0-0REL/Dron/README.md

# Dron CIC
[Ver](./doc/main.pdf) para detalles
