0-0REL/Dron/doc/main.tex

\documentclass[10pt]{article}  

%%%%%%%% PREÁMBULO %%%%%%%%%%%%
\title{Plantilla para Reportes Servicio Social y Practicas Profesionales}
\usepackage[spanish]{babel} %Indica que escribiremos en español
\usepackage[utf8]{inputenc} %Indica qué codificación se está usando ISO-8859-1(latin1)  o utf8
\usepackage{csquotes} % Requerido por biblatex con babel
\usepackage[style=ieee]{biblatex} % Sistema moderno de bibliografía
\addbibresource{Dron.bib} % Archivo de referencias
\usepackage{arydshln}
\usepackage{dirtree}

\usepackage{amsmath} % Comandos extras para matemáticas (cajas para ecuaciones,
% etc)
\usepackage{amssymb} % Símbolos matemáticos (por lo tanto)
\usepackage{graphicx} % Incluir imágenes en LaTeX
\usepackage{color} % Para colorear texto
\usepackage{subfigure} % sub figuras
\usepackage{float} %Podemos usar el especificador [H] en las figuras para que se
% queden donde queramos
\usepackage{capt-of} % Permite usar etiquetas fuera de elementos flotantes
% (etiquetas de figuras)
\usepackage{sidecap} % Para poner el texto de las imágenes al lado
	\sidecaptionvpos{figure}{c} % Para que el texto se alinie al centro vertical
\usepackage{caption} % Para poder quitar numeracion de figuras
\usepackage{commath} % funcionalidades extras para diferenciales, integrales,
% etc (\od, \dif, etc)
\usepackage{cancel} % para cancelar expresiones (\cancelto{0}{x})
 
\usepackage{anysize} 					% Para personalizar el ancho de  los márgenes
\marginsize{2cm}{2cm}{2cm}{2cm} % Izquierda, derecha, arriba, abajo

\usepackage{appendix}
\renewcommand{\appendixname}{Apéndices}
\renewcommand{\appendixtocname}{Apéndices}
\renewcommand{\appendixpagename}{Apéndices} 

% Para que las referencias sean hipervínculos a las figuras o ecuaciones y
% aparezcan en color
\usepackage[colorlinks=true,plainpages=false,citecolor=blue,linkcolor=blue]{hyperref}
%\usepackage{hyperref} 
% Para agregar encabezado y pie de página
\usepackage{fancyhdr} 
\pagestyle{fancy}
\fancyhf{}
\fancyhead[L]{\footnotesize Instituto Politécnico Nacional - Centro de Investigación en Computación} %encabezado izquierda
\fancyhead[R]{\footnotesize ESIME}   % dereecha
\fancyfoot[R]{\footnotesize Reporte}  % Pie derecha
\fancyfoot[C]{\thepage}  % centro
\fancyfoot[L]{\footnotesize Lab. Robótica y Mecatrónica}  %izquierda
\renewcommand{\footrulewidth}{0.4pt}

\usepackage{listings} % Para usar código fuente
\definecolor{dkgreen}{rgb}{0,0.6,0} % Definimos colores para usar en el código
\definecolor{gray}{rgb}{0.5,0.5,0.5} 
% configuración para el lenguaje que queramos utilizar
\lstset{language=Matlab,
   keywords={break,case,catch,continue,else,elseif,end,for,function,
      global,if,otherwise,persistent,return,switch,try,while},
   basicstyle=\ttfamily,
   keywordstyle=\color{blue},
   commentstyle=\color{red},
   stringstyle=\color{dkgreen},
   numbers=left,
   numberstyle=\tiny\color{gray},
   stepnumber=1,
   numbersep=10pt,
   backgroundcolor=\color{white},
   tabsize=4,
   showspaces=false,
   showstringspaces=false}

% C (configuración nueva)
\lstdefinestyle{c}{
    language=C,
    keywords={break,case,char,const,continue,default,do,double,else,
              enum,extern,float,for,goto,if,int,long,register,return,
              short,signed,sizeof,static,struct,switch,typedef,union,
              unsigned,void,volatile,while},
    basicstyle=\ttfamily\footnotesize,
    keywordstyle=\color{blue},
    commentstyle=\color{red!60!black},
    stringstyle=\color{green!50!black},
    numbers=left,
    numberstyle=\tiny\color{gray},
    stepnumber=1,
    numbersep=8pt,
    backgroundcolor=\color{white},
    tabsize=4,
    showspaces=false,
    showstringspaces=false,
    frame=tb,  % Marco solo arriba y abajo
    rulesepcolor=\color{lightgray}
}

\newcommand{\sen}{\operatorname{\sen}}	% Definimos el comando \sen para el seno
%en español

\title{Plantilla para Reportes Servicio Social y Practicas Profesionales}

%%%%%%%% TERMINA PREÁMBULO %%%%%%%%%%%%

\begin{document}

%%%%%%%%%%%%%%%%%%%%%%%%%%%%%%%%%% PORTADA %%%%%%%%%%%%%%%%%%%%%%%%%%%%%%%%%%%%%%%%%%%%
																					%%%
\begin{center}																		%%%
\newcommand{\HRule}{\rule{\linewidth}{0.5mm}}									%%%\left
 																					%%%
\begin{minipage}{0.48\textwidth} \begin{flushleft}
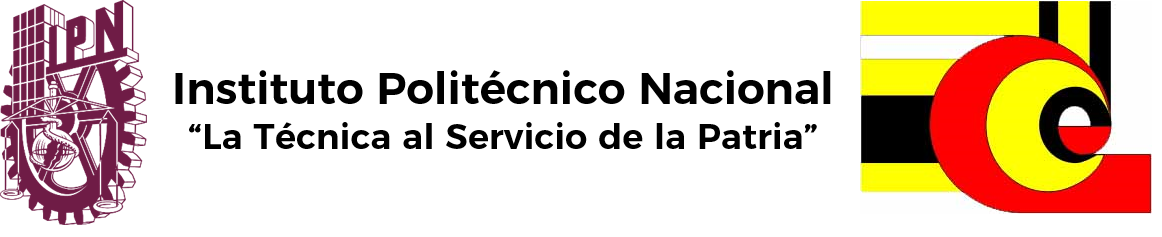
[picture p1: doc/Imagenes/nuist.png]

\end{flushleft}\end{minipage}
\begin{minipage}{0.48\textwidth} \begin{flushright}
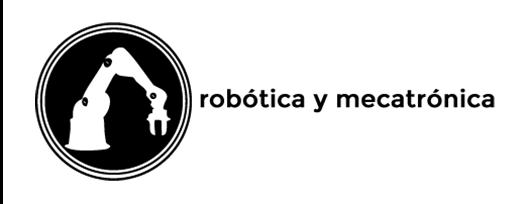
[picture p2: doc/Imagenes/rym2.png]

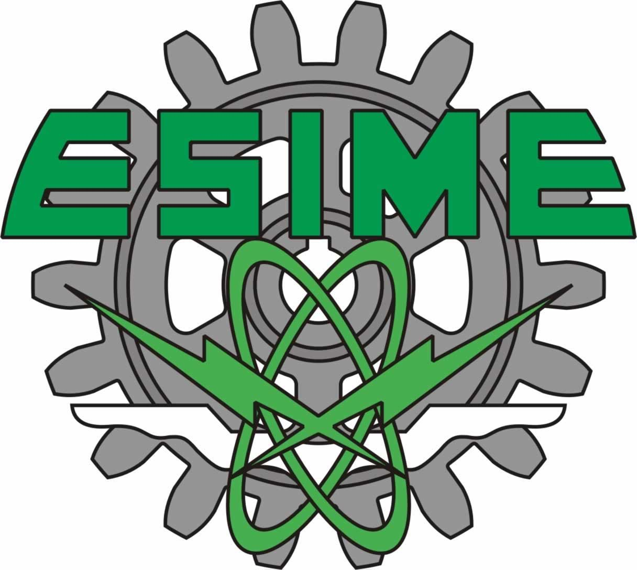
[picture p3: doc/Imagenes/esime.jpg]

\end{flushright}\end{minipage}

													 								%%%
\vspace*{1.0cm}								%%%
																					%%%	
\textsc{\huge Instituto Politécnico Nacional \\ \vspace{5px} Centro de Investigación en Computación \\	
\vspace{5px} Lab. Robótica y Mecatrónica}\\[0.25cm]	

\textsc{\LARGE \\ \vspace{5px} Practicas }\\[1.5cm]													%%%

\begin{minipage}{0.9\textwidth} 
\begin{center}																					%%%
\textsc{\LARGE Dron }
\end{center}
\end{minipage}\\[0.5cm]
%%%
    																				%%%
 			\vspace*{1cm}																		%%%
																					%%%
\HRule \\[0.4cm]																	%%%
{ \huge \bfseries Control de vuelo y detección y seguimiento de rostros}\\[0.4cm]	%%%
 																					%%%
\HRule \\[1.5cm]																	%%%
 																				%%%
																					%%%
\begin{minipage}{0.46\textwidth}													%%%
\begin{flushleft} \large															%%%

% Aqui a continuación pongan los nombres de los integrantes
\emph{Autores:}\\	
Rodrigo Emmanuel Arellano Flores
%%%
			%\vspace*{2cm}	
            													%%%
										 						%%%
\end{flushleft}																		%%%
\end{minipage}		
																%%%
\begin{minipage}{0.52\textwidth}		
\vspace{-0.6cm}											%%%
\begin{flushright} \large															%%%
\emph{Profesores:} \\	
Dr. Jesús Yaljá Montiel Pérez\\																%%%
Prof. Dr. Juan Humberto Sossa Azuela\\
												%%%
\end{flushright}																	%%%
\end{minipage}	
\vspace*{1cm}
%\begin{flushleft}
 	
%\end{flushleft}
%%%
% 		\flushleft{\textbf{\Large Nombre del curso (IMEC XXZZ)}	}\\																		%%%
\vspace{2cm} 																				
\begin{center}	
CDMX. \\
%{\large \today}																	%%%
 			\end{center}												  						
\end{center}							 											
																					
\newpage																		
%%%%%%%%%%%%%%%%%%%% TERMINA PORTADA %%%%%%%%%%%%%%%%%%%%%%%%%%%%%%%%

\tableofcontents 

\newpage

\section{Resumen.}
%Lo que se hizo, para qué sirve, cómo se hizo , qué resultados se obtuvieron, y porqué es importante haber logrado esto.  (de 120 palabras máximo).
%Ejemplo de cómo dar una cita bibliográfica
\section{Introducción.} 
%Lo que Ud. escriba aquí debe responder a las preguntas hechas por cualquier lector en el mundo: 
% ¿De qué se trata este trabajo?
% ¿Por qué estas personas hicieron este trabajo?
% ¿Por qué vale la pena leerlo, y a quienes le puede interesar leerlo?
% ¿Qué tiene de original o importante lo hecho aquí?
% ¿Qué tan difícil fue lograr los resultados que se muestran aquí?
% Puede incluir dibujos si los necesita para explicar y/o fotografías
\section{Información preliminar.}
% ¿ Qué otros trabajos o desarrollos similares se han hecho?
% ¿Cuál es la diferencia de este respecto a aquellos?
% ¿Qué modelos, teorías o cuerpos de conocimiento hay que tener presentes para leer el resto del trabajo presentado.
% NO REPITA lo que otros ya escribieron y presentaron en documentos digitales (web/o textos). 
% Describa lo que se necesita para entender SU trabajo en sus PROPIAS palabras.
% Necesariamente debe nombrar los documentos o autores a los que hace referencia (citelos) y sobretodo genere sus propios análisis al respecto.
% Solo haga mención explícita de lo que Ud. VA A usar en su trabajo. 
% Temas relacionados pero QUE NO se van a usar pueden mencionarse como citas.
\input{preliminar}
\section{Metodologías.}
% Diga cómo se hizo lo que ud. (o uds) hicieron.
% Sea claro y preciso.
% Si alguien quiere repetir su trabajo, debe poder usar esto como guía.
% Registre cada una de las iteraciones seguidas por sus procesos de diseño.
% Si hubo trabajo en equipo, aquí debe quedar especificada la participación de cada uno.
% Aquí deben estar registradas (como mínimo) los siguientes :
%  Diagramas de cuerpo libre,
%  diagramas de cortante y momentos,
%  diagramas de torsión,
%  cálculos de velocidades,
%  análisis de aceleraciones y
%  análisis de fuerzas,
%  análisis de fatiga si es el caso,
%  calculo de los factores de Marin y
%  uso de variables estocásticas,
% análisis de pandeo,
%  diseño de ejes,
%  diseño de sujetadores y uniones si los hay, etc
\input{metodologias}
\section{Conclusiones.}
%Explique por qué su diseño sirve (o nó) y qué hace falta por hacer.
%Responda las expectativas generadas en la Introducción.
%Analice sus resultados críticamente y diga si son creíbles y responda
%qué tan seguras son sus propuestas
\begin{figure}[H]
	\centering
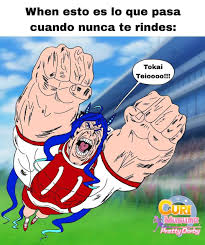
[picture p4: doc/Imagenes/turbo.jpeg]
	
	\caption{Esto es lo que pasa cuando nunca te rindes}
\end{figure}

%%%%%%% Bibliografía %%%%%%%%
\printbibliography[title={Referencias}]
%%%%%%% Bibliografía %%%%%%%%    

\appendix  
\clearpage % o \cleardoublepage
\addappheadtotoc 
\appendixpage 

\section{Memoria de cálculos.}
%Digitalice sus manuscritos y los procedimientos de cálculo utilizados. Deben ser legibles y claros.
%< Documentos escaneados> con algunas explicaciones.
%Si prefiere escribir todos sus cálculos usando fórmulas de LATEX hágalo a través de la metodología.
\section{Algoritmos.}
\lstinputlisting[language=C, breaklines=true, caption={AHRS Madwgick.h}]{../../rama-dron/navio2/include/AHRS/MadgwickAHRS.h}
\lstinputlisting[language=C, breaklines=true, caption={AHRS Madwgick.c}]{../../rama-dron/navio2/src/lib/AHRS/MadgwickAHRS.c}
 \section{Planos}
%Los planos del diseño presentado deben estar aquí. Generados por NX/Solid-edge.
\begin{center}
   
   
\end{center}
\end{document}
