0-0REL/Dron/doc/main.pdf

Instituto Politécnico Nacional - Centro de Investigación en Computación | ESIME

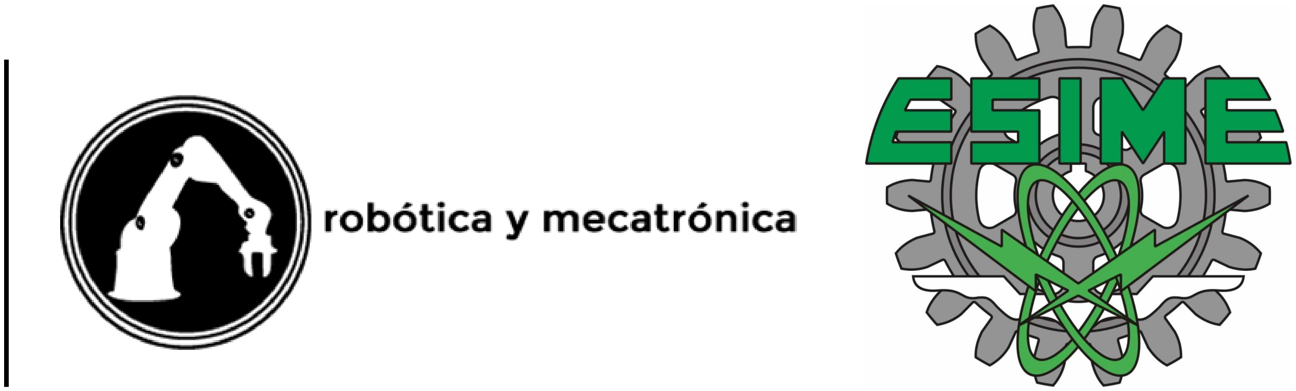
[picture p6: figure]
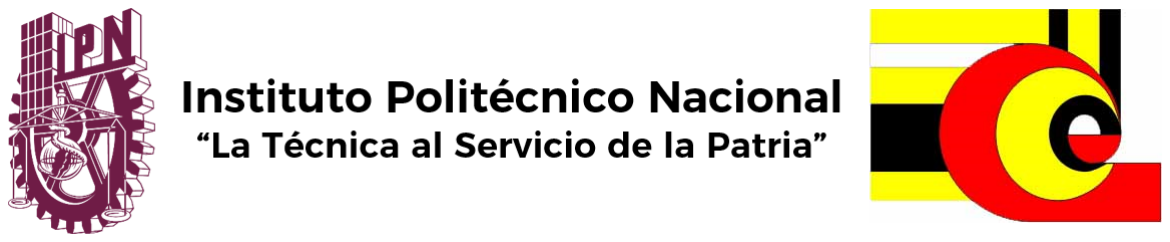
[picture p7: figure]

### Instituto Politecnico Nacional ´

Centro de Investigacion en Computaci ´ | on´
Lab. Robotica y Mecatr ´ | onica ´

Practicas

Dron

# Control de vuelo y detección y seguimiento de rostros

### Autores: Rodrigo Emmanuel Arellano Flores

### Profesores: Dr. Jesús Yaljá Montiel Pérez Prof. Dr. Juan Humberto Sossa Azuela

CDMX.

Lab. Robótica y Mecatrónica | 1 | Reporte

## Índice

1. Resumen. | 3
2. Introducción. | 3
3. Información preliminar. | 3
4. Metodologías. | 6
5. Conclusiones. | 17
Apéndices | 18
A. Memoria de cálculos. | 18
B. Algoritmos. | 18
C. Planos | 25
Lab. Robótica y Mecatrónica | 2 | Reporte

1. Resumen.
2. Introducción.
3. Información preliminar.

### 3.1. Orden del repositorio

El repositorio se encuentra en GitHub (https://github.com/0-0REL/Dron) y se divide en tres ramas
Dron
main | #Rama principal
ArduPilot/ | Desarrollo con el AMP2.6
bash scripts/ | Scripts para iniciar GCS o simulación
Dron/ | Logs de pruebas de vuelo
MAVLink/ | Pruebas con MAVLink
MP Python scripts/ | Pruebas con scripts de Mission Planner
sik-radio-config/ | Reconfiguración de radios
simulaciones/ | Resultados de simulaciones del articulo
Complementos/ | Software auxiliar
CAD | Modelos 3D en Inventor
Modelos/ | Modelos para Detección
doc/ | Este archivo
MATLAB/ | Simulacion en simulink y desarrollo de controladores
control pid/
simmat/
simulink/
Navio2/ | Logs de dron con Navio2
magnetometro/ | Calibración de magnetómetro
ROS/
visualizacion/ | Visualizar orientación
OpenCV/
prototipo/ | Versión funcional
pruebas/
TensorFlow/ | Entrenamiento de modelo de reconocimiento
dataset/
apm-ros-jazzy | #Rama con paquetes ROS-Jazzy para simulación
mav ctrl/
vision/
ros-pkg-navio | #Rama con paquetes ROS-Noetic para navio2
navio2/ | Procesamiento de sensores
sys ctrl/ | Controlador de vuelo
vision/ | Detección de rostros
El HAT Navio2 es compatible con las Raspberry Pi 2, 3 y 4. La imagen del sistema necesaria se encuentra aquí. (https://docs.emlid.com/navio2/configuring-raspberry-pi/) El sistema no tiene interfaz gráfica y funciona en arquitectura armv7l.
Para poder establecer un acceso remoto al Raspberry del dron incluso fuera de red local, se puede usar el servicio VPN de Tailscale. (https://tailscale.com/kb/1017/install)

### 3.2. Componentes del cuadricóptero

El dron cuenta con los siguientes componentes:

4 Motores sin escobillas (BLDC)

4 Control de velocidad electrónico (ESC)

1 Batería LiPo 11.1 V

Lab. Robótica y Mecatrónica | 3 | Reporte

1 Computadora de vuelo, cuenta con:

- IMU (acelerómetro, giroscopio y magnetómetro)
- Barómetro

1 Chasis

2 Helices CW

2 Helices CCW

### 3.3. Control del cuadricóptero

El dron utiliza un marco X y el orden de los motores asi como su dirección de giro se puede ver en la figura 1.

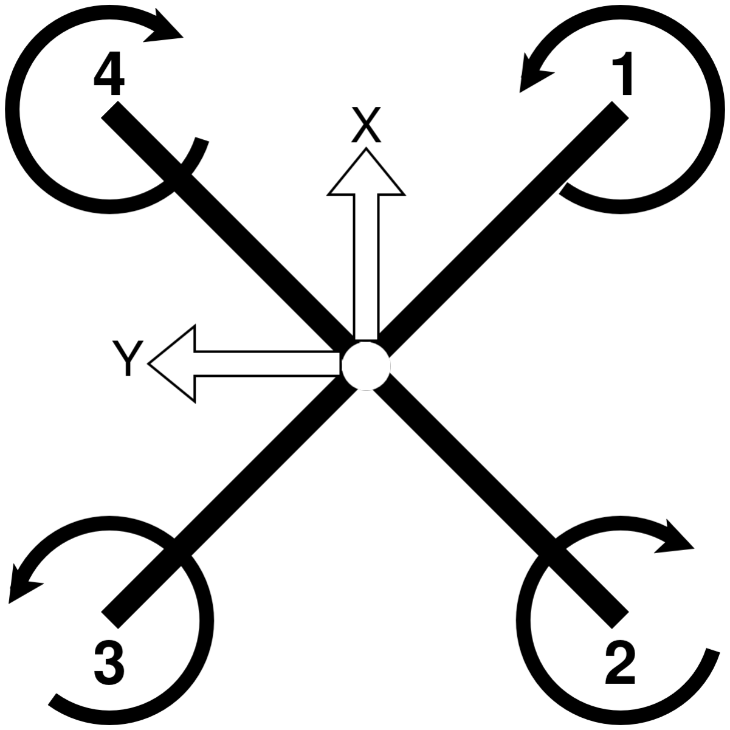
[picture p8: figure]

Figura 1: Marco

El par y empuje generados por cada motor están dados por:

Fi = KF ω

2
i

(1)

τi = KMω

2
i

(2)

De modo que la relación entre la acción de cada motor y las entradas de control se relacionan de la siguiente forma

F
τx
τy
τz

=

KF | KF | KF | KF
−KF L −KF L | KF L | KF L
−KF L | KF L | KF L | −KF L
−KM | KM | −KM | KM

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
El modelo dinámico del dron se puede linealizar el modelo del dron mediante la serie de Taylor [1]

x˙ = f(x, u)x0,u0 +

∂
∂x

f(x, u)

(x0,u0)

(x − x0) + ∂
∂u

f(x, u)

(x0,u0)
(u − u0) = Ax + Bu | (4)

x0 = 012×1

u0 =

mg 0 0 0T

El modelo en espacio de estados se puede convertir a funciones de trasferencia mediante

G(s) = C [sI − A]

−1 B + D | (5)

El controlador PD tiene la siguiente estructura

P D(s) = KP + KDs = KD(s + a) | (6)

KP = aKD

Lab. Robótica y Mecatrónica | 4 | Reporte

El controlador PID tine la siguiente estructura

P ID(s) = KP +

KI
s

+ KDs = KD

(s + a)(s + b)
s

(7)

KI = abKD

KP = (a + b)KD

Seguimiento de referencia en control en espacio de estados Precompensador discreto [2]
u(k) = −Kx(k) + Nr(k) | (8)

N = [Cd[I − Ad + BdK]

−1Bd]

−1
(9)

Modelo Interno para entrada escalón [2]
x(k + 1)

e(k + 1)
=
A 0

−C I x(k)
e(k)
+
B
0
u(k) | (10)

u(t) = −Kx(k) − Kee(k)

### 3.4. Procesamiento de sensores

### 3.4.1. IMU

Se pueden estimar los ángulos de orientación roll (ϕ) y pitch (θ) mediante un filtro complementario (11) que es una forma simple de fusionar la información del giroscopio y acelerómetro. Sin embargo, al ser una técnica simple esta limitado a movimientos suaves aun asi puede ser utilizado para lograr estabilización del dron.

θ = α(θ(k − 1) + ωgyroT) + (1 − α)θacc(k) | (11)

ϕacc = p

accy
acc²

x + acc²
z

(12)

θacc = −q

accx

acc²

y + acc²
z

(13)

El rumbo (yaw → ψ) se puede obtener mediante

ψ = atan2(magy, magx) − δ | (14)

La declinación magnética (δ) se puede obtener de [3]. Una mejor forma de obtener la orientación espacial del dron es mediante un algoritmo AHRS (Attitude and Heading Reference System), el filtro Mahony y Madgwick son dos excelentes opciones por su baso costo computacional, se selecciona el filtro Madgwick ya que es más preciso que el Mahony y Kalman [4], aunque no mejor que el Kalman extendido [5]. El algoritmo proporciona la orientación en cuaterniones, los cuales pueden ser convertidos a ángulos de Euler mediante.

ϕ = atan2(2(q0q1 + q2q3), 1 − 2(q1q1 + q2q2)) | (15)
θ = asin(2(q0q2 − q3q1)) | (16)
ψ = atan2(2(q0q3 + q1q2), 1 − 2(q2q2 + q3q3)) | (17)

### 3.4.2. Barómetro

La altura ortométrica [6] se calcula con la información del barómetro mediante la siguiente ecuación

Hb =

Ts
kT

pb
ps

RkT
g0 − 1

!
(18)

Donde:

Lab. Robótica y Mecatrónica | 5 | Reporte

R 287.1 J/kgK

kT 6.5×10⁻³ K/m

g0 9.80665 m/s²

ps 101.325 kPa

Ts 288.15 K

4. Metodologías.

### 4.1. Medición de empuje

Para estimar KF de (1) se mide el empuje generado cada 10 % de cambio en la velocidad del motor. Las siguientes medidas fueron realizadas a 11.2 V, el motor y hélice tienen una masa de 120 g.

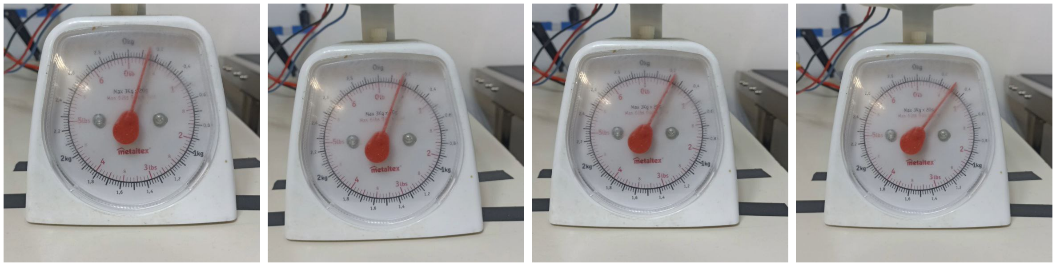
[picture p9: figure]

(a) 1100 ms → 140 g | (b) 1200 ms → 170 g | (c) 1300 ms → 220 g | (d) 1400 ms → 300 g

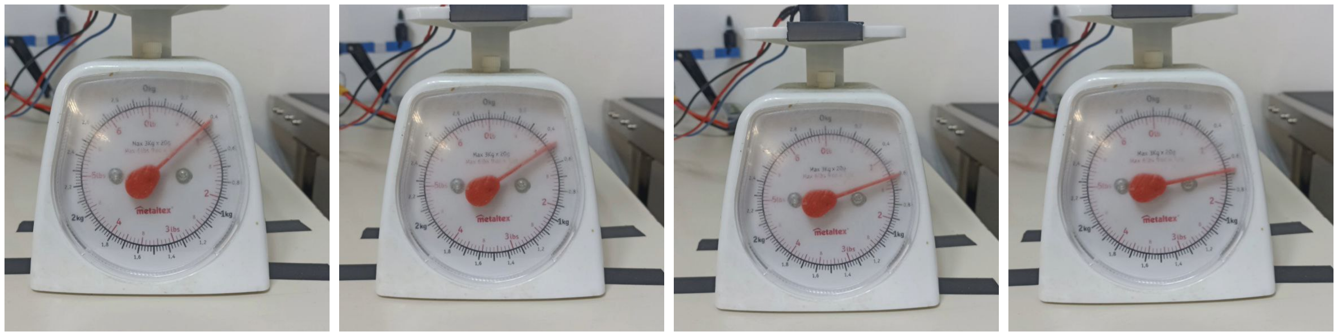
[picture p10: figure]

(e) 1500 ms → 400 g | (f) 1600 ms → 490 g | (g) 1700 ms → 600 g | (h) 1800 ms → 670 g

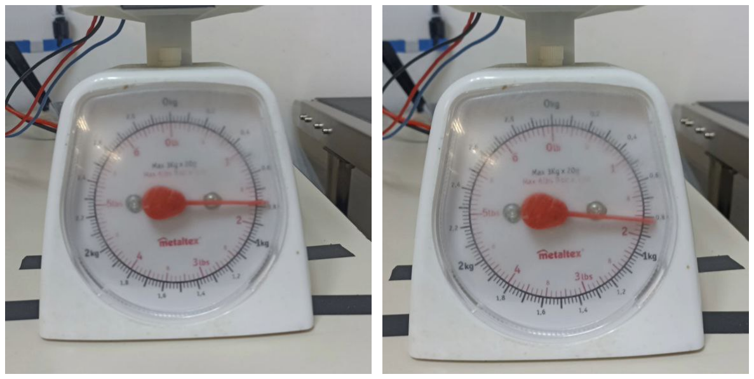
[picture p11: figure]

(i) 1900 ms → 770 g | (j) 2000 ms → 820 g

Figura 2: Medición de empuje

Lab. Robótica y Mecatrónica | 6 | Reporte

Cuadro 1: Medición prueba de empuje

Señal ( %) | Medido (g) | Empuje (g)
0 | 120 | 0
10 | 140 | 20
20 | 170 | 50
30 | 220 | 100
40 | 300 | 180
50 | 400 | 280
60 | 490 | 370
70 | 600 | 480
80 | 670 | 550
90 | 770 | 650
100 | 820 | 700

Con estos datos se puede ajustar la curva para obtener KF = 7,965 N/ %²

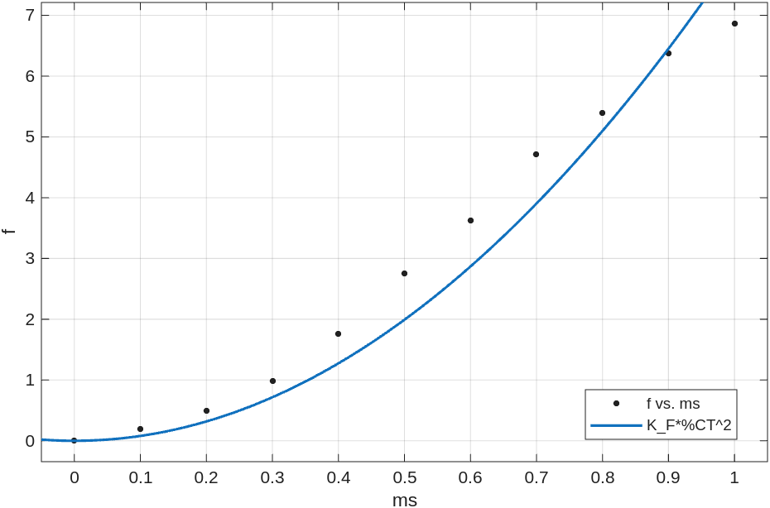
[picture p12: figure]

Figura 3: Ajuste de curva

Lab. Robótica y Mecatrónica | 7 | Reporte

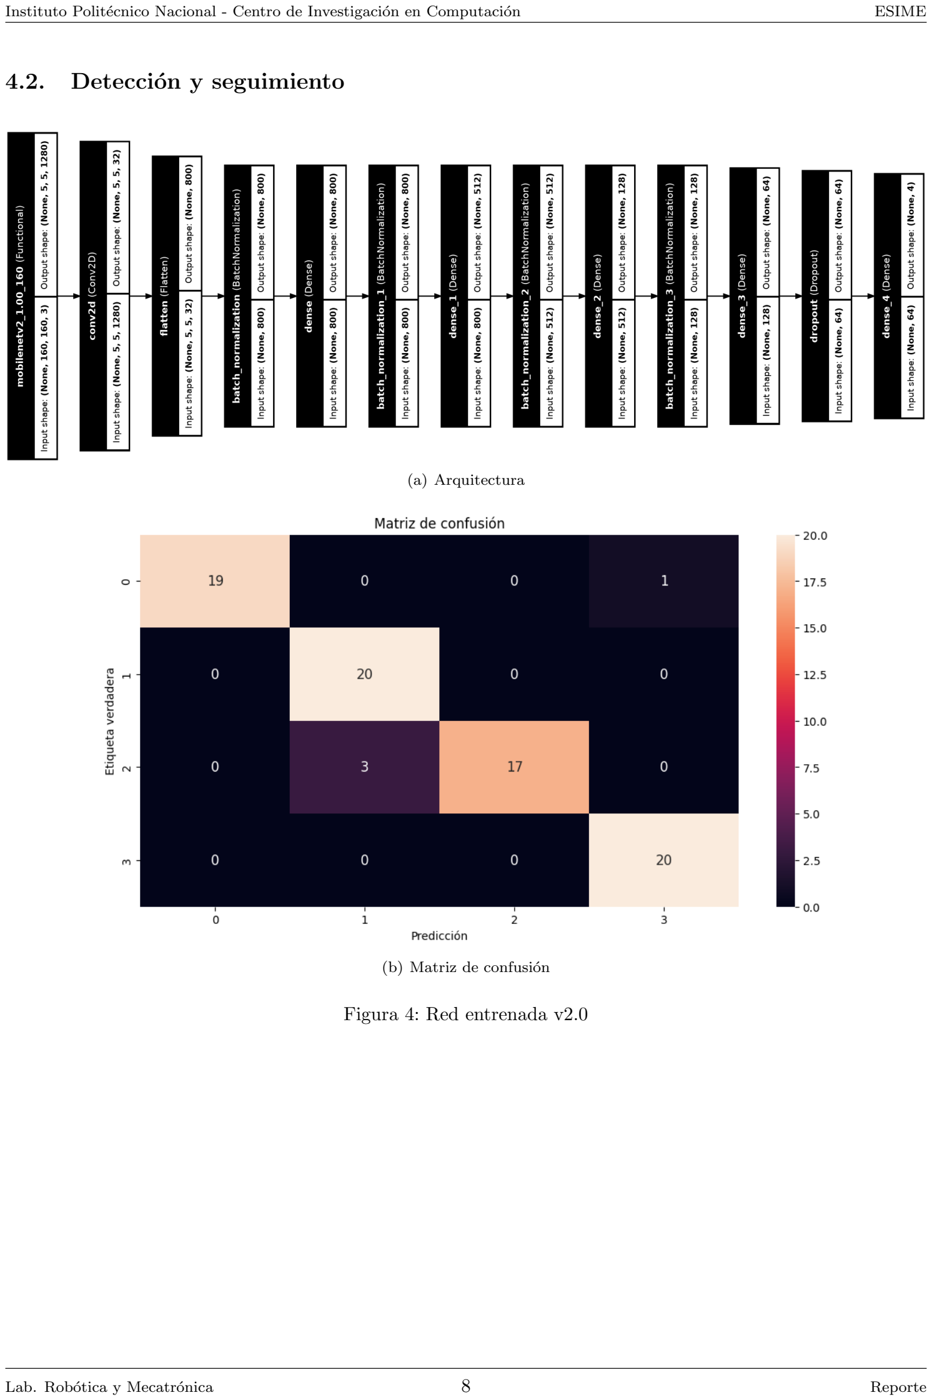
[picture p13: page 8]

### 4.2. Detección y seguimiento

(a) Arquitectura
(b) Matriz de confusión

Figura 4: Red entrenada v2.0

Lab. Robótica y Mecatrónica | 8 | Reporte

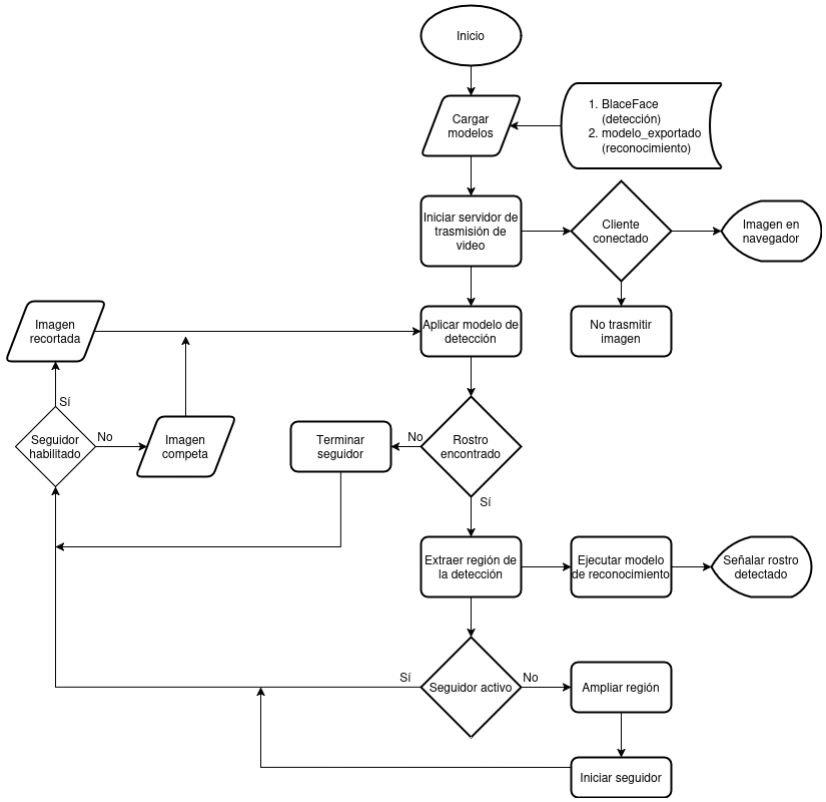
[picture p14: figure]

Figura 5: aBlaze.py

### 4.3. Dinámica

El modelo dinámico del cuadricóptero es

m¨r = Rϕ,θ,ψ

0
0
F
- −

0
0
mg
- − Ff | (19)
M(η)η¨ = τ − C(η, η˙)η˙ − τ f | (20)

De (3) se obtiene la relación entre entradas de control y actuadores

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
4 KF

−

1
4 KF L −

1
4 KF L −

1
4 KM 1

4 KF

−

1
4 KF L

1
4 KF L

1
4 KM 1

4 KF

1
4 KF L

1
4 KF L −

1
4 KM 1

4 KF

1
4 KF L −

1
4 KF L

1
4 KM

F
τx
τy
τz

(21)

Lab. Robótica y Mecatrónica | 9 | Reporte

Cuadro 2: Parámetros del dron

m | 1.6 | kg
Ixx | 0.021915027 | kgm²
Iyy | 0.022124548 | kgm²
Izz | 0.042349865 | kgm²
L | 0.23 | m
KF | 7.965 | N/ %²
KM | 0.5 | Nm/ %²
Km | 50.0565 | s⁻¹

### 4.3.1. Linealización

Mediante la serie de Taylor (4) el modelo del cuadricóptero se puede expresar de forma lineal de la siguiente forma

r˙
¨r
η˙
η¨

=

03×3 | I3×3 | 03×3 | 03×3
03×3 | 03×3 | G(ψd) 03×3
03×3 | 03×3 | 03×3 | I3×3
03×3 | 03×3 | 03×3 | 03×3

r
r˙
η
η˙

+

05×1 | 05×3
m⁻¹ | 01×3
03×1 | 03×3
03×1 | Id

F
τ
(22)

donde:

r =

x
y
z
- , η =

ϕ
θ
ψ
- , τ =

τx
τy
τz

G(ψd) =

0 g 0
−g 0 0
0 0 0
- , Id = diag
I

−1

xx , I⁻¹

yy , I⁻¹

zz

### 4.4. Algoritmos de control

### 4.4.1. PD

El controlador se ajusta usando funciones de trasferencia, que se obtienen mediante (5), con

C =

I3×3 | 03×3 | 03×3 | 03×3
03×3 | 03×3 | I3×3 | 03×3

D = 06×4

Gx(s) = g Iyys

4

(23)

Gy(s) = − | g Ixxs

4

(24)

Gz(s) = 1
| ms²

(25)

Gϕ(s) = 1 Ixxs

2

(26)

Gθ(s) = 1 Iyys

2

(27)

Gψ(s) = 1 Izzs

2

(28)

Dado que no se puede medir los desplazamientos en x y y, solo se realizan 4 de los 6 controladores (control de orientación y altura). El cambio de velocidad en los motores no es instantáneo, por lo que las ecuaciones (25)-(28) se multiplican por (29), que es la función de trasferencia de los motores, para incluir el retraso.

ω˙(t) = Km(ωd(t) − ω(t)) → | ω(s) ωd(s)
=

Km
s + Km

(29)

Lab. Robótica y Mecatrónica | 10 | Reporte

Para ajustar los controladores se utiliza el método de colocación de las raíces, de modo que (25) a (28) se convierten en

KDz

(s + az)

Km
m
s

2(s + Km)

(30)

KDϕ

(s + aϕ)

Km
Ixx
s

2(s + Km)

(31)

KDθ

(s + aθ)

Km
Iyy
s

2(s + Km)

(32)

KDψ

(s + aψ)

Km
Izz
s

2(s + Km)

(33)

Con la ayuda MATLAB se ajustan los ceros y ganancias hasta obtener los siguiente resultados.

Cuadro 3: Ganancias PD

| KP | KD
Altura | 32.9186 | 20.994
Roll | 1.498320 | 0.352480
Pitch | 1.512645 | 0.355850
Yaw | 2.895440 | 0.681153

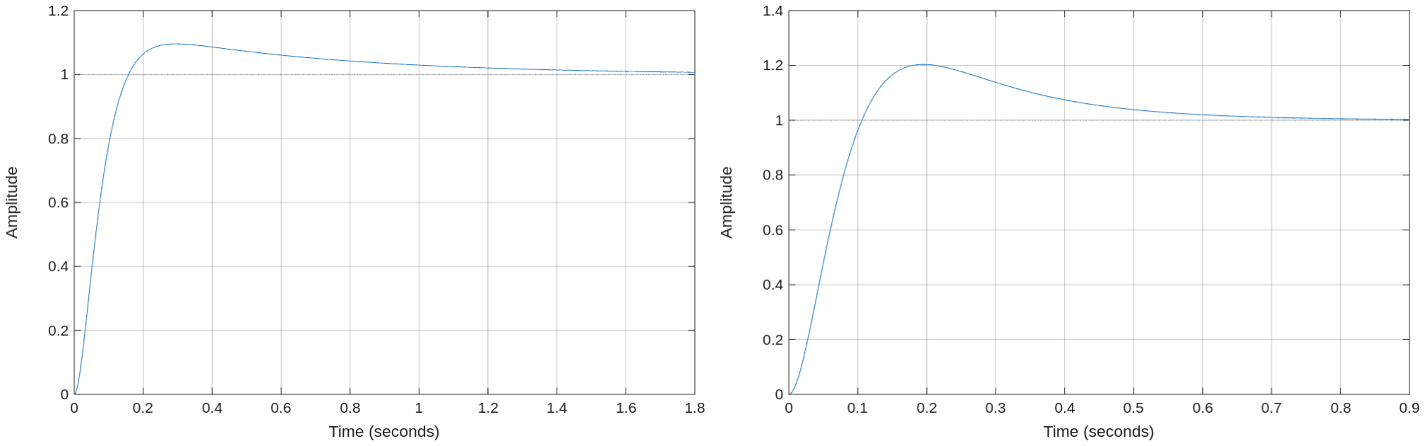
[picture p15: figure]

(a) Altura | (b) Roll

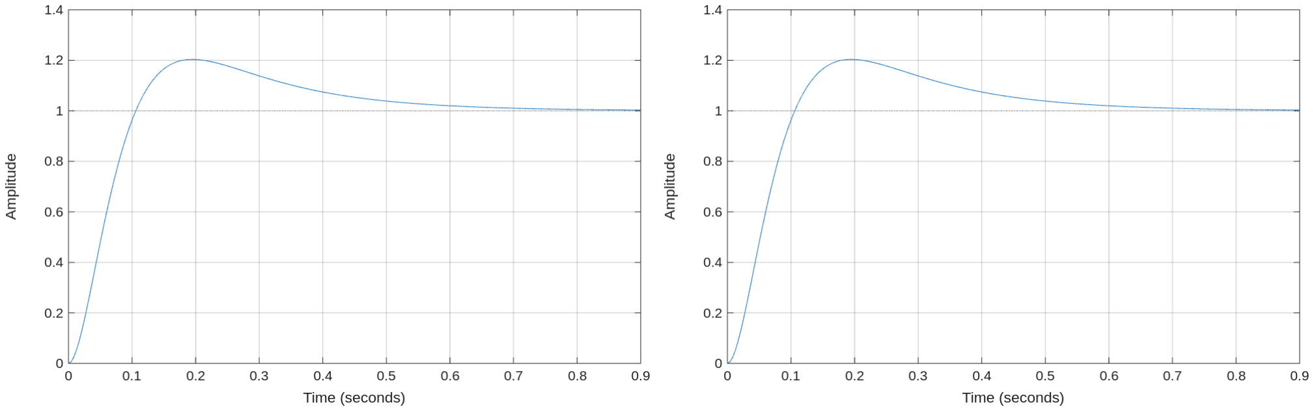
[picture p16: figure]

(c) Pitch | (d) yaw

Figura 6: Respuesta escalón PD

Lab. Robótica y Mecatrónica | 11 | Reporte

### 4.4.2. PID

De forma similar se ajustan las ganancias del controlador, para este caso se usan

KDz

(s + az)(s + bz)

Km
m
s

2(s + Km)

(34)

KDϕ

(s + aϕ)(s + bϕ)

Km
Ixx
s

2(s + Km)

(35)

KDθ

(s + aθ)(s + bθ)

Km
Iyy
s

2(s + Km)

(36)

KDψ

(s + aψ)(s + bψ)

Km
Izz
s

2(s + Km)

(37)

Cuadro 4: Ganancias PID

| KP | KI | KD
Altura | 29.28 | 0.8 | 38.21
Roll | 1.016 | 0.08 | 0.2
Pitch | 2.873 | 1.173 | 0.6391
Yaw | 3.329 | 1.211 | 2.288

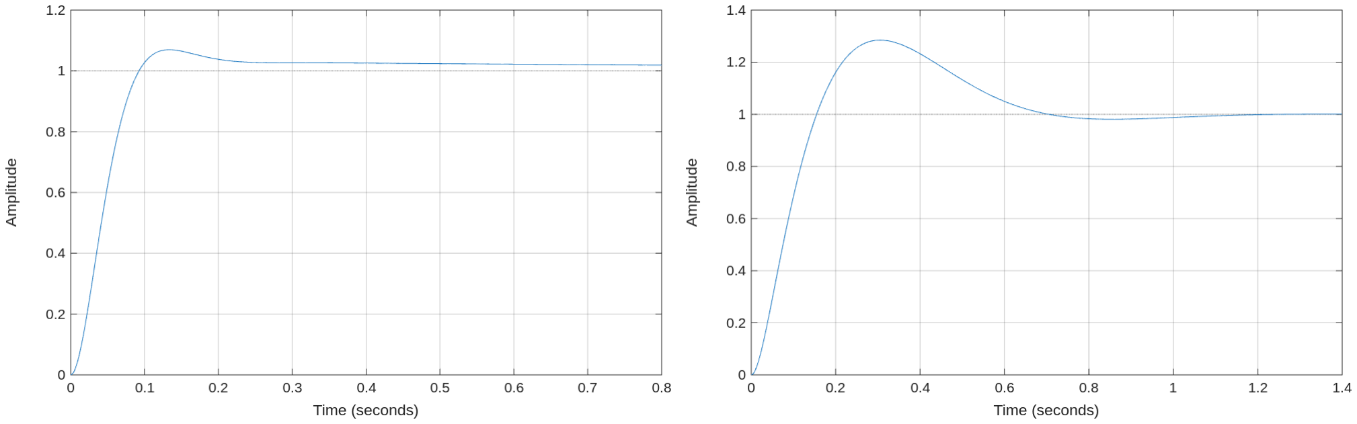
[picture p17: figure]

(a) Altura | (b) Roll

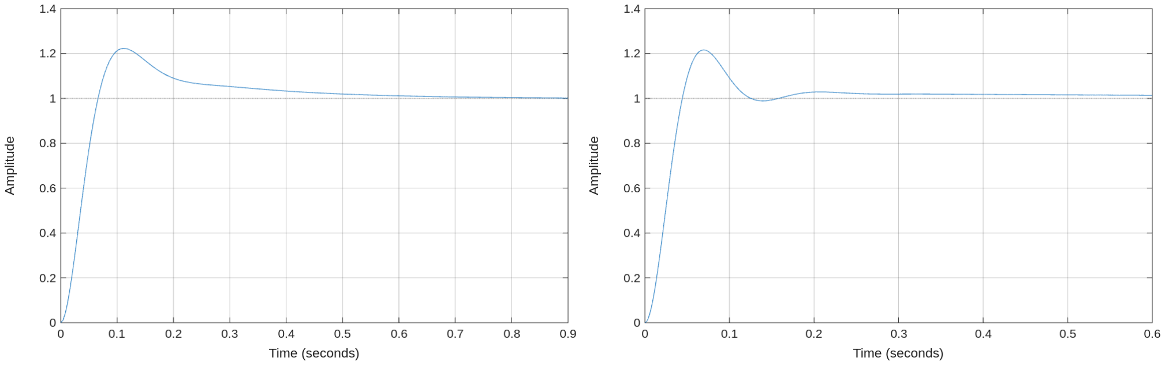
[picture p18: figure]

(c) Pitch | (d) Yaw

Figura 7: Respuesta escalón PID

### 4.4.3. LQI

El modelo en espacio de estados se discretiza a una frecuencia de muestreo de 510 Hz, se aumenta el modelo de forma como en (10), las ganancias se obtienen como LQR con

R = diag(-R Re

)

R =

10⁻² 0,1

−2 0,4363⁻² 0,4363⁻² 0,4363⁻² 0,0017⁻² 0,0017⁻² 0,0017⁻²
Lab. Robótica y Mecatrónica | 12 | Reporte

Re =

10⁻² 0,2618⁻² 0,2618⁻² 0,2618⁻²

Q = diag(-

1 0,0625 0,0625 0,0625
)

Las ganancias del controlador son:

K =

38,8651 14,9073 | 0 | 0 | 0 | 0 | 0 | 0
0 | 0 | 29,1816 | 0 | 0 | 11,2049 | 0 | 0
0 | 0 | 0 | 29,4606 | 0 | 0 | 11,3121 | 0
0 | 0 | 0 | 0 | 56,3886 | 0 | 0 | 21,6517

Ke =

−0,0991 | 0 | 0 | 0
0 | −0,0743 | 0 | 0
0 | 0 | −0,0750 | 0
0 | 0 | 0 | −0,1436

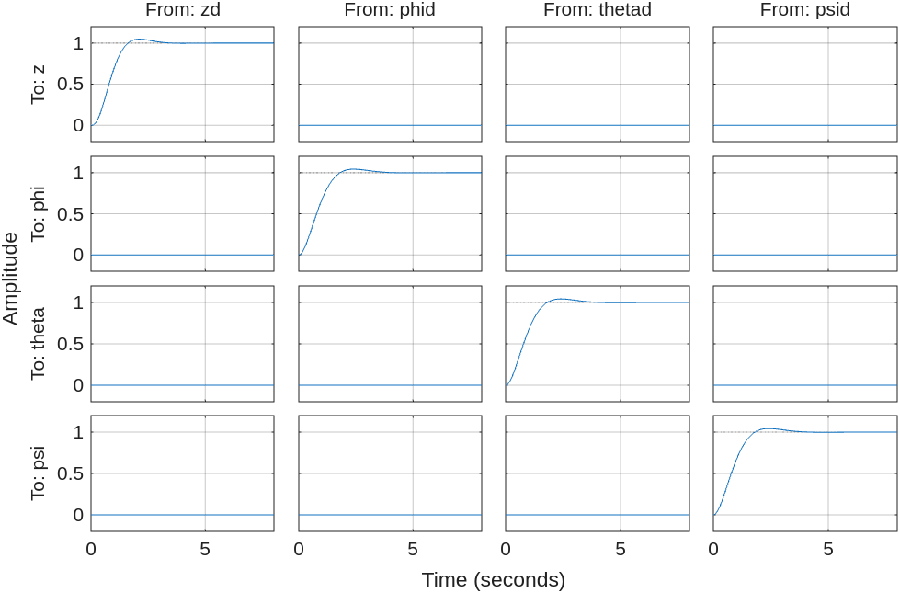
[picture p19: figure]

Figura 8: Respuesta escalón LQI

4.5. Resultados.

Controlador PD:

uz(k) = KP ze(k) + KDz

e(k) − e(k − 1)
T
+ mg | (38)

uη(k) = KP ηe(k) + KDη

e(k) − e(k − 1)
T

(39)

Lab. Robótica y Mecatrónica | 13 | Reporte

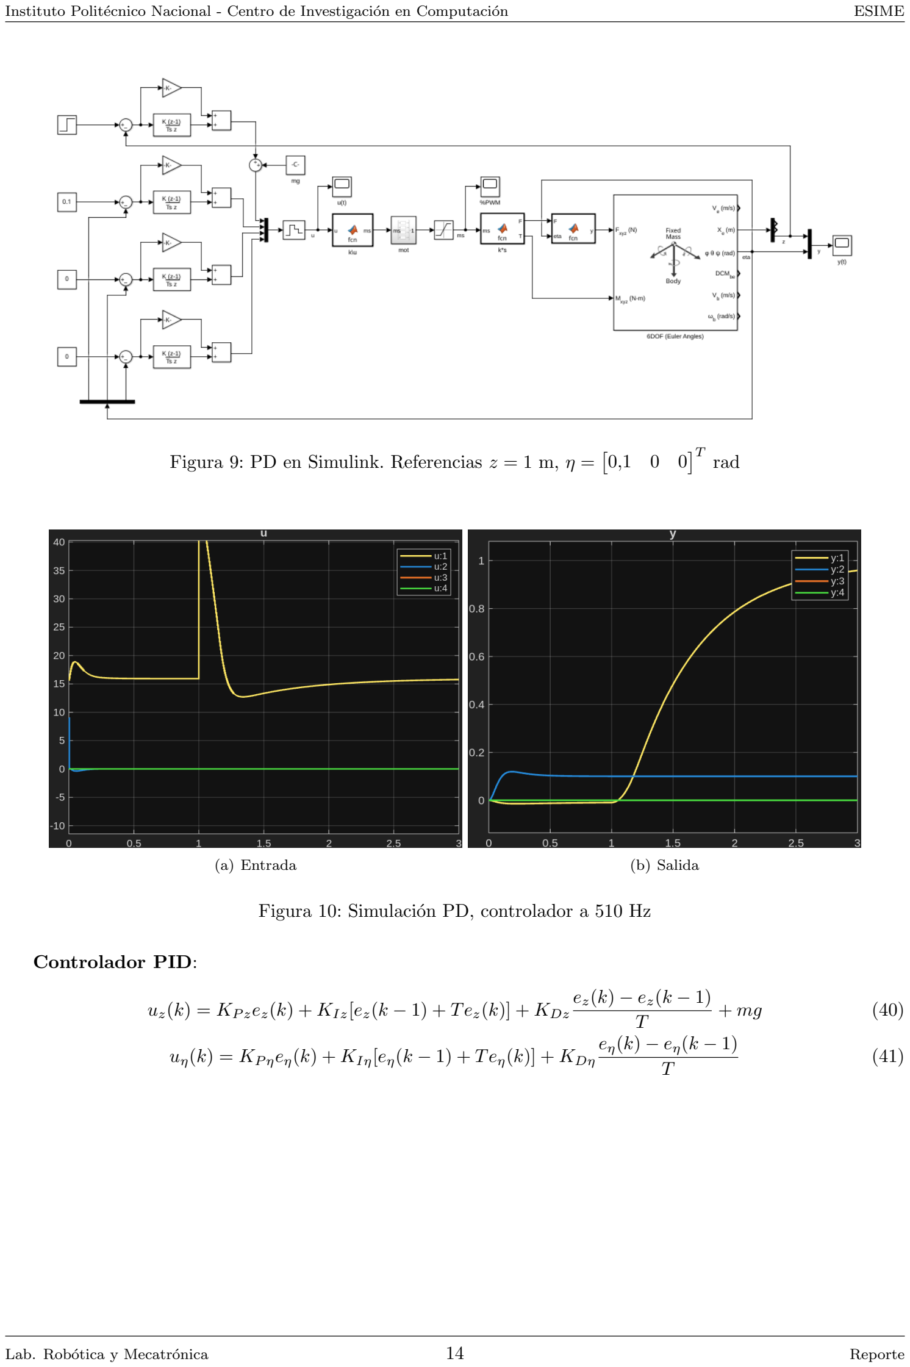
[picture p20: page 14]

Figura 9: PD en Simulink. Referencias z = 1 m, η =

0,1 0 0T
rad
(a) Entrada | (b) Salida

Figura 10: Simulación PD, controlador a 510 Hz

Controlador PID:

uz(k) = KP zez(k) + KIz[ez(k − 1) + T ez(k)] + KDz

ez(k) − ez(k − 1)
T
+ mg | (40)

uη(k) = KP ηeη(k) + KIη[eη(k − 1) + T eη(k)] + KDη

eη(k) − eη(k − 1)
T

(41)

Lab. Robótica y Mecatrónica | 14 | Reporte

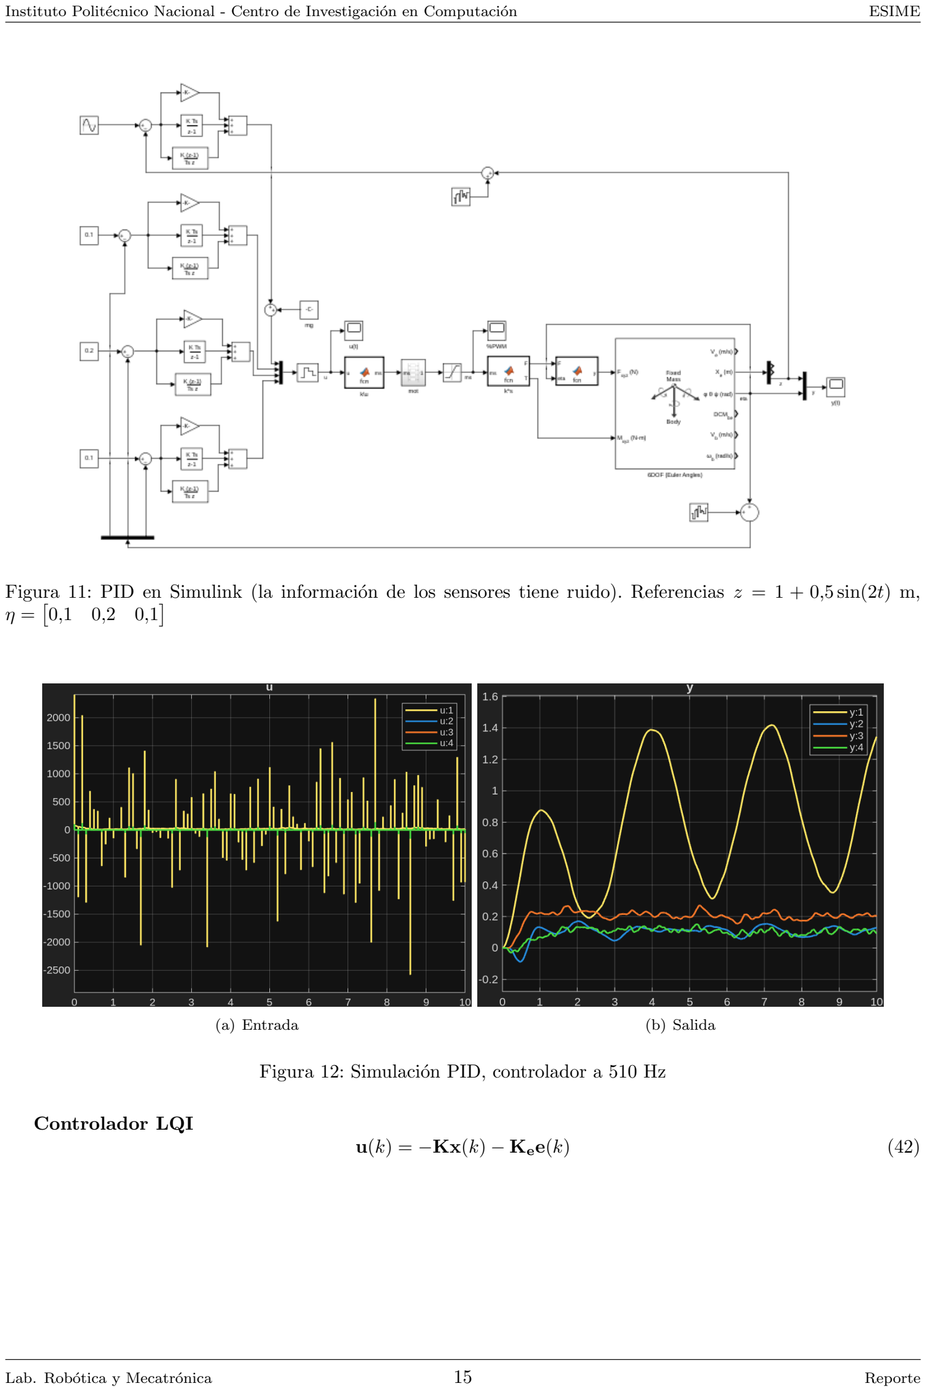
[picture p21: page 15]

Figura 11: PID en Simulink (la información de los sensores tiene ruido). Referencias z = 1 + 0,5 sin(2t) m, η =

0,1 0,2 0,1

(a) Entrada | (b) Salida

Figura 12: Simulación PID, controlador a 510 Hz

Controlador LQI
u(k) = −Kx(k) − Kee(k) | (42)
Lab. Robótica y Mecatrónica | 15 | Reporte

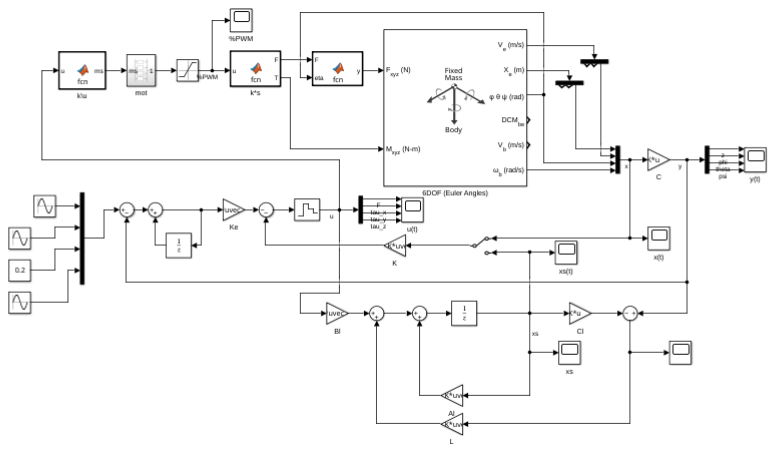
[picture p22: figure]

Figura 13: LQI en Simulink. Referencias z = 1 + sin(2t) m, η =

0,3 sin(0,3t) 0,2 sin(t)

T
rad

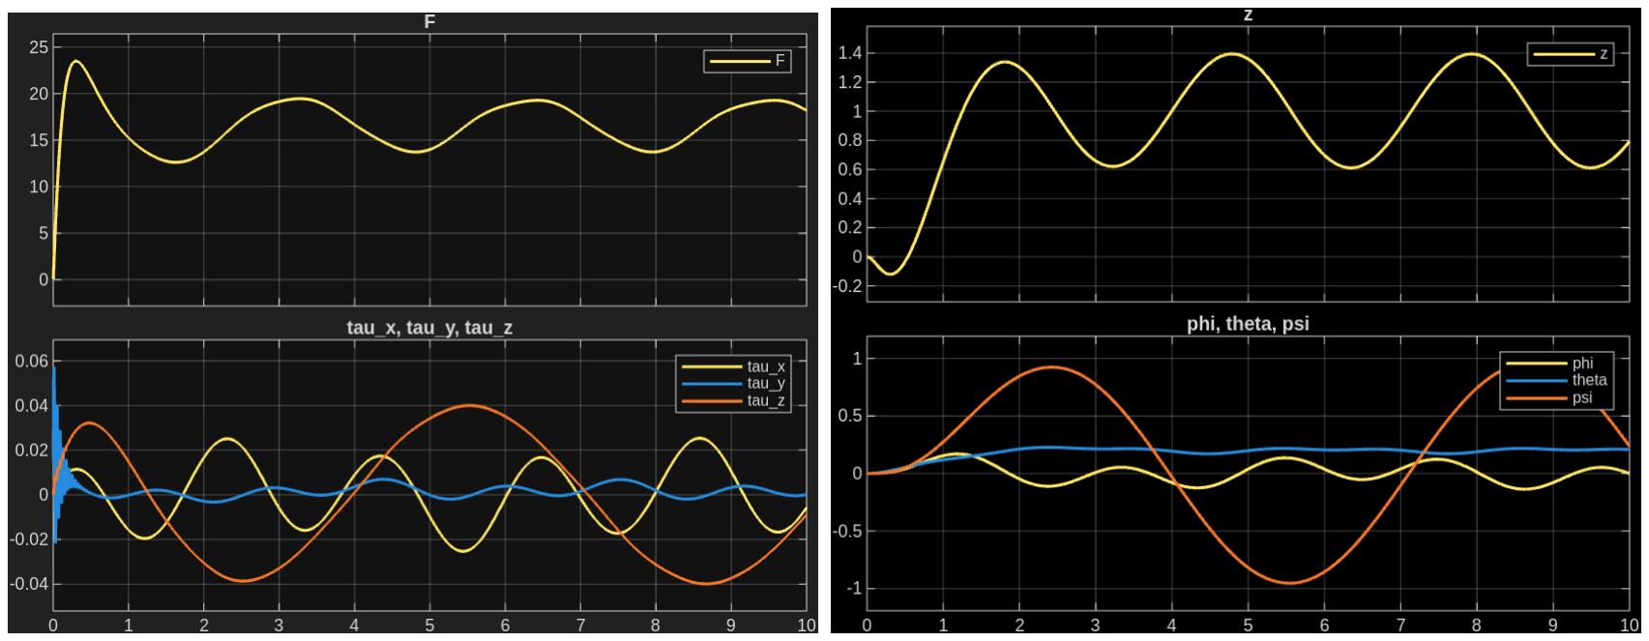
[picture p23: figure]

(a) Entrada | (b) Salida

Figura 14: Simulación LQI, controlador a 510 Hz

Lab. Robótica y Mecatrónica | 16 | Reporte

5. Conclusiones.

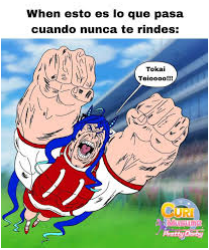
[picture p24: figure]

Figura 15: Esto es lo que pasa cuando nunca te rindes

## Referencias

[1] C. Powers, D. Mellinger y V. Kumar, ✭✭Quadrotor Kinematics and Dynamics,✮✮ en Handbook of Unmanned Aerial Vehicles, Springer, Dordrecht, 2015, págs. 307-328, isbn: 978-90-481-9707-1. doi: 10.1007/978-90-481-9707-1_71. (https://doi.org/10.1007/978-90-481-9707-1_71) visitado 7 de dic. de 2025. dirección: https://link.springer.com/rwe/10.1007/978-90-481-9707-1_71. (https://link.springer.com/rwe/10.1007/978-90-481-9707-1_71)
[2] M. S. Fadali y A. Visioli, ✭✭Servo problem,✮✮ en Digital control engineering Analysis and design, 2.a ed., Elsevier, 2013, págs. 367-371, isbn: 978-0-12-394391-0.
[3] N. G. D. Center. ✭✭NCEI Geomagnetic Calculators,✮✮ visitado 17 de dic. de 2025. dirección: https://www.ngdc.noaa.gov/geomag/calculators/magcalc.shtml#declination.
[4] S. O. H. Madgwick, A. J. L. Harrison y R. Vaidyanathan, ✭✭Estimation of IMU and MARG Orientation Using a Gradient Descent Algorithm,✮✮ en 2011 IEEE International Conference on Rehabilitation Robotics, jun. de 2011, págs. 1-7. doi: 10.1109/ICORR.2011.5975346. (https://doi.org/10.1109/ICORR.2011.5975346) visitado 7 de dic. de 2025. dirección: https: //ieeexplore.ieee.org/document/5975346.
[5] A. Cavallo et al., ✭✭Experimental Comparison of Sensor Fusion Algorithms for Attitude Estimation,✮✮ IFAC Proceedings Volumes, 19th IFAC World Congress, vol. 47, n.o 3, págs. 7585-7591, 1 de ene. de 2014, issn: 1474-6670. doi: 10.3182/20140824- 6- ZA- 1003.01173. (https://doi.org/10.3182/20140824-6-ZA-1003.01173) visitado 8 de dic. de 2025. dirección: https: //www.sciencedirect.com/science/article/pii/S1474667016428089.
[6] P. D. Groves, ✭✭Barometric Altimeter,✮✮ en Principles of GNSS, inertial, and multisensor integrated systems, 2.a ed., Artech House, 2013, págs. 230-231, isbn: 978-1-60807-005-3.
Lab. Robótica y Mecatrónica | 17 | Reporte

# Apéndices

A. Memoria de cálculos.
B. Algoritmos.

Listing 1: AHRS Madwgick.h 1 //
=====================================================================================================
2 | // MadgwickAHRS .h
3 | //
=====================================================================================================
4 | //
5 | // Implementation of Madgwick ’s IMU and AHRS algorithms .
6 | // See : http :// www .x-io.co.uk/ node /8# open_source_ahrs_and_imu_algorithms
7 | //
8 | // Date | Author | Notes
9 | // 29/09/2011 | SOH Madgwick | Initial release
10 | // 02/10/2011 | SOH Madgwick | Optimised for reduced CPU load
11 | //
12 | //
=====================================================================================================
13 | # ifndef MadgwickAHRS_h
14 | # define MadgwickAHRS_h

15

16 //

17 // Variable declaration

18
19 | extern volatile float beta ; | // algorithm gain
20 | extern volatile float q0 , q1 , q2 , q3 ; | // quaternion of sensor frame
relative to auxiliary frame

21

22 //

23 // Function declarations

24
25 void MadgwickAHRSupdate ( float gx , float gy , float gz , float ax , float ay , float az , float mx , float my , float mz ) ;
26 | void MadgwickAHRSupdateIMU ( float gx , float gy , float gz , float ax , float ay ,
| float az ) ;

27
28 | # endif
29 | //
=====================================================================================================
30 | // End of file
31 | //
Lab. Robótica y Mecatrónica | 18 | Reporte

=====================================================================================================

Listing 2: AHRS Madwgick.c 1 //
=====================================================================================================
2 | // MadgwickAHRS .c
3 | //
=====================================================================================================
4 | //
5 | // Implementation of Madgwick ’s IMU and AHRS algorithms .
6 | // See : http :// www .x-io.co.uk/ node /8# open_source_ahrs_and_imu_algorithms
7 | //
8 | // Date | Author | Notes
9 | // 29/09/2011 | SOH Madgwick | Initial release
10 | // 02/10/2011 | SOH Madgwick | Optimised for reduced CPU load
11 | // 19/02/2012 | SOH Madgwick | Magnetometer measurement is normalised
12 | //
13 | //
=====================================================================================================

14

15 //

16 // Header files

17
18 | # include " AHRS / MadgwickAHRS .h"
19 | # include < math .h >

20

21 //

22 // Definitions

23
24 | # define sampleFreq | 512.0 f | // sample frequency in Hz
25 | # define betaDef | 0.1 f | // 2 * proportional gain

26

27 //

28 // Variable definitions

29
30 | volatile float beta = betaDef ; | // 2 *
proportional gain (Kp)
31 | volatile float q0 = 1.0 f , q1 = 0.0 f , q2 = 0.0 f , q3 = 0.0 f ; | // quaternion of
sensor frame relative to auxiliary frame

32

33 //

34 // Function declarations

35

Lab. Robótica y Mecatrónica | 19 | Reporte

36 float invSqrt ( float x ) ;

37

38 | //
| ====================================================================================================
39 | // Functions

40

41 | //
42 | // AHRS algorithm update

43
44 | void MadgwickAHRSupdate ( float gx , float gy , float gz , float ax , float ay ,
| float az , float mx , float my , float mz ) {
45 | float recipNorm ;
46 | float s0 , s1 , s2 , s3 ;
47 | float qDot1 , qDot2 , qDot3 , qDot4 ;
48 | float hx , hy ;
49 | float _2q0mx , _2q0my , _2q0mz , _2q1mx , _2bx , _2bz , _4bx , _4bz , _2q0 , _2q1
| , _2q2 , _2q3 , _2q0q2 , _2q2q3 , q0q0 , q0q1 , q0q2 , q0q3 , q1q1 , q1q2 ,
| q1q3 , q2q2 , q2q3 , q3q3 ;

50
51 | // Use IMU algorithm if magnetometer measurement invalid ( avoids NaN in
| magnetometer normalisation )
52 | if (( mx == 0.0 f ) && ( my == 0.0 f ) && ( mz == 0.0 f ) ) {
53 | MadgwickAHRSupdateIMU ( gx , gy , gz , ax , ay , az ) ;
54 | return ;
55 | }

56
57 | // Rate of change of quaternion from gyroscope
58 | qDot1 = 0.5 f * ( - q1 * gx - q2 * gy - q3 * gz ) ;
59 | qDot2 = 0.5 f * ( q0 * gx + q2 * gz - q3 * gy ) ;
60 | qDot3 = 0.5 f * ( q0 * gy - q1 * gz + q3 * gx ) ;
61 | qDot4 = 0.5 f * ( q0 * gz + q1 * gy - q2 * gx ) ;

62
63 | // Compute feedback only if accelerometer measurement valid ( avoids NaN
| in accelerometer normalisation )
64 | if (!(( ax == 0.0 f ) && ( ay == 0.0 f ) && ( az == 0.0 f ) ) ) {

65
66 | // Normalise accelerometer measurement
67 | recipNorm = invSqrt ( ax * ax + ay * ay + az * az ) ;
68 | ax *= recipNorm ;
69 | ay *= recipNorm ;
70 | az *= recipNorm ;

71
72 | // Normalise magnetometer measurement
73 | recipNorm = invSqrt ( mx * mx + my * my + mz * mz ) ;
74 | mx *= recipNorm ;
75 | my *= recipNorm ;
76 | mz *= recipNorm ;

77
78 | // Auxiliary variables to avoid repeated arithmetic
79 | _2q0mx = 2.0 f * q0 * mx ;
80 | _2q0my = 2.0 f * q0 * my ;
81 | _2q0mz = 2.0 f * q0 * mz ;
Lab. Robótica y Mecatrónica | 20 | Reporte

82 | _2q1mx = 2.0 f * q1 * mx ;
83 | _2q0 = 2.0 f * q0 ;
84 | _2q1 = 2.0 f * q1 ;
85 | _2q2 = 2.0 f * q2 ;
86 | _2q3 = 2.0 f * q3 ;
87 | _2q0q2 = 2.0 f * q0 * q2 ;
88 | _2q2q3 = 2.0 f * q2 * q3 ;
89 | q0q0 = q0 * q0 ;
90 | q0q1 = q0 * q1 ;
91 | q0q2 = q0 * q2 ;
92 | q0q3 = q0 * q3 ;
93 | q1q1 = q1 * q1 ;
94 | q1q2 = q1 * q2 ;
95 | q1q3 = q1 * q3 ;
96 | q2q2 = q2 * q2 ;
97 | q2q3 = q2 * q3 ;
98 | q3q3 = q3 * q3 ;

99
100 | // Reference direction of Earth ’s magnetic field
101 | hx = mx * q0q0 - _2q0my * q3 + _2q0mz * q2 + mx * q1q1 + _2q1 * my *
| q2 + _2q1 * mz * q3 - mx * q2q2 - mx * q3q3 ;
102 | hy = _2q0mx * q3 + my * q0q0 - _2q0mz * q1 + _2q1mx * q2 - my * q1q1
| + my * q2q2 + _2q2 * mz * q3 - my * q3q3 ;
103 | _2bx = sqrt ( hx * hx + hy * hy ) ;
104 | _2bz = - _2q0mx * q2 + _2q0my * q1 + mz * q0q0 + _2q1mx * q3 - mz *
| q1q1 + _2q2 * my * q3 - mz * q2q2 + mz * q3q3 ;
105 | _4bx = 2.0 f * _2bx ;
106 | _4bz = 2.0 f * _2bz ;

107
108 | // Gradient decent algorithm corrective step
109 | s0 = - _2q2 * (2.0 f * q1q3 - _2q0q2 - ax ) + _2q1 * (2.0 f * q0q1 +
| _2q2q3 - ay ) - _2bz * q2 * ( _2bx * (0.5 f - q2q2 - q3q3 ) + _2bz *
| ( q1q3 - q0q2 ) - mx ) + ( - _2bx * q3 + _2bz * q1 ) * ( _2bx * ( q1q2 -
| q0q3 ) + _2bz * ( q0q1 + q2q3 ) - my ) + _2bx * q2 * ( _2bx * ( q0q2 +
| q1q3 ) + _2bz * (0.5 f - q1q1 - q2q2 ) - mz ) ;
110 | s1 = _2q3 * (2.0 f * q1q3 - _2q0q2 - ax ) + _2q0 * (2.0 f * q0q1 +
| _2q2q3 - ay ) - 4.0 f * q1 * (1 - 2.0 f * q1q1 - 2.0 f * q2q2 - az ) +
| _2bz * q3 * ( _2bx * (0.5 f - q2q2 - q3q3 ) + _2bz * ( q1q3 - q0q2 )
- mx ) + ( _2bx * q2 + _2bz * q0 ) * ( _2bx * ( q1q2 - q0q3 ) + _2bz *
| ( q0q1 + q2q3 ) - my ) + ( _2bx * q3 - _4bz * q1 ) * ( _2bx * ( q0q2 +
| q1q3 ) + _2bz * (0.5 f - q1q1 - q2q2 ) - mz ) ;
111 | s2 = - _2q0 * (2.0 f * q1q3 - _2q0q2 - ax ) + _2q3 * (2.0 f * q0q1 +
| _2q2q3 - ay ) - 4.0 f * q2 * (1 - 2.0 f * q1q1 - 2.0 f * q2q2 - az ) +
| ( - _4bx * q2 - _2bz * q0 ) * ( _2bx * (0.5 f - q2q2 - q3q3 ) + _2bz *
| ( q1q3 - q0q2 ) - mx ) + ( _2bx * q1 + _2bz * q3 ) * ( _2bx * ( q1q2 -
| q0q3 ) + _2bz * ( q0q1 + q2q3 ) - my ) + ( _2bx * q0 - _4bz * q2 ) * (
| _2bx * ( q0q2 + q1q3 ) + _2bz * (0.5 f - q1q1 - q2q2 ) - mz ) ;
112 | s3 = _2q1 * (2.0 f * q1q3 - _2q0q2 - ax ) + _2q2 * (2.0 f * q0q1 +
| _2q2q3 - ay ) + ( - _4bx * q3 + _2bz * q1 ) * ( _2bx * (0.5 f - q2q2 -
| q3q3 ) + _2bz * ( q1q3 - q0q2 ) - mx ) + ( - _2bx * q0 + _2bz * q2 ) * (
| _2bx * ( q1q2 - q0q3 ) + _2bz * ( q0q1 + q2q3 ) - my ) + _2bx * q1 * (
| _2bx * ( q0q2 + q1q3 ) + _2bz * (0.5 f - q1q1 - q2q2 ) - mz ) ;
113 | recipNorm = invSqrt ( s0 * s0 + s1 * s1 + s2 * s2 + s3 * s3 ) ; //
| normalise step magnitude
114 | s0 *= recipNorm ;
Lab. Robótica y Mecatrónica | 21 | Reporte

115 | s1 *= recipNorm ;
116 | s2 *= recipNorm ;
117 | s3 *= recipNorm ;

118
119 | // Apply feedback step
120 | qDot1 -= beta * s0 ;
121 | qDot2 -= beta * s1 ;
122 | qDot3 -= beta * s2 ;
123 | qDot4 -= beta * s3 ;
124 | }

125
126 | // Integrate rate of change of quaternion to yield quaternion
127 | q0 += qDot1 * (1.0 f / sampleFreq ) ;
128 | q1 += qDot2 * (1.0 f / sampleFreq ) ;
129 | q2 += qDot3 * (1.0 f / sampleFreq ) ;
130 | q3 += qDot4 * (1.0 f / sampleFreq ) ;

131
132 | // Normalise quaternion
133 | recipNorm = invSqrt ( q0 * q0 + q1 * q1 + q2 * q2 + q3 * q3 ) ;
134 | q0 *= recipNorm ;
135 | q1 *= recipNorm ;
136 | q2 *= recipNorm ;
137 | q3 *= recipNorm ;
138 | }

139

140 | //
141 | // IMU algorithm update

142
143 | void MadgwickAHRSupdateIMU ( float gx , float gy , float gz , float ax , float ay ,
| float az ) {
144 | float recipNorm ;
145 | float s0 , s1 , s2 , s3 ;
146 | float qDot1 , qDot2 , qDot3 , qDot4 ;
147 | float _2q0 , _2q1 , _2q2 , _2q3 , _4q0 , _4q1 , _4q2 , _8q1 , _8q2 , q0q0 , q1q1 ,
| q2q2 , q3q3 ;

148
149 | // Rate of change of quaternion from gyroscope
150 | qDot1 = 0.5 f * ( - q1 * gx - q2 * gy - q3 * gz ) ;
151 | qDot2 = 0.5 f * ( q0 * gx + q2 * gz - q3 * gy ) ;
152 | qDot3 = 0.5 f * ( q0 * gy - q1 * gz + q3 * gx ) ;
153 | qDot4 = 0.5 f * ( q0 * gz + q1 * gy - q2 * gx ) ;

154
155 | // Compute feedback only if accelerometer measurement valid ( avoids NaN
| in accelerometer normalisation )
156 | if (!(( ax == 0.0 f ) && ( ay == 0.0 f ) && ( az == 0.0 f ) ) ) {

157
158 | // Normalise accelerometer measurement
159 | recipNorm = invSqrt ( ax * ax + ay * ay + az * az ) ;
160 | ax *= recipNorm ;
161 | ay *= recipNorm ;
162 | az *= recipNorm ;

163
164 | // Auxiliary variables to avoid repeated arithmetic
Lab. Robótica y Mecatrónica | 22 | Reporte

165 | _2q0 = 2.0 f * q0 ;
166 | _2q1 = 2.0 f * q1 ;
167 | _2q2 = 2.0 f * q2 ;
168 | _2q3 = 2.0 f * q3 ;
169 | _4q0 = 4.0 f * q0 ;
170 | _4q1 = 4.0 f * q1 ;
171 | _4q2 = 4.0 f * q2 ;
172 | _8q1 = 8.0 f * q1 ;
173 | _8q2 = 8.0 f * q2 ;
174 | q0q0 = q0 * q0 ;
175 | q1q1 = q1 * q1 ;
176 | q2q2 = q2 * q2 ;
177 | q3q3 = q3 * q3 ;

178
179 | // Gradient decent algorithm corrective step
180 | s0 = _4q0 * q2q2 + _2q2 * ax + _4q0 * q1q1 - _2q1 * ay ;
181 | s1 = _4q1 * q3q3 - _2q3 * ax + 4.0 f * q0q0 * q1 - _2q0 * ay - _4q1 +
| _8q1 * q1q1 + _8q1 * q2q2 + _4q1 * az ;
182 | s2 = 4.0 f * q0q0 * q2 + _2q0 * ax + _4q2 * q3q3 - _2q3 * ay - _4q2 +
| _8q2 * q1q1 + _8q2 * q2q2 + _4q2 * az ;
183 | s3 = 4.0 f * q1q1 * q3 - _2q1 * ax + 4.0 f * q2q2 * q3 - _2q2 * ay ;
184 | recipNorm = invSqrt ( s0 * s0 + s1 * s1 + s2 * s2 + s3 * s3 ) ; //
| normalise step magnitude
185 | s0 *= recipNorm ;
186 | s1 *= recipNorm ;
187 | s2 *= recipNorm ;
188 | s3 *= recipNorm ;

189
190 | // Apply feedback step
191 | qDot1 -= beta * s0 ;
192 | qDot2 -= beta * s1 ;
193 | qDot3 -= beta * s2 ;
194 | qDot4 -= beta * s3 ;
195 | }

196
197 | // Integrate rate of change of quaternion to yield quaternion
198 | q0 += qDot1 * (1.0 f / sampleFreq ) ;
199 | q1 += qDot2 * (1.0 f / sampleFreq ) ;
200 | q2 += qDot3 * (1.0 f / sampleFreq ) ;
201 | q3 += qDot4 * (1.0 f / sampleFreq ) ;

202
203 | // Normalise quaternion
204 | recipNorm = invSqrt ( q0 * q0 + q1 * q1 + q2 * q2 + q3 * q3 ) ;
205 | q0 *= recipNorm ;
206 | q1 *= recipNorm ;
207 | q2 *= recipNorm ;
208 | q3 *= recipNorm ;
209 | }

210

211 | //
212 | // Fast inverse square - root
213 | // See : http :// en. wikipedia .org / wiki / Fast_inverse_square_root

214

Lab. Robótica y Mecatrónica | 23 | Reporte

215 | float invSqrt ( float x ) {
216 | float halfx = 0.5 f * x ;
217 | float y = x ;
218 | long i = *( long *) & y ;
219 | i = 0 x5f3759df - (i > >1) ;
220 | y = *( float *) & i ;
221 | y = y * (1.5 f - ( halfx * y * y ) ) ;
222 | return y ;
223 | }

224

225 | //
| ====================================================================================================
226 | // END OF CODE
227 | //
| ====================================================================================================
Lab. Robótica y Mecatrónica | 24 | Reporte

## C. Planos

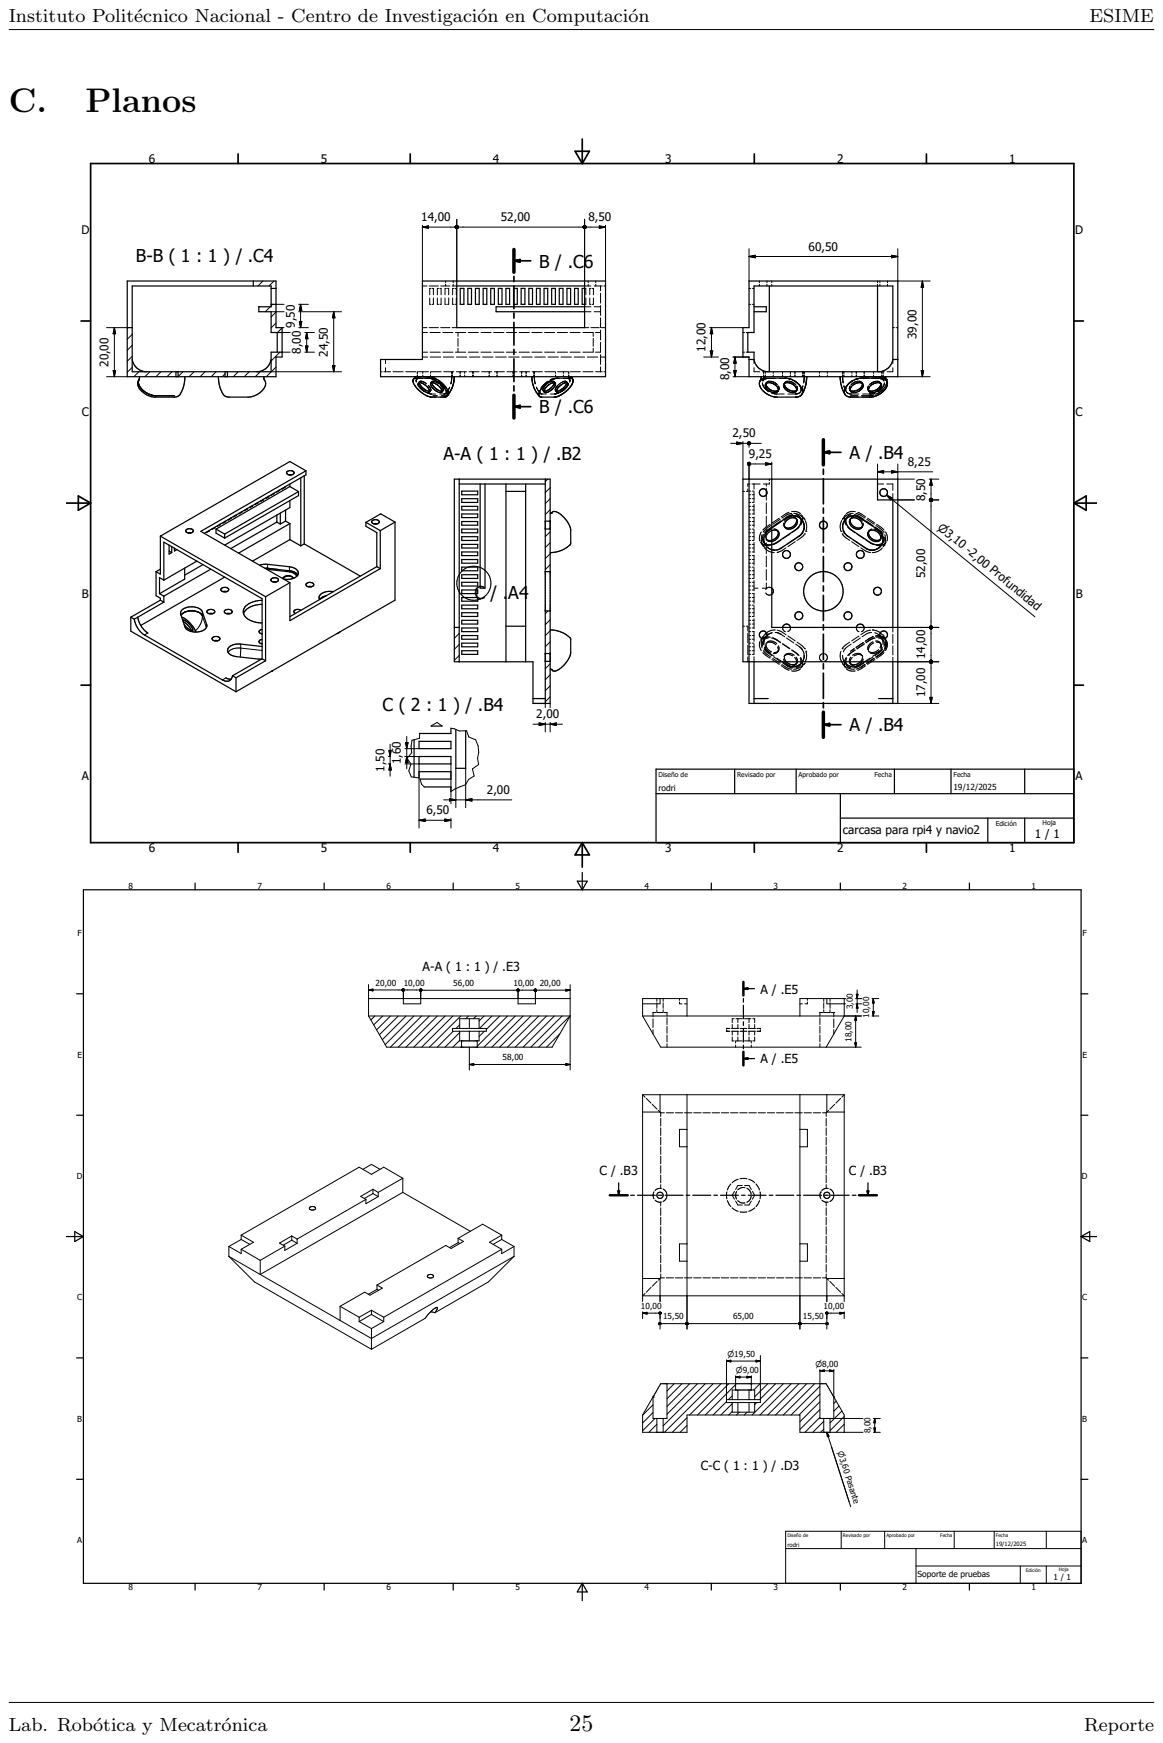
[picture p25: page 25]
carcasa para rpi4 y navio2; rodri; 19/12/2025 Diseño de; Revisado por; Aprobado por; Fecha; 1 / 1 Edición; Hoja; n3,10 -2,00 Profundidad 8,00 8,00 12,00 24,50; n3,60 Pasante n8,00 8,00; Lab. Robótica y Mecatrónica; Reporte

Soporte de pruebas
