0-0REL/Dron/Complementos/modelos/README.md

Modelos de caffe con el opencv

[deploy](/complementos/modelos/deploy.prototxt) es el prototxt
[res](/complementos/modelos/res10_300x300_ssd_iter_140000_fp16.caffemodel) es el caffemodel

Del mediapipe
[blaze face](/complementos/modelos/blaze_face_short_range.tflite) es del mediapipe
