0-0REL/Dron/ArduPilot/MP Python Scripts/README.md

# Scripts de con mission planer

Todo bien
