0-0REL/Dron/doc/metodologias.tex

\subsection{Medición de empuje}
Para estimar $K_F$ de \eqref{eq:kfomega} se mide el empuje generado cada 10\% de cambio en la velocidad del motor. Las siguientes medidas fueron realizadas
a 11.2 V, el motor y hélice tienen una masa de 120 g.
\begin{figure}[H]
	\centering
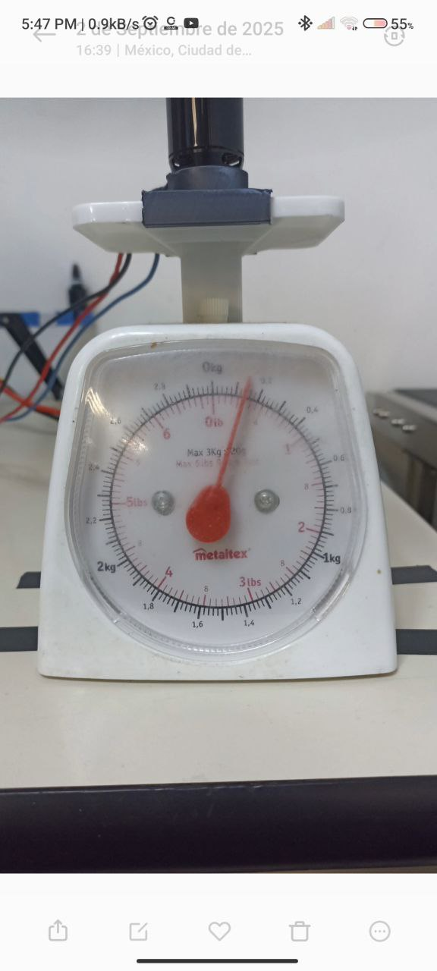
[picture p26: doc/Imagenes/photo_5057970710495562561_y.jpg]
	\subfigure[1100 ms $\rightarrow$ 140 g]{}
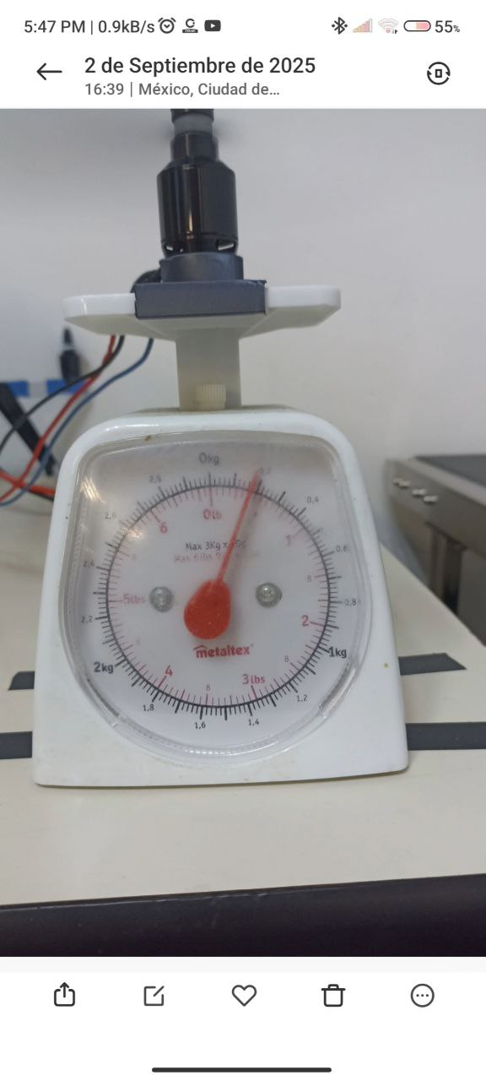
[picture p27: doc/Imagenes/photo_5057970710495562560_y.jpg]
	\subfigure[1200 ms $\rightarrow$ 170 g]{}
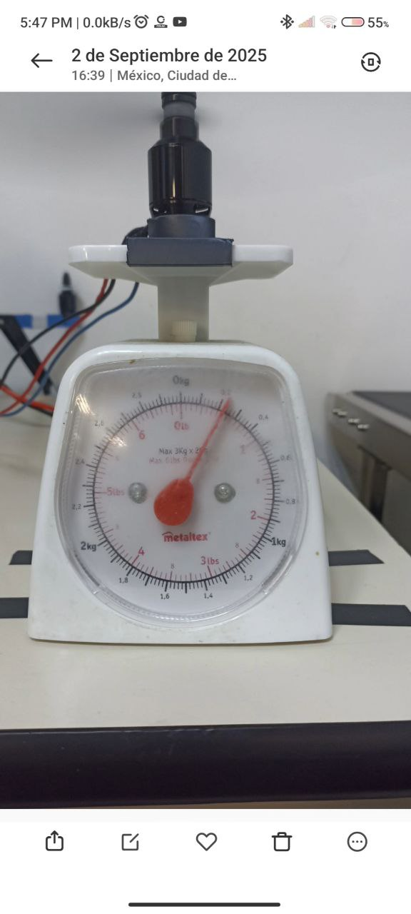
[picture p28: doc/Imagenes/photo_5057970710495562559_y.jpg]
	\subfigure[1300 ms $\rightarrow$ 220 g]{}
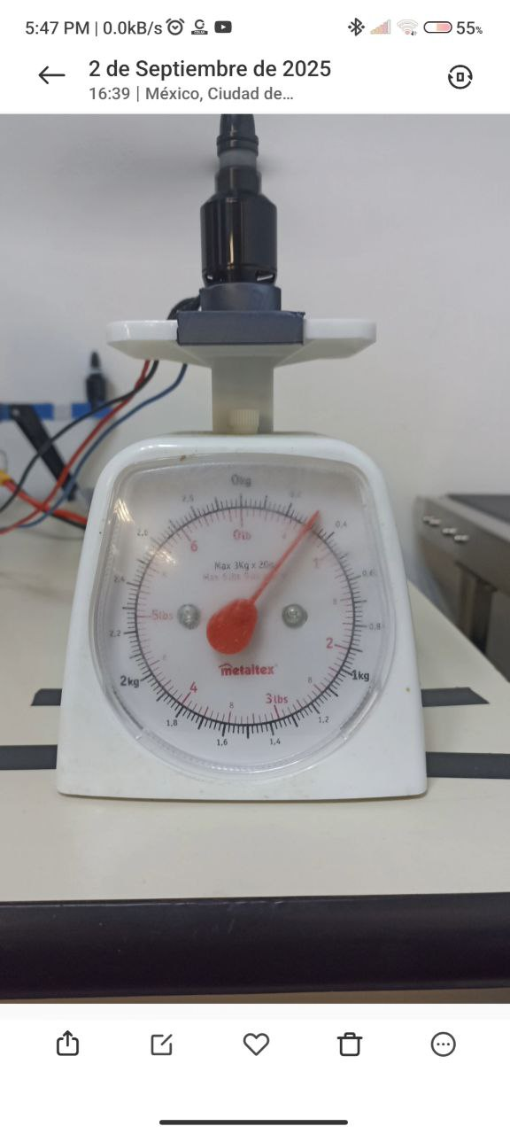
[picture p29: doc/Imagenes/photo_5057970710495562558_y.jpg]
	\subfigure[1400 ms $\rightarrow$ 300 g]{}
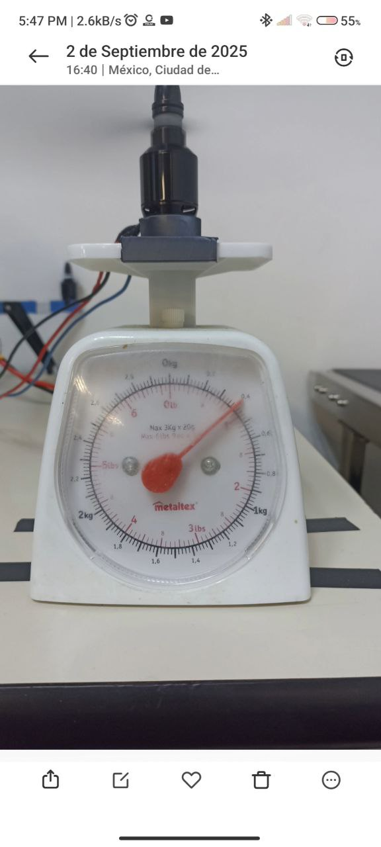
[picture p30: doc/Imagenes/photo_5057970710495562557_y.jpg]
	\subfigure[1500 ms $\rightarrow$ 400 g]{}
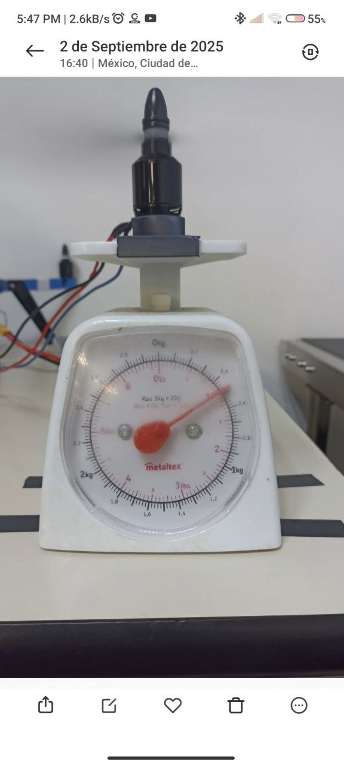
[picture p31: doc/Imagenes/photo_5057970710495562556_y.jpg]
	\subfigure[1600 ms $\rightarrow$ 490 g]{}
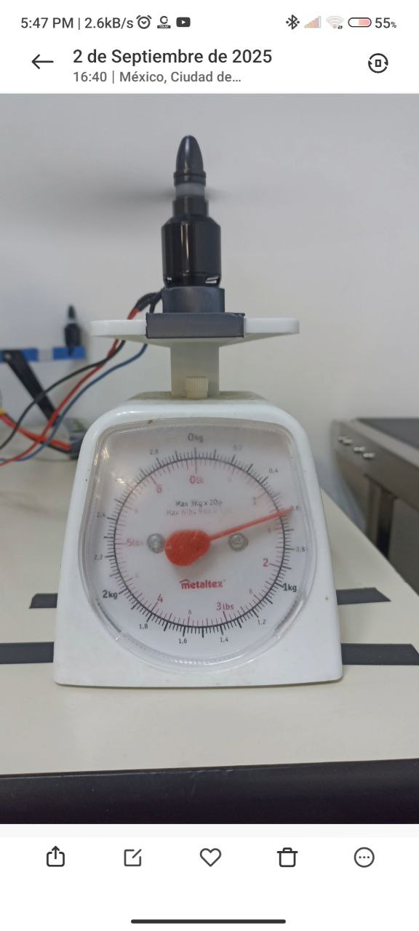
[picture p32: doc/Imagenes/photo_5057970710495562555_y.jpg]
	\subfigure[1700 ms $\rightarrow$ 600 g]{}
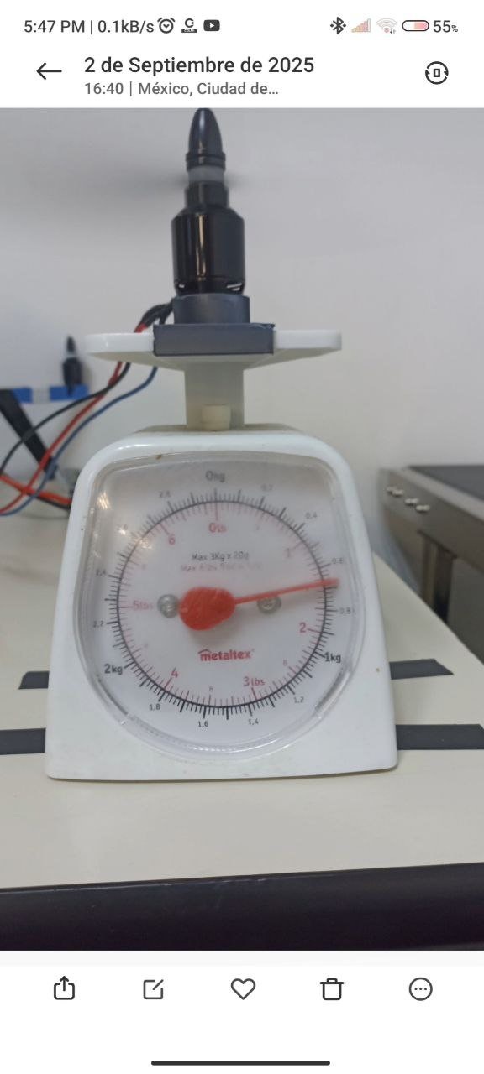
[picture p33: doc/Imagenes/photo_5057970710495562554_y.jpg]
	\subfigure[1800 ms $\rightarrow$ 670 g]{}
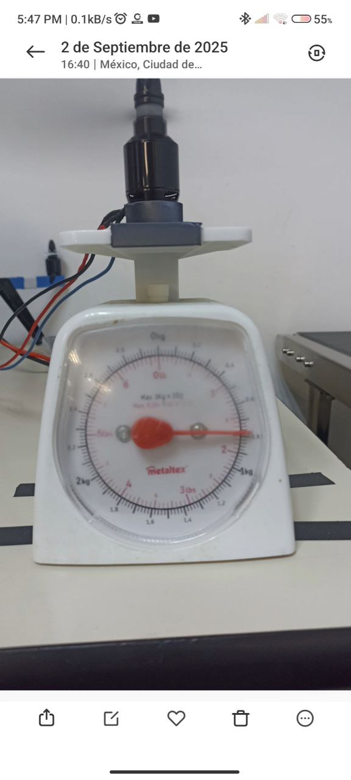
[picture p34: doc/Imagenes/photo_5057970710495562553_y.jpg]
	\subfigure[1900 ms $\rightarrow$ 770 g]{}
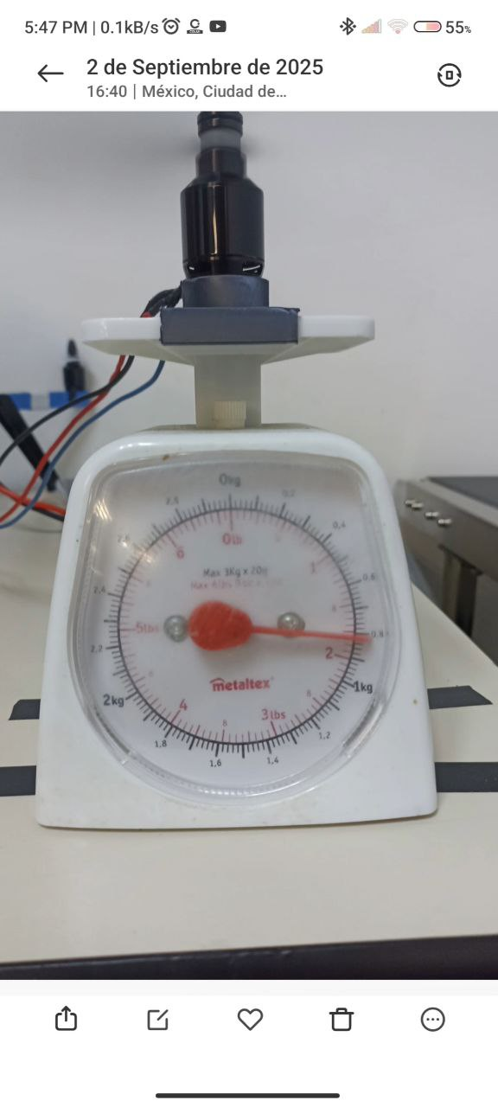
[picture p35: doc/Imagenes/photo_5057970710495562552_y.jpg]
	\subfigure[2000 ms $\rightarrow$ 820 g]{}
	\caption{Medición de empuje}
\end{figure}
\begin{table}[H]
	\centering
	\caption{Medición prueba de empuje}
	\begin{tabular}{l l l}
		\textbf{Señal (\%)}&\textbf{Medido (g)}&\textbf{Empuje (g)}\\
		\hline
		0&120&0\\
		10&140&20\\
		20&170&50\\
		30&220&100\\
		40&300&180\\
		50&400&280\\
		60&490&370\\
		70&600&480\\
		80&670&550\\
		90&770&650\\
		100&820&700
	\end{tabular}
\end{table}

Con estos datos se puede ajustar la curva para obtener $K_F=7.965$ N/\%²
\begin{figure}[H]
	\centering
	
	\caption{Ajuste de curva}
\end{figure}
\subsection{Detección y seguimiento}
\begin{figure}[H]
	\centering
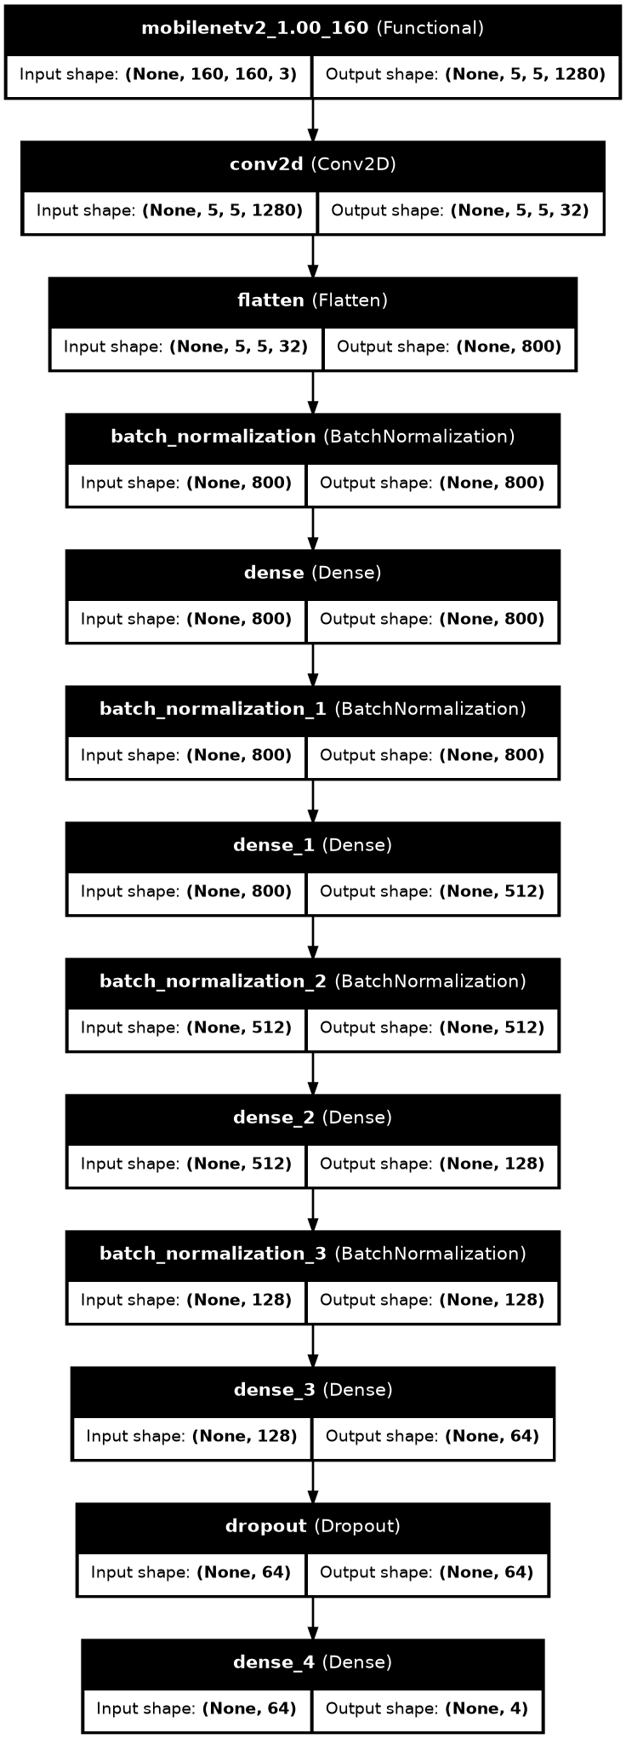
[picture p36: TensorFlow/model_architecture.png]
	\subfigure[Arquitectura]{}
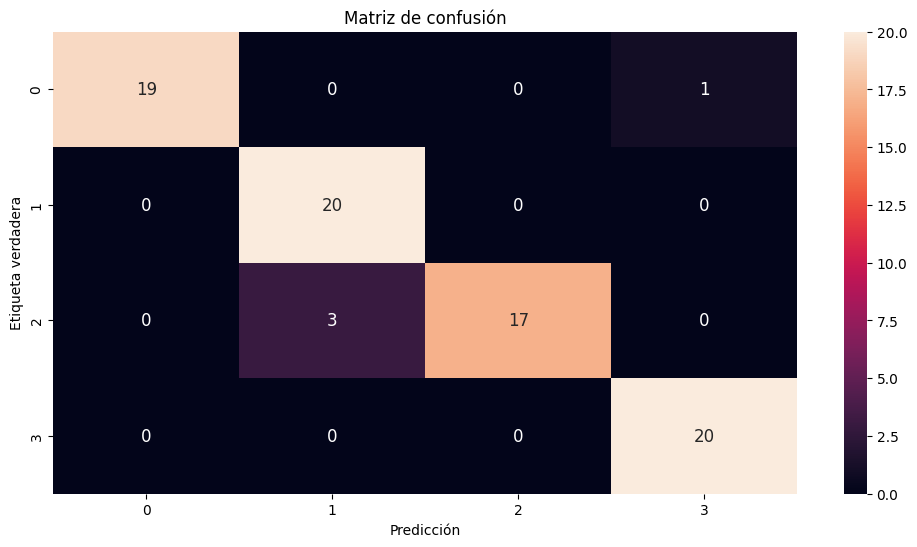
[picture p37: doc/Imagenes/matriz_de_confusion.png]
	\subfigure[Matriz de confusión]{}
	\caption{Red entrenada v2.0}
\end{figure}
\begin{figure}[H]
	\centering
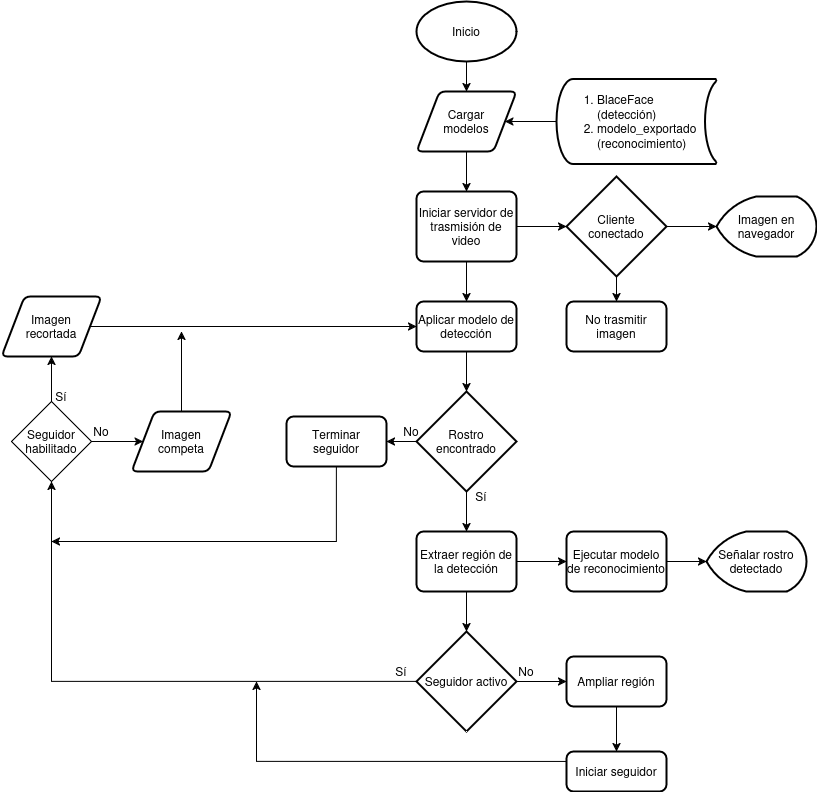
[picture p38: doc/Imagenes/Diagramas-Página-7.drawio.png]
	
	\caption{aBlaze.py}
\end{figure}
\subsection{Dinámica}
El modelo dinámico del cuadricóptero es
\begin{gather}
	m\ddot{\mathbf{r}} = \mathbf{R}_{\phi,\theta,\psi}\begin{bmatrix}
	0\\0\\F\end{bmatrix} - \begin{bmatrix}0\\0\\mg\end{bmatrix} - \mathbf{F}_f\\
	M(\boldsymbol{\eta})\ddot{\boldsymbol{\eta}} = \boldsymbol{\tau} - C(\boldsymbol{\eta},\dot{\boldsymbol{\eta}})\dot{\boldsymbol{\eta}} - \boldsymbol{\tau}_f
\end{gather}
\begin{table}
	\centering
	\caption{Parámetros del dron}
	\label{tab:param_dron}
	\begin{tabular}{l l l}
		$m$ & 1.6 & kg \\
		$I_{xx}$ & 0.021915027 & kgm$^2$ \\
		$I_{yy} $ & 0.022124548 & kgm$^2$ \\
		$I_{zz}$ & 0.042349865 & kgm$^2$ \\
		$L$ & 0.23 & m \\
		$K_F$ & 7.965 & N/\%²\\
		$K_M$ & 0.5 & Nm/\%²\\
		$K_m$ & 50.0565 & s$^{-1}$
	\end{tabular}
\end{table}
De \eqref{eq:mot2u} se obtiene la relación entre entradas de control y actuadores
\begin{equation}
	\label{eq:u2mot}
	\begin{bmatrix}
		\omega_1^2\\
		\omega_2^2\\
		\omega_3^3\\
		\omega_4^2
	\end{bmatrix}
	=
	\left[\begin{array}{cccc}
		\frac{1}{4\,K_F } & -\frac{1}{4\,K_F \,L}  & -\frac{1}{4\,K_F \,L}  & -\frac{1}{4\,K_M }\\
		\frac{1}{4\,K_F } & -\frac{1}{4\,K_F \,L}  & \frac{1}{4\,K_F \,L}  & \frac{1}{4\,K_M }\\
		\frac{1}{4\,K_F } & \frac{1}{4\,K_F \,L}  & \frac{1}{4\,K_F \,L}  & -\frac{1}{4\,K_M }\\
		\frac{1}{4\,K_F } & \frac{1}{4\,K_F \,L}  & -\frac{1}{4\,K_F \,L} & \frac{1}{4\,K_M }
	\end{array}\right]
	\begin{bmatrix}
		F\\
		\tau_x\\
		\tau_y\\
		\tau_z
	\end{bmatrix}
\end{equation}

\subsubsection{Linealización}
Mediante la serie de Taylor \eqref{eq:taylor} el modelo del cuadricóptero se puede expresar de forma lineal de la siguiente forma
\begin{equation}
	\label{eq:modelo_lineal}
\begin{bmatrix}
\dot{\mathbf{r}} \\ \ddot{\mathbf{r}} \\ \dot{\boldsymbol{\eta}} \\ \ddot{\boldsymbol{\eta}}
\end{bmatrix}
=
\begin{bmatrix}
\mathit{0}_{3\times3} & I_{3\times3} & \mathit{0}_{3\times3} & \mathit{0}_{3\times3} \\
\mathit{0}_{3\times3} & \mathit{0}_{3\times3} & G(\psi_d) & \mathit{0}_{3\times3} \\
\mathit{0}_{3\times3} & \mathit{0}_{3\times3} & \mathit{0}_{3\times3} & I_{3\times3} \\
\mathit{0}_{3\times3} & \mathit{0}_{3\times3} & \mathit{0}_{3\times3} & \mathit{0}_{3\times3}
\end{bmatrix}
\begin{bmatrix}
\mathbf{r} \\ \dot{\mathbf{r}} \\ \boldsymbol{\eta} \\ \dot{\boldsymbol{\eta}}
\end{bmatrix}
+
\begin{bmatrix}
\mathit{0}_{5\times1} & \mathit{0}_{5\times3} \\
m^{-1} & \mathit{0}_{1\times3}\\
\mathit{0}_{3\times1} & \mathit{0}_{3\times3} \\
\mathit{0}_{3\times1} & I_d
\end{bmatrix}
\begin{bmatrix}
F \\ \boldsymbol{\tau}
\end{bmatrix}
\end{equation}

donde:
\[
\mathbf{r} = \begin{bmatrix}x \\ y \\ z\end{bmatrix}, \quad
\boldsymbol{\eta } = \begin{bmatrix}\phi \\ \theta \\ \psi\end{bmatrix}, \quad
\boldsymbol{\tau} = \begin{bmatrix}\tau_x \\ \tau_y \\ \tau_z\end{bmatrix}
\]
\[
\mathit{G}(\psi_d) = \begin{bmatrix}
0 & g & 0\\
-g & 0 & 0\\
0 & 0 & 0
\end{bmatrix}, \quad
I_d = \operatorname{diag}\left(I_{xx}^{-1}, I_{yy}^{-1}, I_{zz}^{-1}\right)
\]
\subsection{Algoritmos de control}
\subsubsection{PD}
El controlador se ajusta usando funciones de trasferencia, que se obtienen mediante \eqref{eq:ss2tf}, con
\[
\mathbf{C} = \begin{bmatrix}
	I_{3\times3} & \mathit{0}_{3\times3} & \mathit{0}_{3\times3} & \mathit{0}_{3\times3} \\
    \mathit{0}_{3\times3} & \mathit{0}_{3\times3} & I_{3\times3} & \mathit{0}_{3\times3}
\end{bmatrix}
\]
\[
\mathbf{D} = \mathit{0}_{6\times4}
\]
\begin{gather}
	G_x(s) = \frac{g}{I_{yy} s^4} \\
    G_y(s) = -\frac{g}{I_{xx} s^4} \\
    G_z(s) = \frac{1}{m s^2} \label{eq:tf_crtb_i} \\
    G_{\phi}(s) = \frac{1}{I_{xx} s^2} \\
    G_{\theta}(s) = \frac{1}{I_{yy} s^2} \\
    G_{\psi}(s) = \frac{1}{I_{zz} s^2} \label{eq:tf_crtb_f}
\end{gather}

Dado que no se puede medir los desplazamientos en $x$ y $y$, solo se realizan 4 de los 6 controladores (control de orientación y altura).
El cambio de velocidad en los motores no es instantáneo, por lo que las ecuaciones \eqref{eq:tf_crtb_i}-\eqref{eq:tf_crtb_f} se multiplican por \eqref{eq:tf_mot}, que es la
función de trasferencia de los motores, para incluir el retraso.
\begin{eqnarray}
	\label{eq:tf_mot}
	\dot{\omega}(t)=K_m(\omega_d(t)-\omega(t))\rightarrow \frac{\omega(s)}{\omega_d(s)} = \frac{K_m}{s+K_m}
\end{eqnarray}

Para ajustar los controladores se utiliza el método de colocación de las raíces, de modo que \eqref{eq:tf_crtb_i} a \eqref{eq:tf_crtb_f} se convierten en
\begin{gather}
	K_{Dz}\frac{(s+a_z)\frac{K_m}{m}}{s^2 (s+K_m)}\\
	K_{D\phi}\frac{(s+a_\phi)\frac{K_m}{I_{xx}}}{s^2 (s+K_m)}\\
	K_{D\theta}\frac{(s+a_\theta)\frac{K_m}{I_{yy}}}{s^2 (s+K_m)}\\
	K_{D\psi}\frac{(s+a_\psi)\frac{K_m}{I_{zz}}}{s^2 (s+K_m)}
\end{gather}
Con la ayuda MATLAB se ajustan los ceros y ganancias hasta obtener los siguiente resultados.
\begin{table}[H]
	\centering
	\caption{Ganancias PD}
	\begin{tabular}{r l l}
		& $K_P$ & $K_D$ \\
		Altura & 32.9186 & 20.994 \\
		Roll & 1.498320 & 0.352480 \\
		Pitch & 1.512645 & 0.355850 \\
		Yaw & 2.895440 & 0.681153
	\end{tabular}
\end{table}
\begin{figure}[H]
	\centering
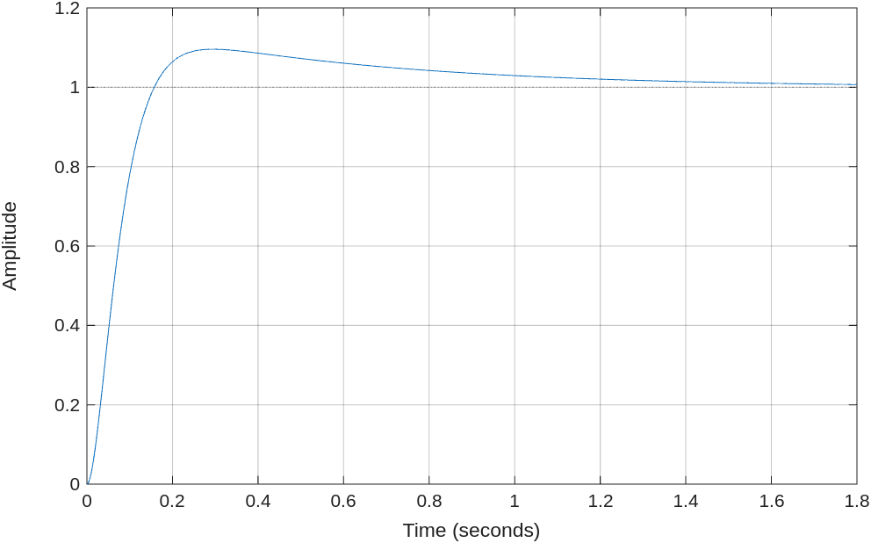
[picture p39: doc/Imagenes/step_pd_alt.png]
	\subfigure[Altura]{}
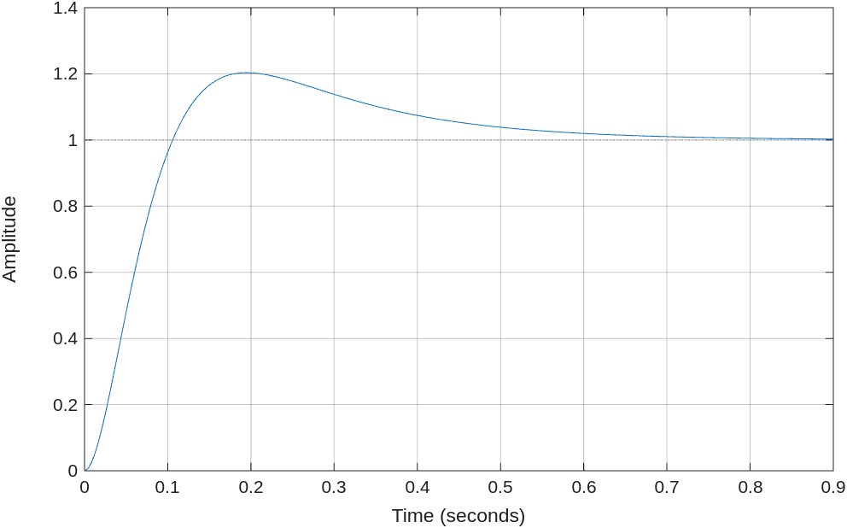
[picture p40: doc/Imagenes/step_pd_roll.png]
	\subfigure[Roll]{}
	\subfigure[Pitch]{}
	\subfigure[yaw]{}
	\caption{Respuesta escalón PD}
	\label{fig:step_pd}
\end{figure}
\subsubsection{PID}
De forma similar se ajustan las ganancias del controlador, para este caso se usan
\begin{gather}
	K_{Dz}\frac{(s+a_z)(s+b_z)\frac{K_m}{m}}{s^2 (s+K_m)}\\
	K_{D\phi}\frac{(s+a_\phi)(s+b_\phi)\frac{K_m}{I_{xx}}}{s^2 (s+K_m)}\\
	K_{D\theta}\frac{(s+a_\theta)(s+b_\theta)\frac{K_m}{I_{yy}}}{s^2 (s+K_m)}\\
	K_{D\psi}\frac{(s+a_\psi)(s+b_\psi)\frac{K_m}{I_{zz}}}{s^2 (s+K_m)}
\end{gather}
\begin{table}[H]
	\centering
	\caption{Ganancias PID}
	\begin{tabular}{r l l l}
		& $K_P$ & $K_I$ & $K_D$ \\
		Altura & 29.28 & 0.8 & 38.21 \\
		Roll & 1.016 & 0.08 & 0.2 \\
		Pitch & 2.873 & 1.173 & 0.6391 \\
		Yaw & 3.329 & 1.211 & 2.288
	\end{tabular}
\end{table}
\begin{figure}[H]
	\centering
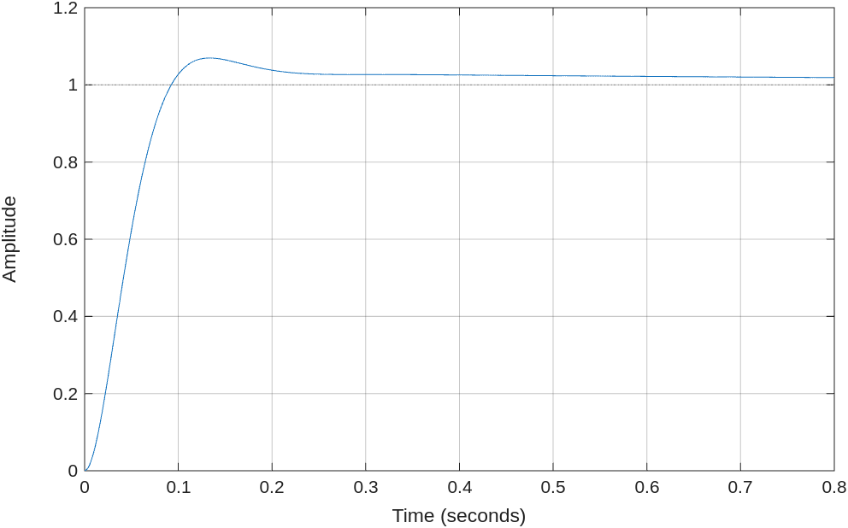
[picture p41: doc/Imagenes/step_pid_alt.png]
	\subfigure[Altura]{}
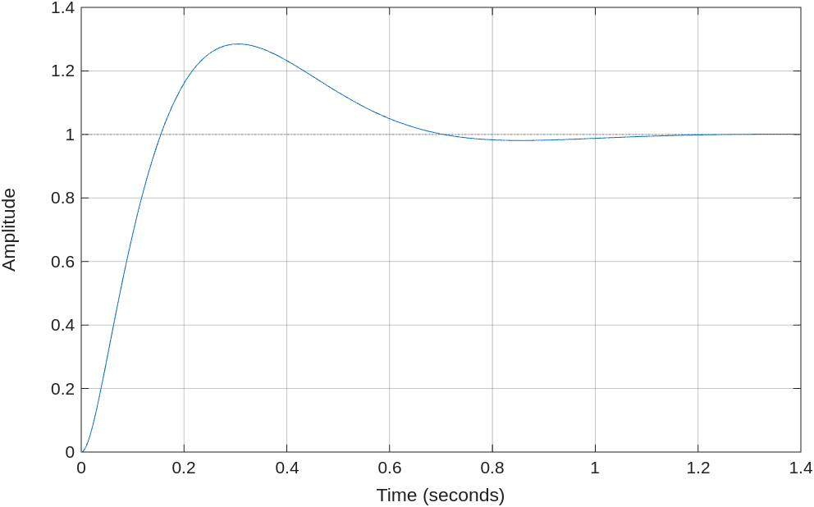
[picture p42: doc/Imagenes/step_pid_roll.png]
	\subfigure[Roll]{}
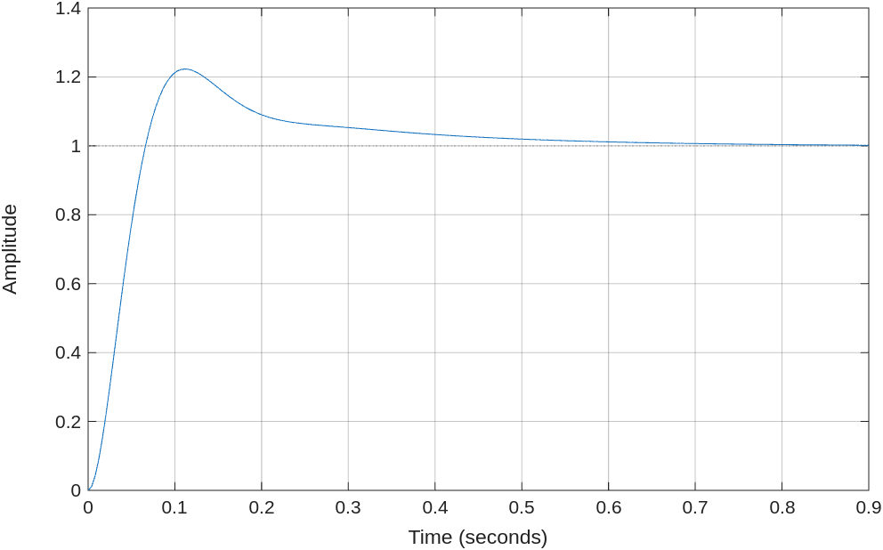
[picture p43: doc/Imagenes/step_pid_pitch.png]
	\subfigure[Pitch]{}
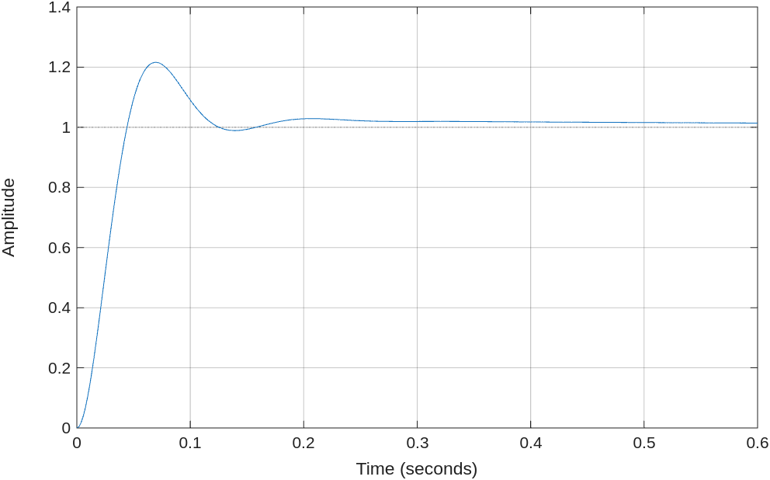
[picture p44: doc/Imagenes/step_pid_yaw.png]
	\subfigure[Yaw]{}
	\caption{Respuesta escalón PID}
\end{figure}
\subsubsection{LQI}
El modelo en espacio de estados se discretiza a una frecuencia de muestreo de 510 Hz, se aumenta el modelo de forma como en \eqref{eq:c_mi}, las
ganancias se obtienen como LQR con
\[\mathbf{R}=\operatorname{diag}(\begin{bmatrix}\mathbf{R} & \mathbf{R_e}\end{bmatrix})\]
\[\mathbf{R}=\begin{bmatrix}
	10^{-2} & 0.1^{-2} & 0.4363^{-2} & 0.4363^{-2} & 0.4363^{-2} & 0.0017^{-2} & 0.0017^{-2} & 0.0017^{-2}
\end{bmatrix}\]
\[\mathbf{R_e}=\begin{bmatrix}
	10^{-2} & 0.2618^{-2} & 0.2618^{-2} & 0.2618^{-2}
\end{bmatrix}\]
\[\mathbf{Q}=\operatorname{diag}(\begin{bmatrix}
	1 & 0.0625 & 0.0625 & 0.0625
\end{bmatrix})\]
Las ganancias del controlador son:
\[\mathbf{K}=\begin{bmatrix}
	38.8651 & 14.9073 & 0 & 0 & 0 & 0 & 0 & 0 \\
    0 & 0 & 29.1816 & 0 & 0 & 11.2049 & 0 & 0 \\
    0 & 0 & 0 & 29.4606 & 0 & 0 & 11.3121 & 0 \\
    0 & 0 & 0 & 0 & 56.3886 & 0 & 0 & 21.6517
\end{bmatrix}\]
\[\mathbf{K_e}=\begin{bmatrix}
	-0.0991 & 0 & 0 & 0 \\
	0 & -0.0743 & 0 & 0 \\
	0 & 0 & -0.0750 & 0 \\
	0 & 0 & 0 & -0.1436
\end{bmatrix}\]

\begin{figure}[H]
	\centering
	
	\caption{Respuesta escalón LQI}
\end{figure}
\subsection{Resultados.}
\textbf{Controlador PD}:
\begin{gather}
	u_z(k) = K_{Pz} e(k) + K_{Dz} \frac{e(k)-e(k-1)}{T} + mg \\
	u_\eta(k) = K_{P\eta} e(k) + K_{D\eta} \frac{e(k)-e(k-1)}{T}
\end{gather}
\begin{figure}[H]
	\centering
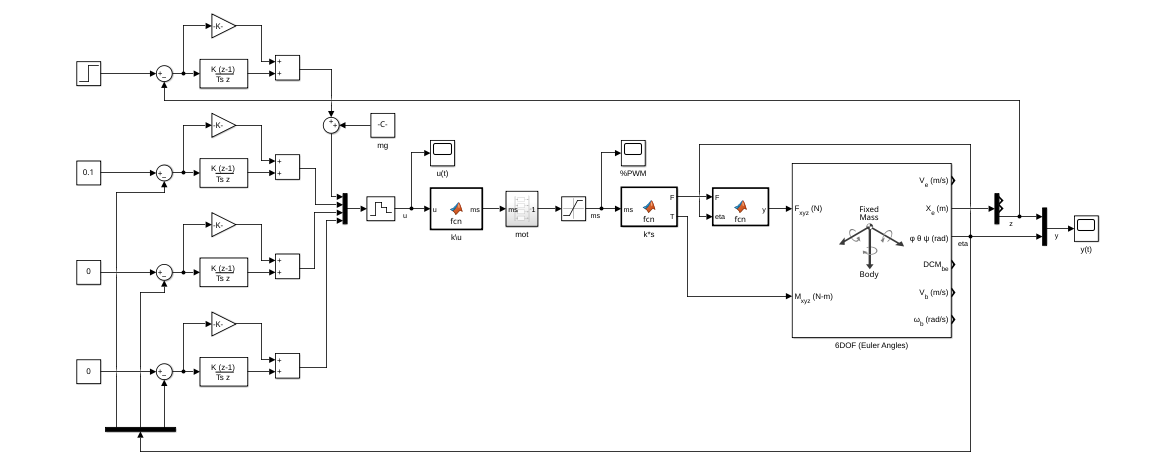
[picture p45: doc/Imagenes/pd_simulink.png]
	
	\caption{PD en Simulink. Referencias $z=1$ m, $\eta=\begin{bmatrix}0.1&0&0\end{bmatrix}^T$ rad}
\end{figure}
\begin{figure}[H]
	\centering
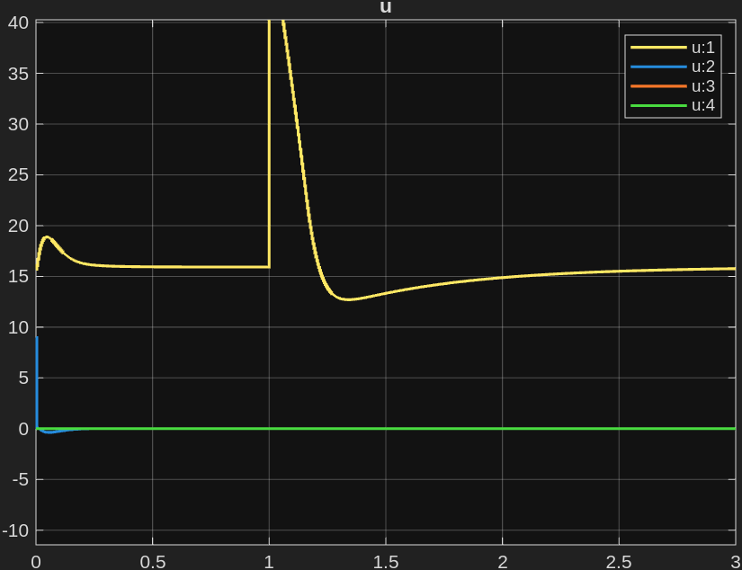
[picture p46: doc/Imagenes/simu_u_pd.png]
	\subfigure[Entrada]{}
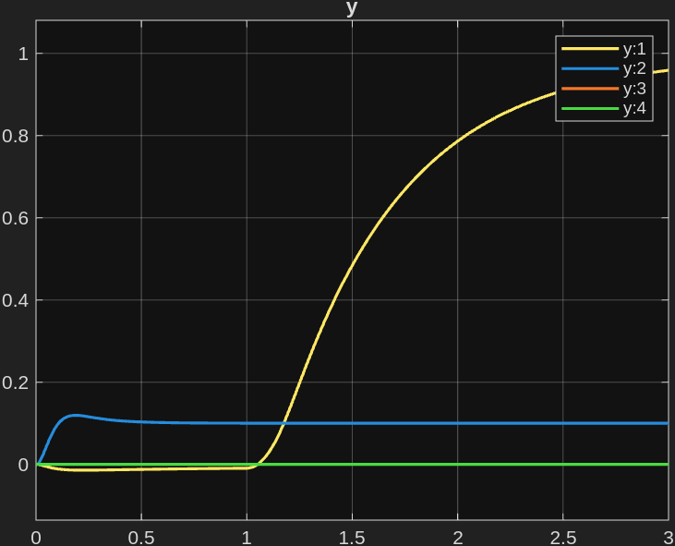
[picture p47: doc/Imagenes/simu_y_pd.png]
	\subfigure[Salida]{}
	\caption{Simulación PD, controlador a 510 Hz}
\end{figure}

\textbf{Controlador PID}:
\begin{gather}
	u_z(k) = K_{Pz} e_z(k) + K_{Iz}[e_z(k-1) + Te_z(k)] + K_{Dz} \frac{e_z(k)-e_z(k-1)}{T} + mg \\
	u_\eta(k) = K_{P\eta}e_\eta(k) + K_{I\eta}[e_\eta(k-1)+Te_\eta(k)] + K_{D\eta} \frac{e_\eta(k)-e_\eta(k-1)}{T}
\end{gather}
\begin{figure}[H]
	\centering
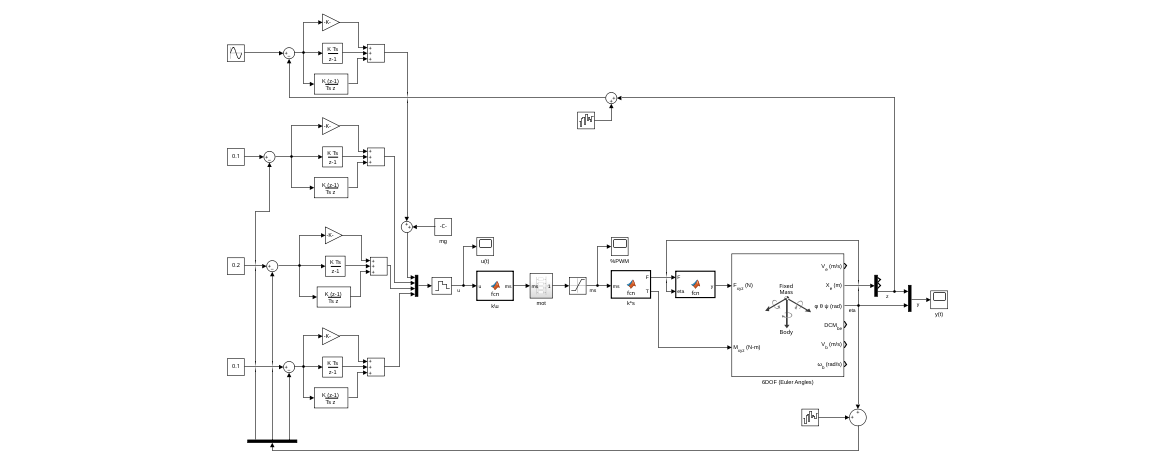
[picture p48: doc/Imagenes/simu_pid.png]
	
	\caption{PID en Simulink (la información de los sensores tiene ruido). Referencias $z=1+0.5\sin(2t)$ m, $\eta=\begin{bmatrix}0.1&0.2&0.1\end{bmatrix}$}
\end{figure}
\begin{figure}[H]
	\centering
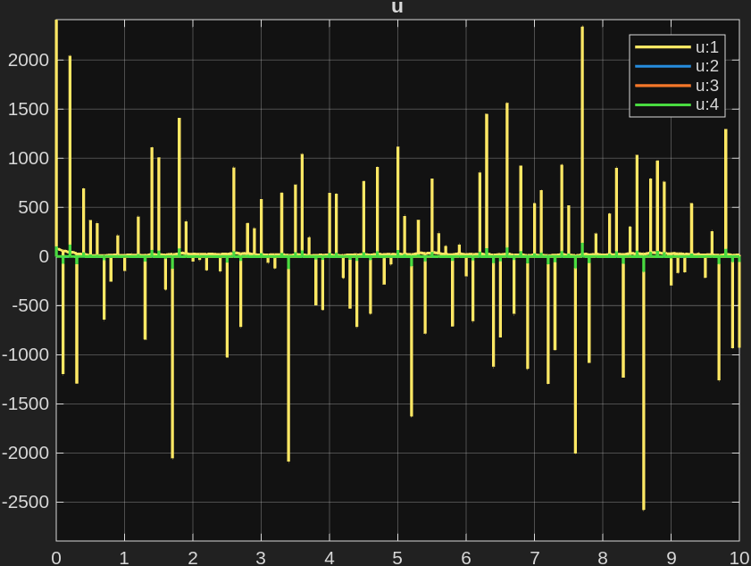
[picture p49: doc/Imagenes/simu_u_pid.png]
	\subfigure[Entrada]{}
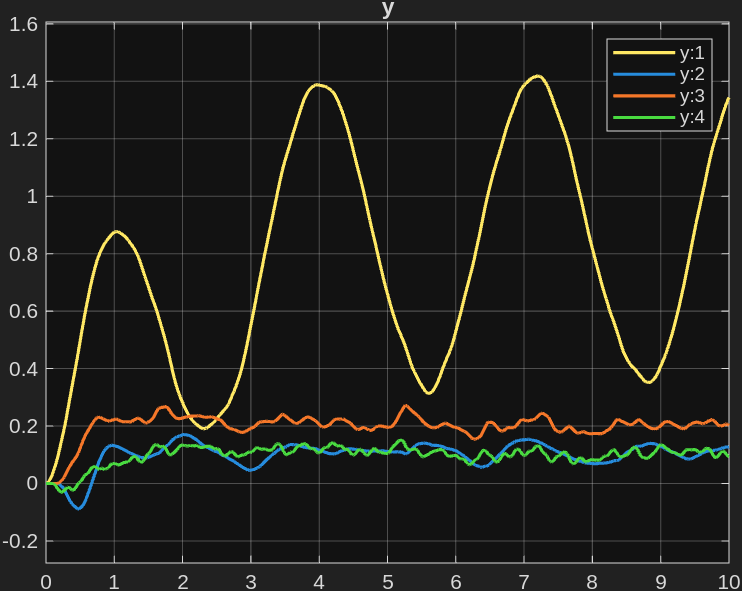
[picture p50: doc/Imagenes/simu_y_pid.png]
	\subfigure[Salida]{}
	\caption{Simulación PID, controlador a 510 Hz}
\end{figure}

\textbf{Controlador LQI}
\begin{equation}
	\mathbf{u}(k) = -\mathbf{Kx}(k)-\mathbf{K_ee}(k)
\end{equation}
\begin{figure}[H]
	\centering
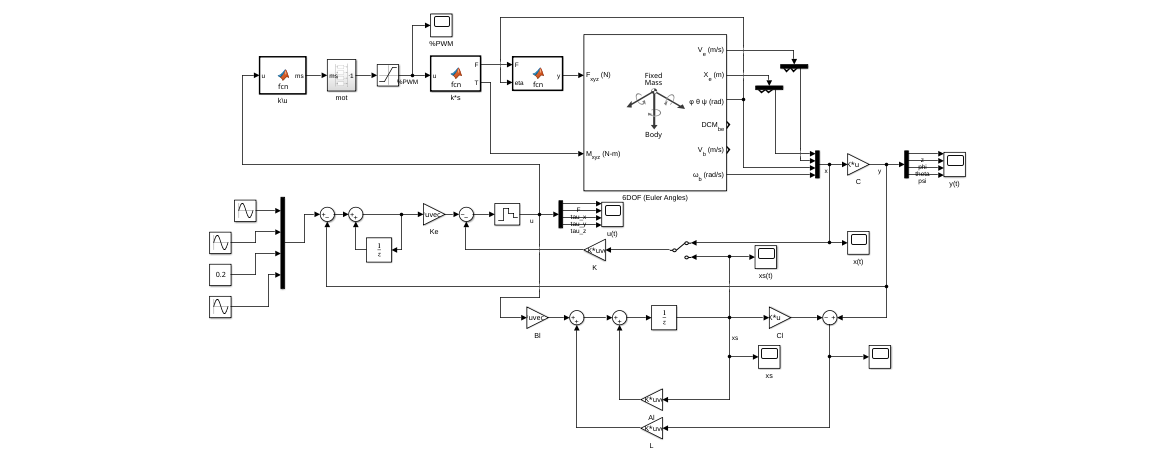
[picture p51: doc/Imagenes/lqi8_simulink.png]
	
	\label{fig:lqi8}
	\caption{LQI en Simulink. Referencias $z=1+\sin(2t)$ m, $\eta=\begin{bmatrix}0.3\sin(0.3t)&0.2&\sin(t)\end{bmatrix}^T$ rad}
\end{figure}
\begin{figure}[H]
	\centering
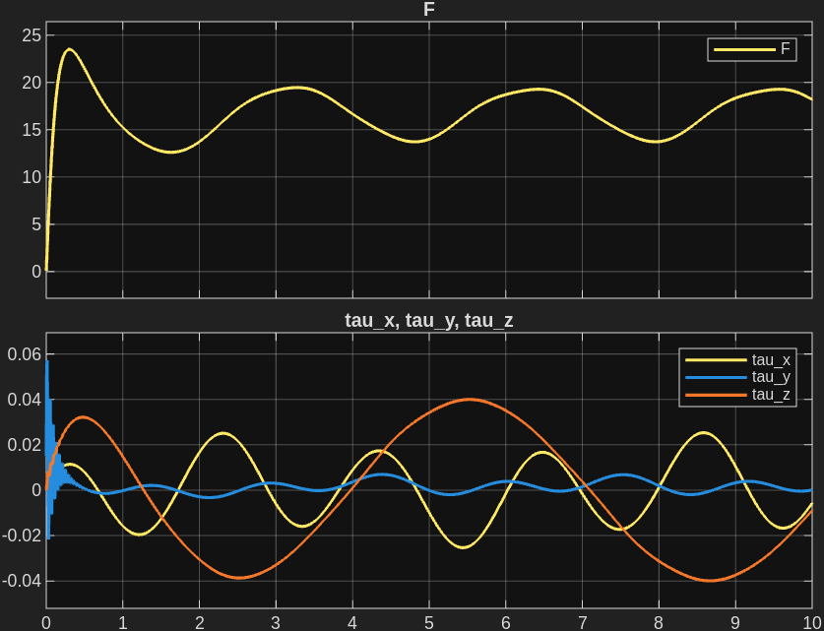
[picture p52: doc/Imagenes/simu_u_lqi8.png]
	\subfigure[Entrada]{}
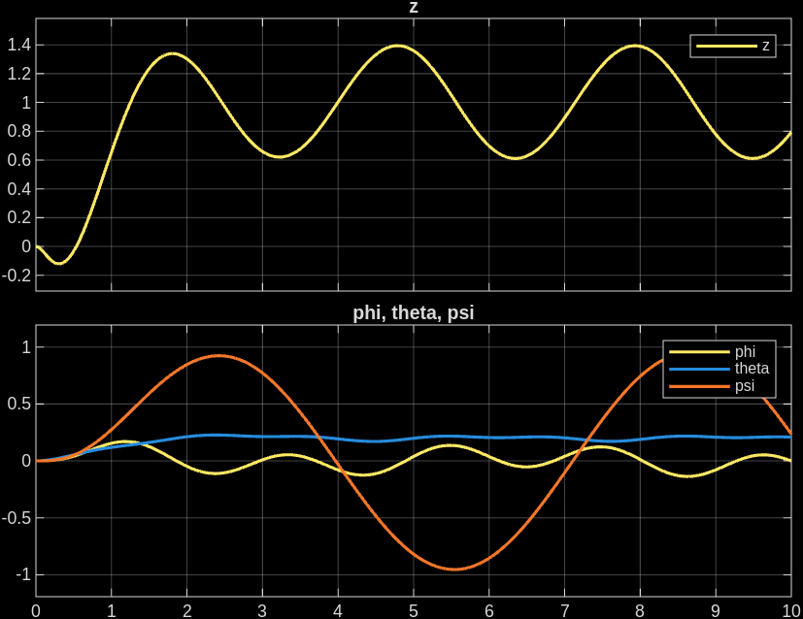
[picture p53: doc/Imagenes/simu_y_lqi8.png]
	\subfigure[Salida]{}
	\caption{Simulación LQI, controlador a 510 Hz}
\end{figure}
