0-0REL/Dron/Complementos/CAD/dron.png

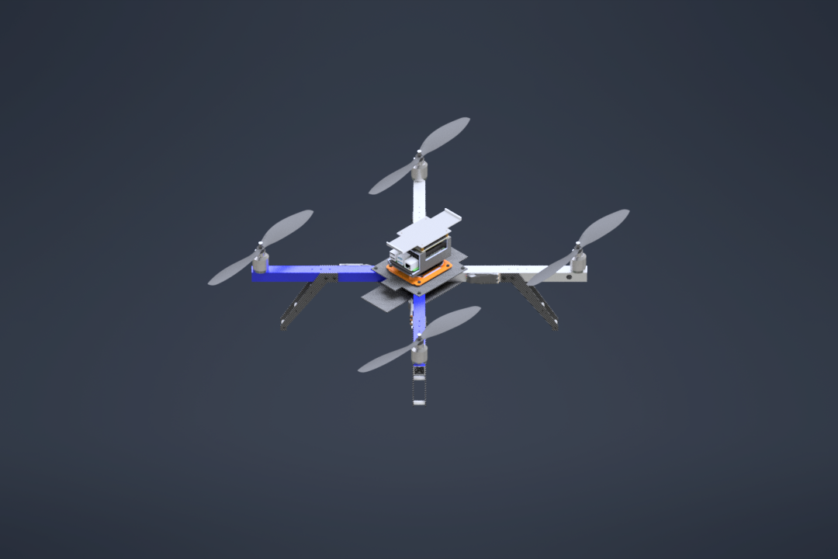
Complementos/CAD/dron.png
