0-0REL/Dron/doc/Imagenes/rym1.bmp

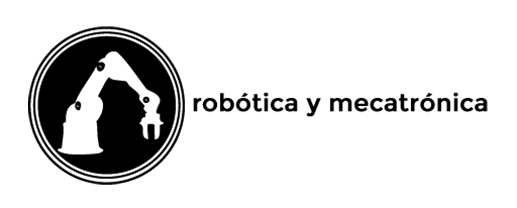
doc/Imagenes/rym1.bmp
