0-0REL/Dron/MATLAB/Drone/Model.png

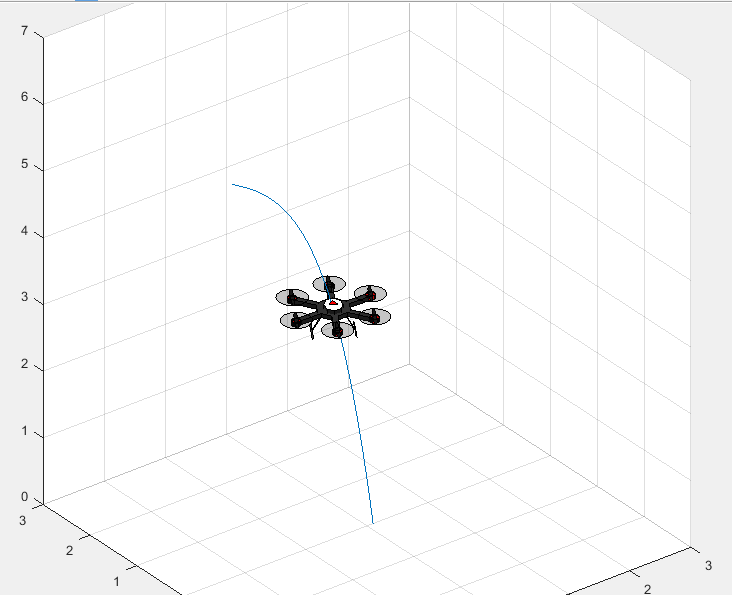
MATLAB/Drone/Model.png
