0-0REL/Dron/MATLAB/Drone/Trayectoria1.png

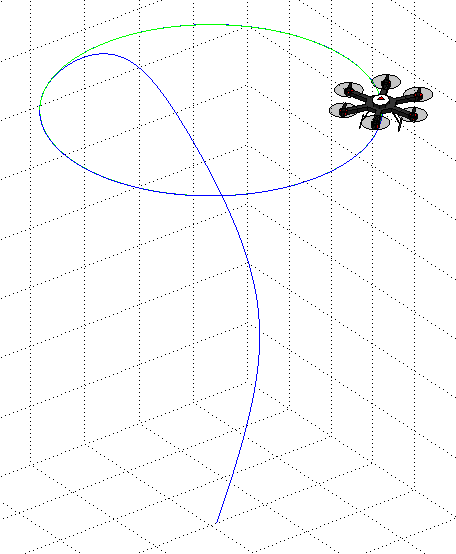
MATLAB/Drone/Trayectoria1.png
