0-0REL/Dron/MATLAB/Drone/Trayectoria2.png

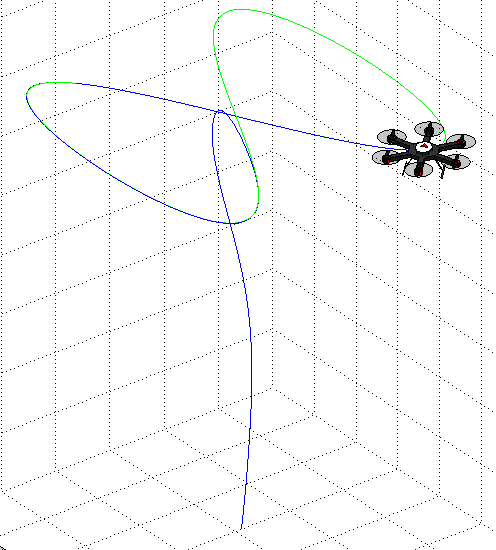
MATLAB/Drone/Trayectoria2.png
