0-0REL/Dron/MATLAB/Drone/Trayectoria3.png

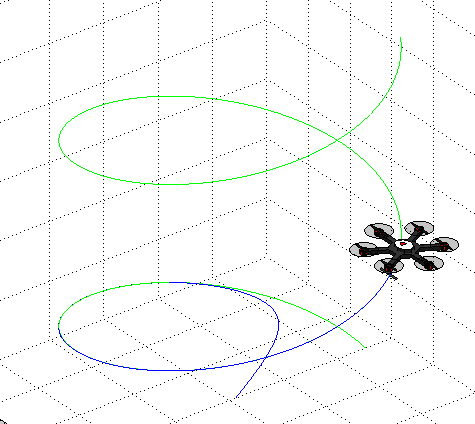
MATLAB/Drone/Trayectoria3.png
