0-0REL/Dron/MATLAB/simulink/SimuPoncy/imgenes/2dof-vs-mhpid.png

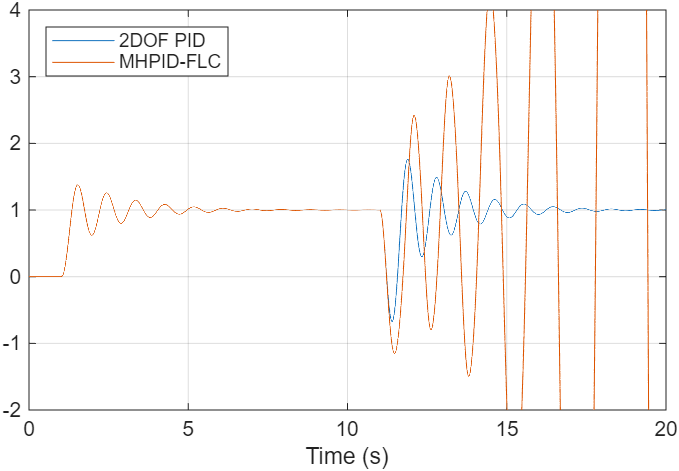
MATLAB/simulink/SimuPoncy/imgenes/2dof-vs-mhpid.png
