0-0REL/Dron/MATLAB/simulink/SimuPoncy/imgenes/arrgla22.png

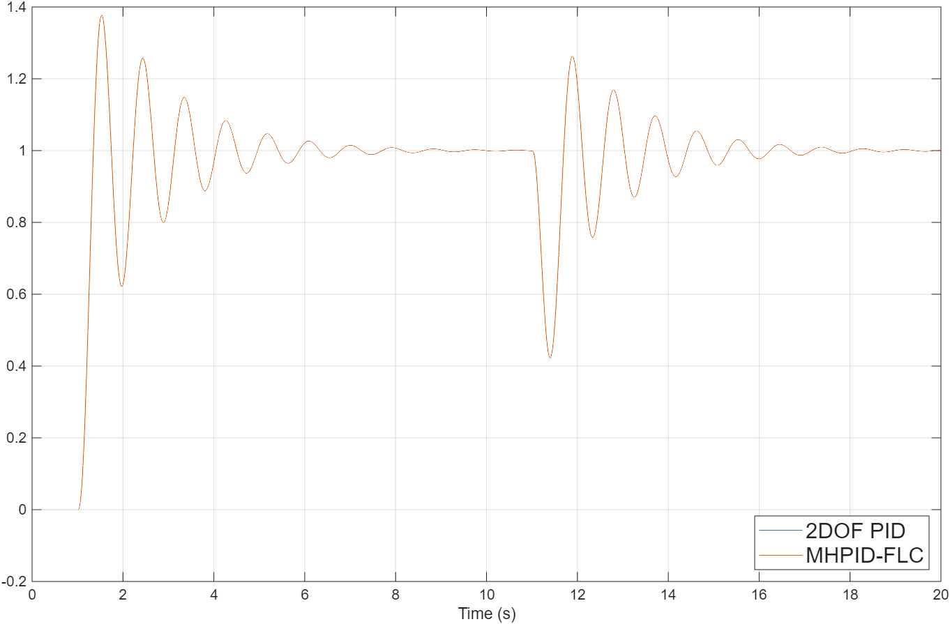
MATLAB/simulink/SimuPoncy/imgenes/arrgla22.png
