0-0REL/Dron/MATLAB/simulink/SimuPoncy/imgenes/conversion.png

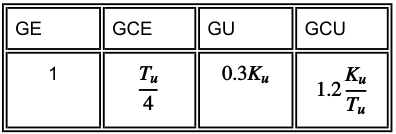
MATLAB/simulink/SimuPoncy/imgenes/conversion.png
