0-0REL/Dron/MATLAB/simulink/SimuPoncy/imgenes/ideal.png

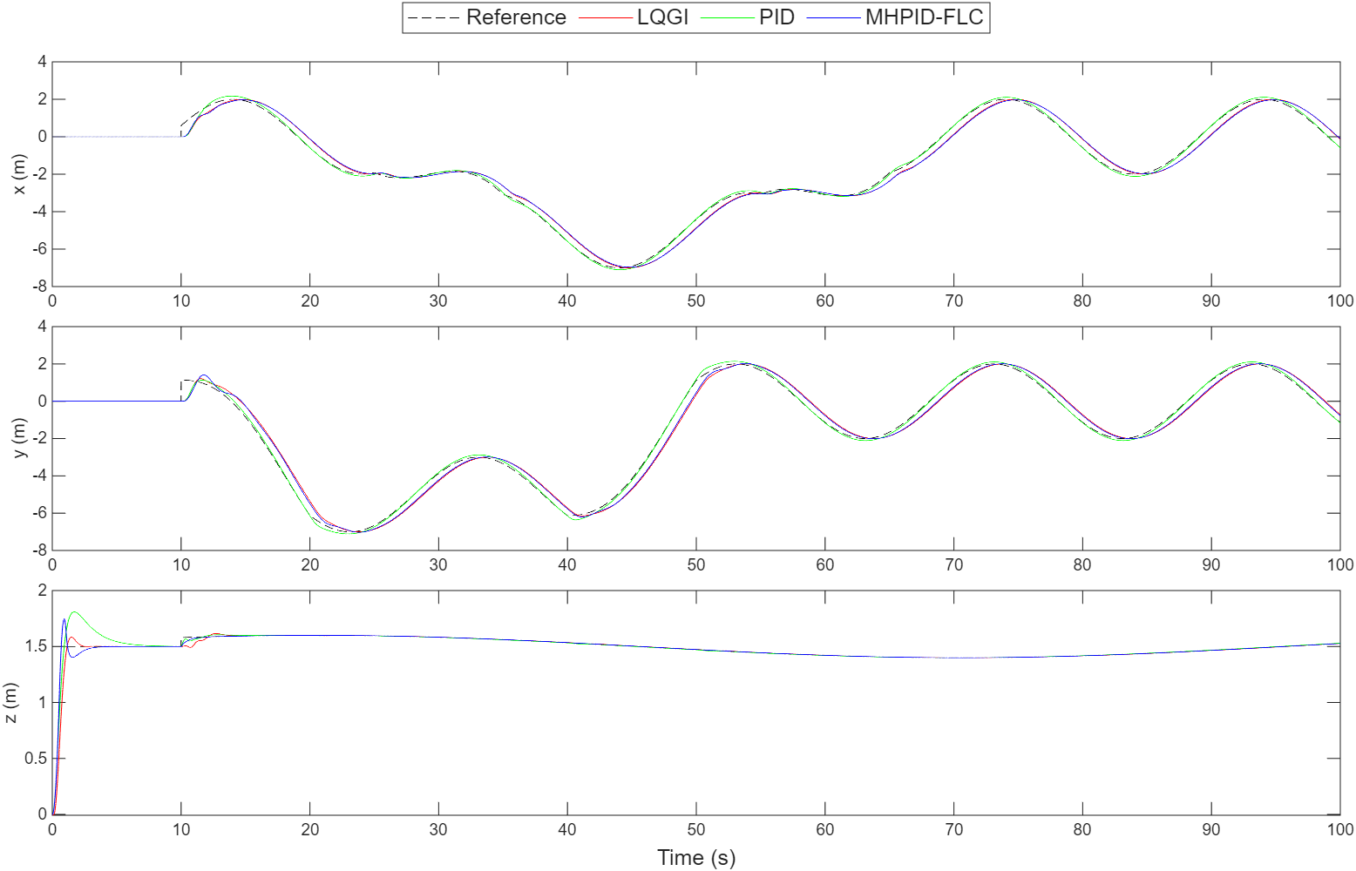
MATLAB/simulink/SimuPoncy/imgenes/ideal.png
