0-0REL/Dron/MATLAB/simulink/SimuPoncy/imgenes/lqgi.png

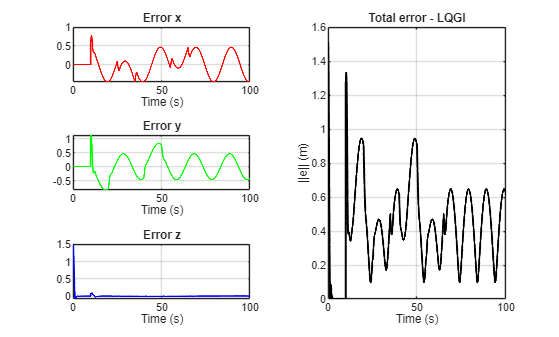
MATLAB/simulink/SimuPoncy/imgenes/lqgi.png
