0-0REL/Dron/MATLAB/simulink/SimuPoncy/imgenes/membership.png

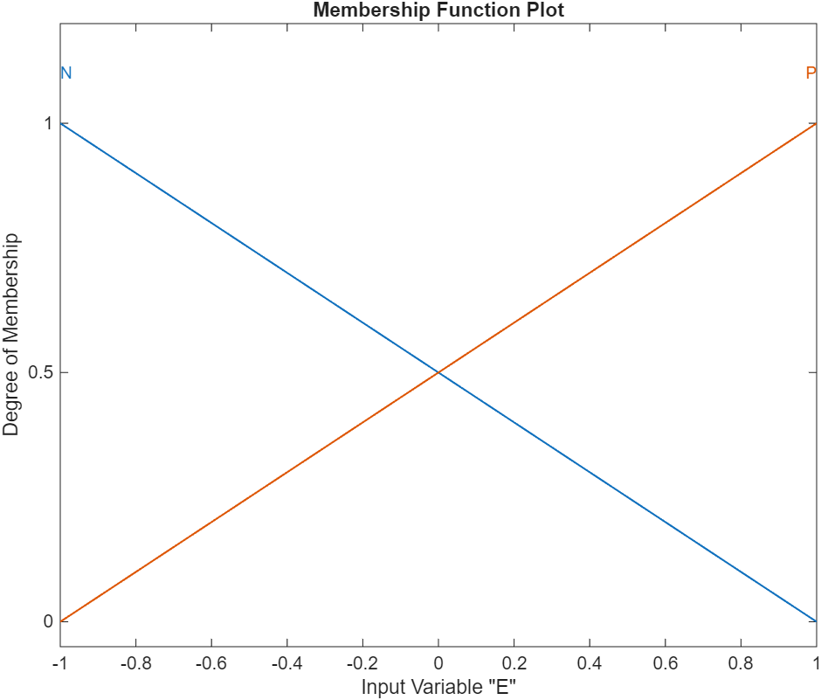
MATLAB/simulink/SimuPoncy/imgenes/membership.png
