0-0REL/Dron/MATLAB/simulink/SimuPoncy/imgenes/okasha.png

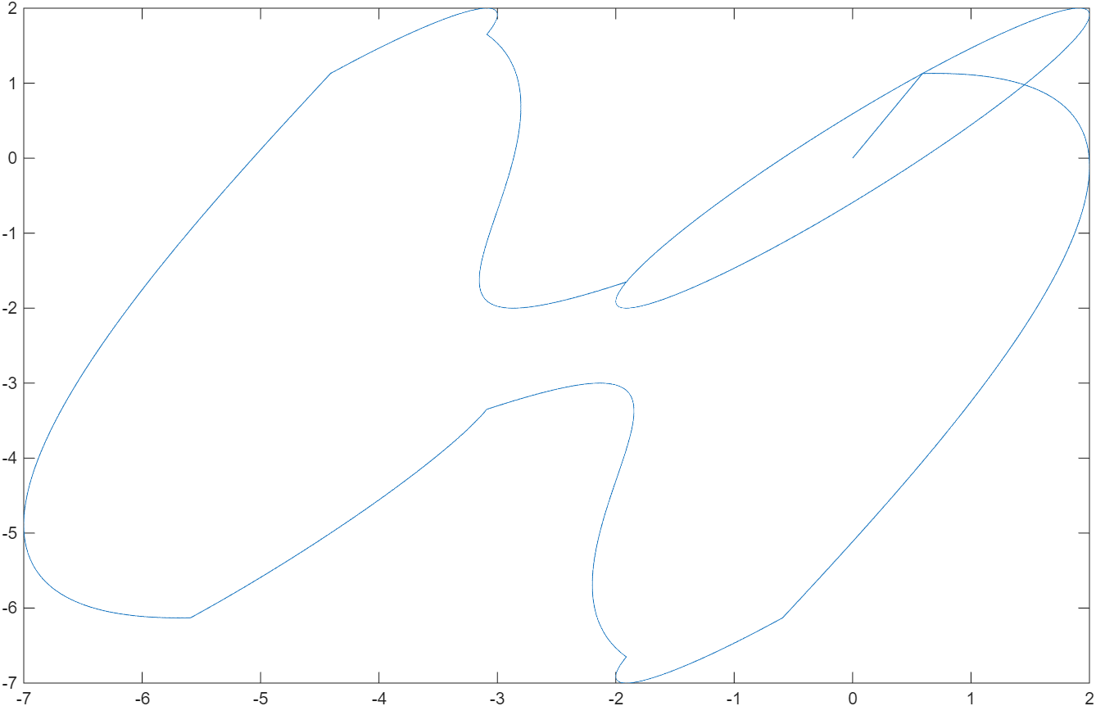
MATLAB/simulink/SimuPoncy/imgenes/okasha.png
