0-0REL/Dron/MATLAB/simulink/SimuPoncy/imgenes/perturbado.png

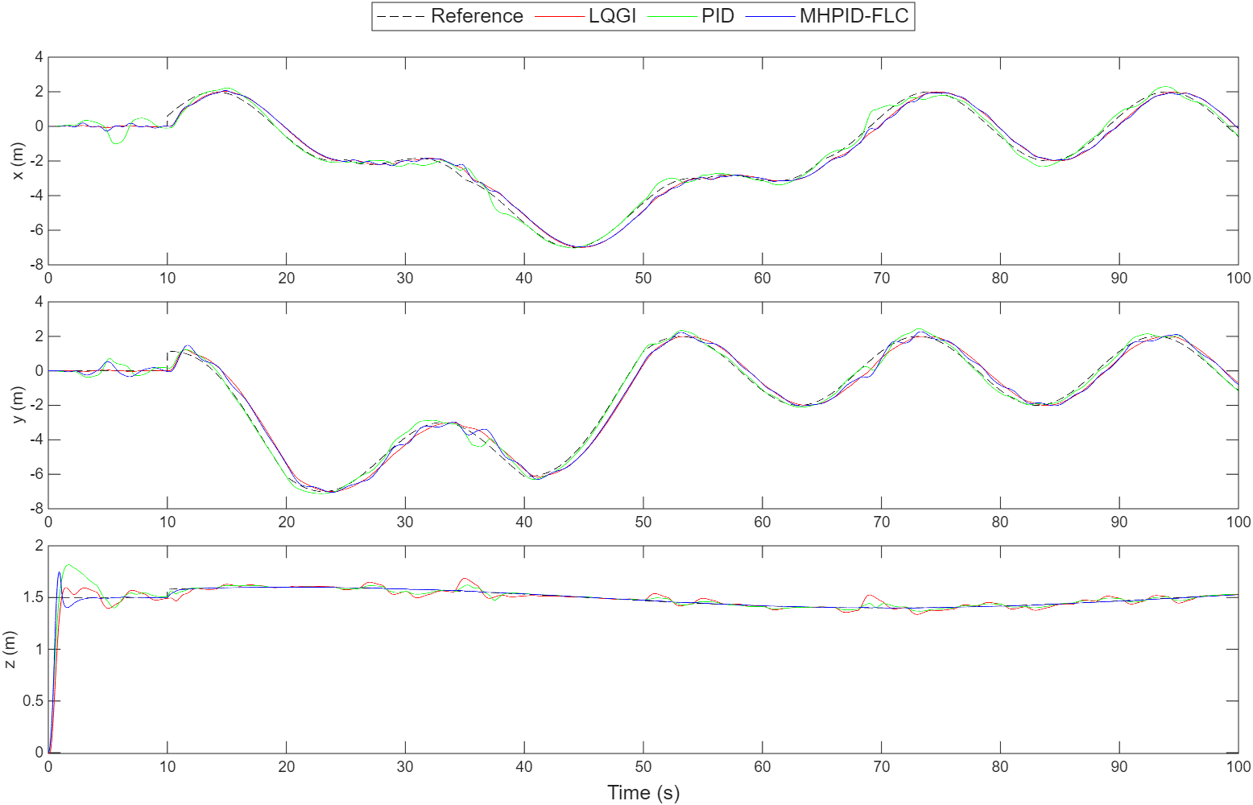
MATLAB/simulink/SimuPoncy/imgenes/perturbado.png
