0-0REL/Dron/MATLAB/simulink/SimuPoncy/imgenes/surface-control.png

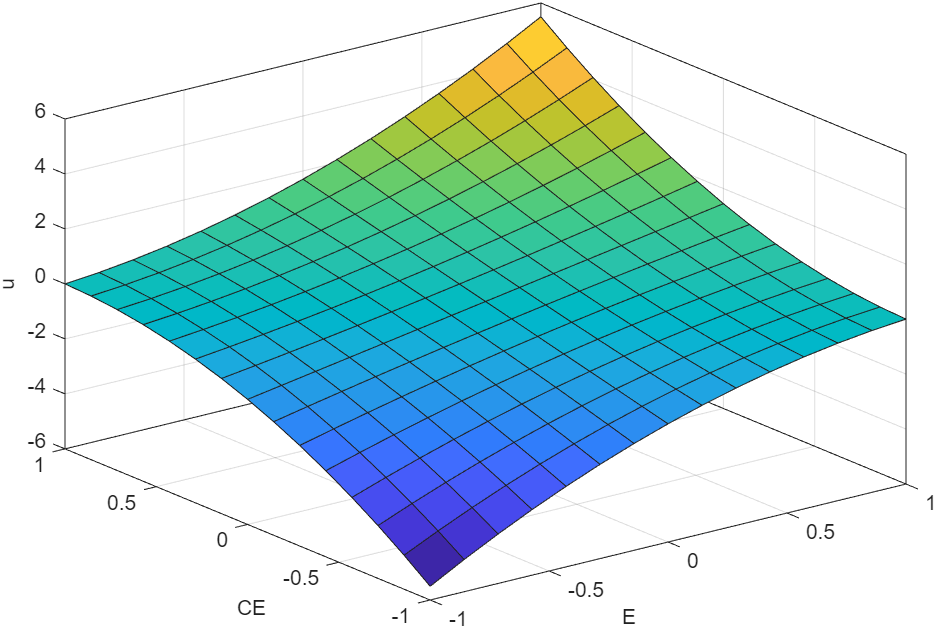
MATLAB/simulink/SimuPoncy/imgenes/surface-control.png
