0-0REL/Dron/MATLAB/simulink/SimuPoncy/imgenes/trayectoria.png

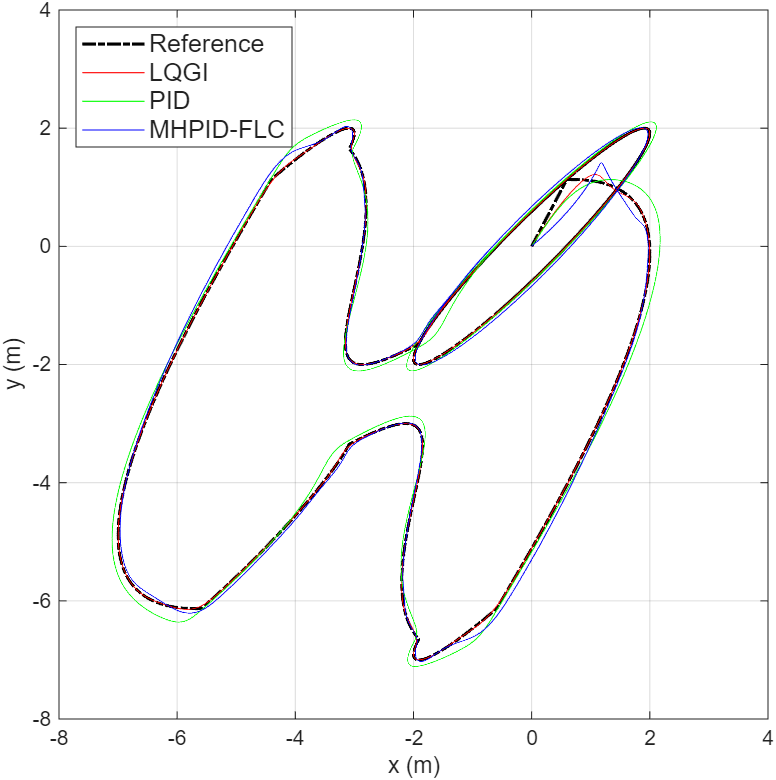
MATLAB/simulink/SimuPoncy/imgenes/trayectoria.png
