0-0REL/Dron/(list of files, cad)

Other CAD files:
Complementos/CAD/carcasa para rpi4 y navio2.dwg
Complementos/CAD/Soporte de pruebas.dwg
Complementos/CAD/1VibroNavio2bot_rev_A.ipt
Complementos/CAD/ESC.ipt
Complementos/CAD/Ensa_carcasa.iam
Complementos/CAD/GEMFAN 11x4.7.ipt
Complementos/CAD/NAVIO2.ipt
Complementos/CAD/RPI4.ipt
Complementos/CAD/Soporte_bateria_p1.ipt
Complementos/CAD/VibroNavio2top_rev_A.ipt
Complementos/CAD/antivibracion.ipt
Complementos/CAD/antivibracionv2.ipt
Complementos/CAD/brazo.ipt
Complementos/CAD/dron.iam
Complementos/CAD/limite.ipt
Complementos/CAD/motor.ipt
Complementos/CAD/motor_prueba.ipt
Complementos/CAD/pata.ipt
Complementos/CAD/pataUnion.ipt
Complementos/CAD/posteNAVIO.ipt
Complementos/CAD/protector.ipt
Complementos/CAD/protectorv2.ipt
Complementos/CAD/relleno.ipt
Complementos/CAD/soporte_v2.ipt
Complementos/CAD/swtc1.ipt
Complementos/CAD/swtc2.ipt
