0-0REL/Dron/doc/Imagenes/step_alt_lqi.png

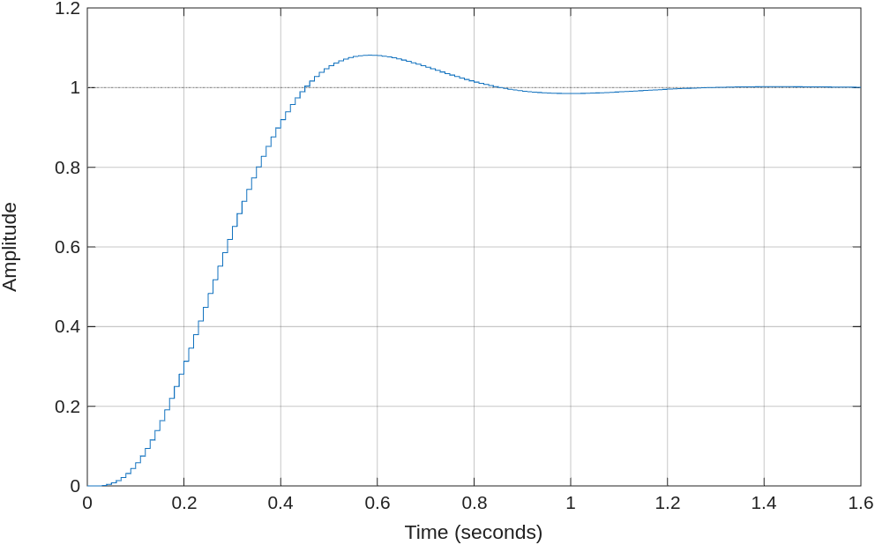
doc/Imagenes/step_alt_lqi.png
