0-0REL/Dron/doc/Imagenes/step_att_lqr.png

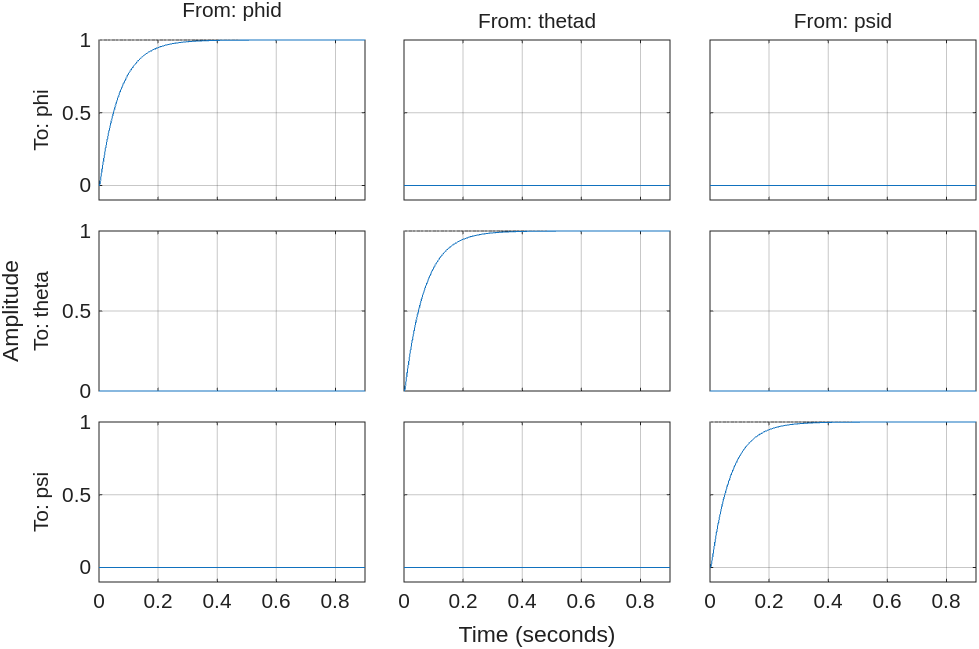
doc/Imagenes/step_att_lqr.png
