0-0REL/Dron/OpenCV/pruebas/README.md

# Pruebas para hacer la vision

docu - ejemplo de como usar mediapipe segun la documentacion. Todo bien

prueba1 - prueba con api antigua (solutions). Funciona

seguidor - mediapipe con un seguidor, csrt funciona bien - en rpi no funciono de con el mismo rendimiento

seguimiento_deep - intento de deep de mejorar seguidor - parace una muy sutil mejora

tutorial - mediapipe tuturial de youtube api vieja (solutions)

zoom_deep - inteto de deep por dar más rango a mediapipe - no funciono

[deopcv](/pruebas/vision/deopcv.py) Funciona mejor el de mediapipe
