0-0REL/Dron/MATLAB/simulink/SimuPoncy/imgenes/prueba_lqi.png

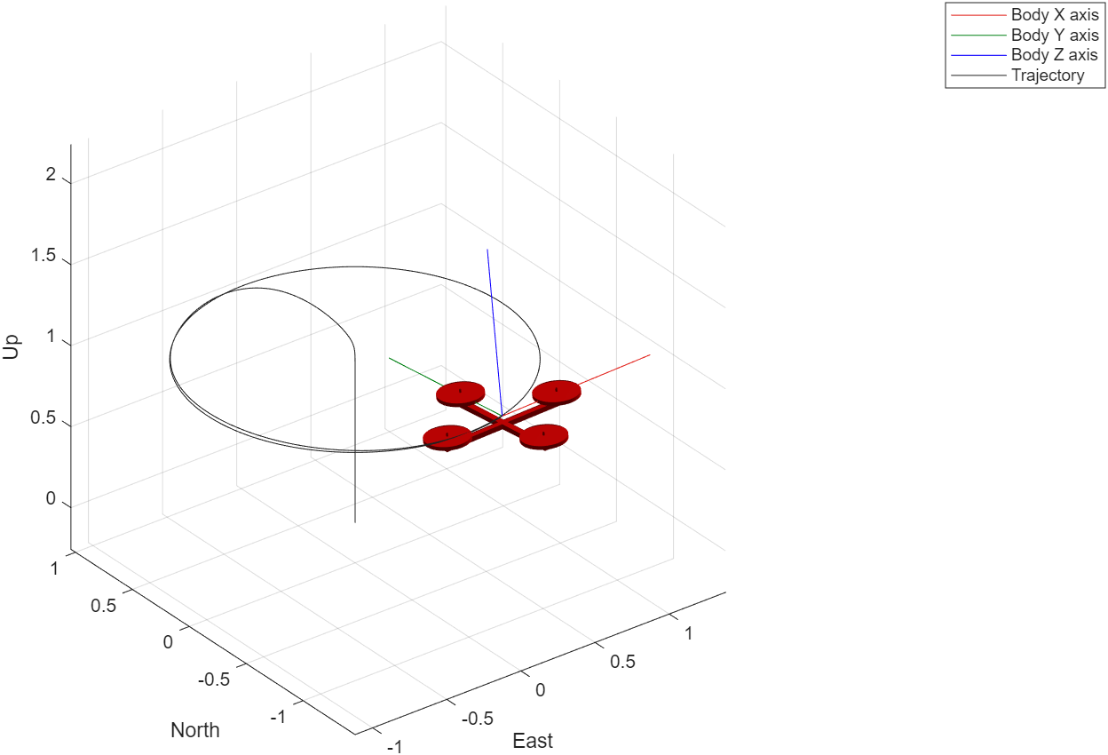
MATLAB/simulink/SimuPoncy/imgenes/prueba_lqi.png
