0-0REL/Dron/MATLAB/simulink/SimuPoncy/imgenes/prueba_mhpid.png

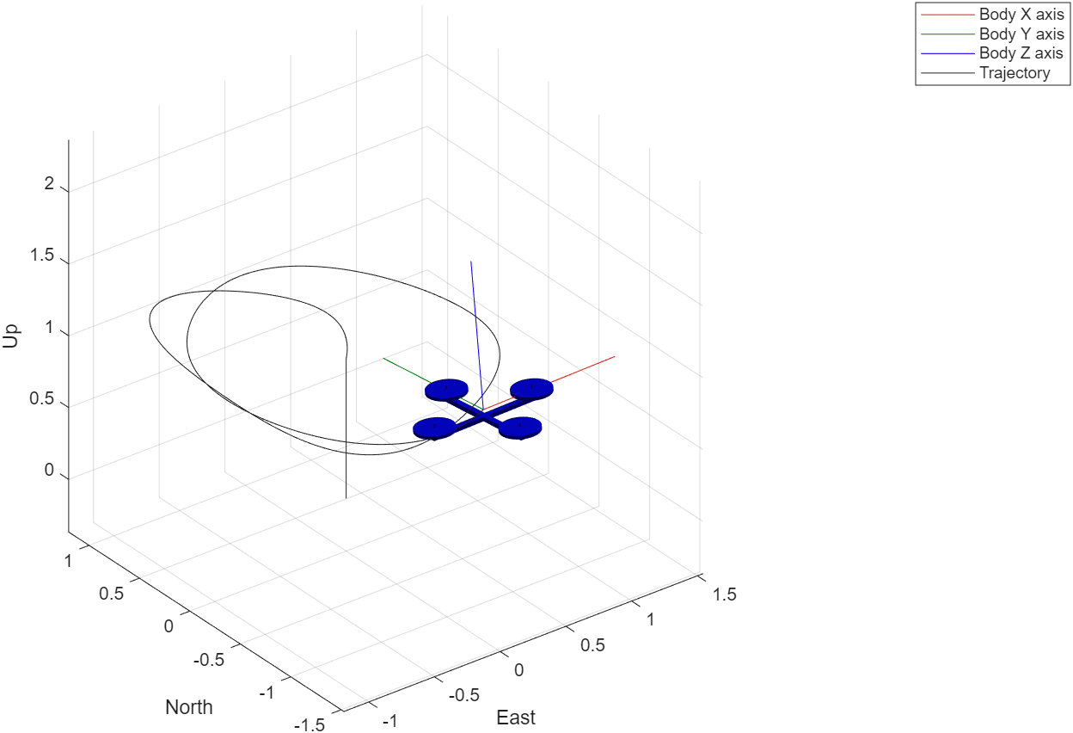
MATLAB/simulink/SimuPoncy/imgenes/prueba_mhpid.png
