0-0REL/Dron/MATLAB/simulink/SimuPoncy/imgenes/prueba_pid.png

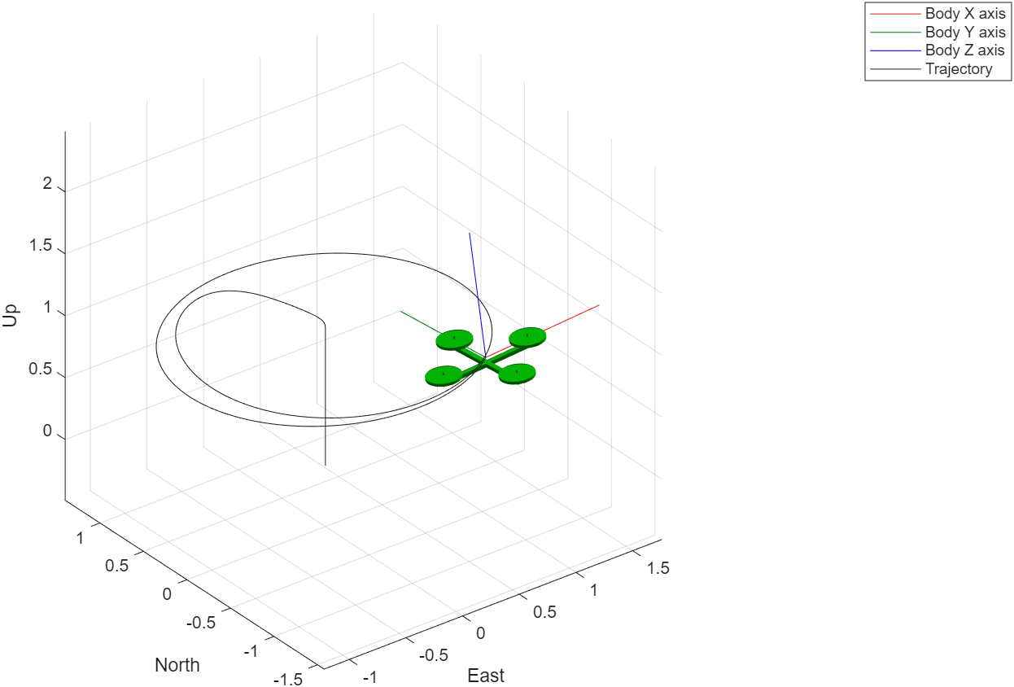
MATLAB/simulink/SimuPoncy/imgenes/prueba_pid.png
