0-0REL/Dron/ArduPilot/Bitacora.pdf

## 1. 20 de Mayo - Despegue y aterrizaje

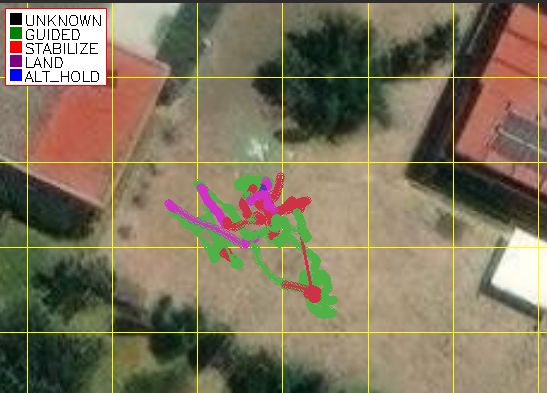
[picture p75: figure]

Figura 1: Recorrido

### 1.1. Fallos en el despegue

NAV CONTROLLER OUTPUT mensajes que pudieron causar la volcadura del dron.

nav roll roll deseado

nav pitch pitch deseado

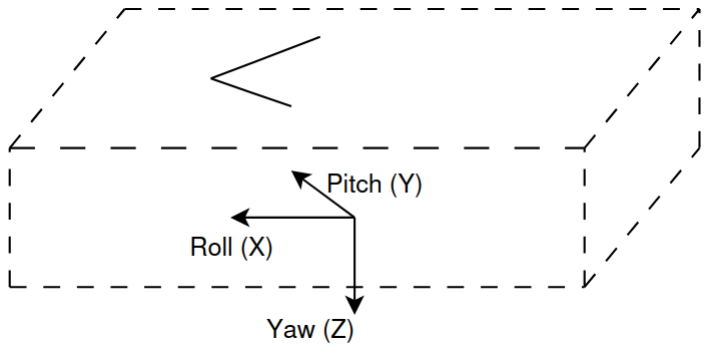
[picture p76: figure]

Figura 2: Ejes del dron

El primer fallo, segunda prueba, comienza a las 14:44:33.29, figura 3, los motores 2 y 4 comenzar´ıan a acelerar y 1 y 3 har´ıan lo opuesto. La orientaci´on del dron comienza a variar a las 14:44:33.54 bajando la nariz, figura 4. Antes de que el dron se despegue del suelo NAV CONTROLLER env´ıa una se˜nal de rotaci´on negativa sobre pitch a las 14:44:33.05, figura 3.

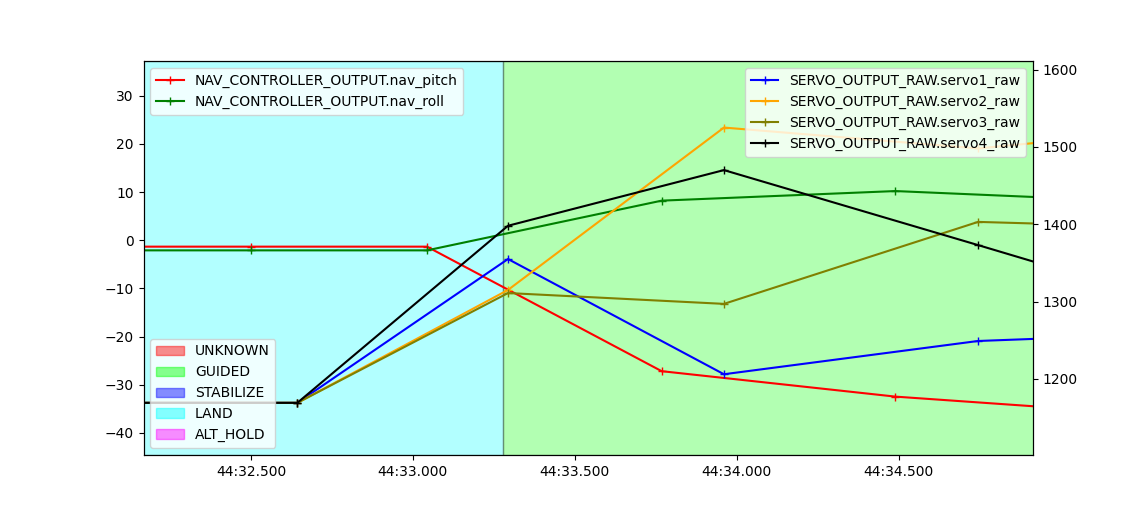
[picture p77: figure]

Figura 3: Primer fallo. Nav - Motores

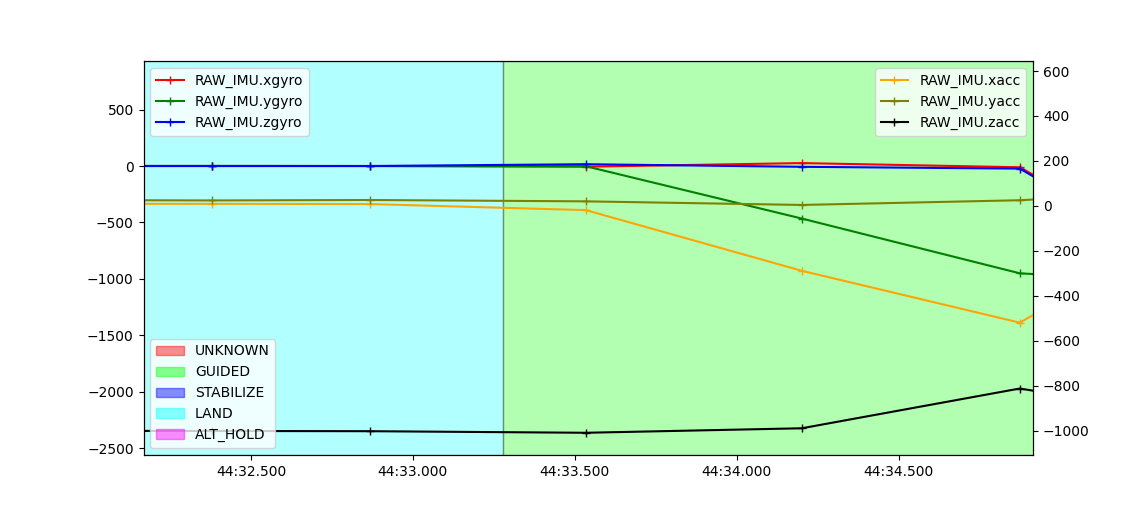
[picture p78: figure]

Figura 4: Primer fallo. IMU

El dron termina por volcarse a las 14:44:36, figura 5.

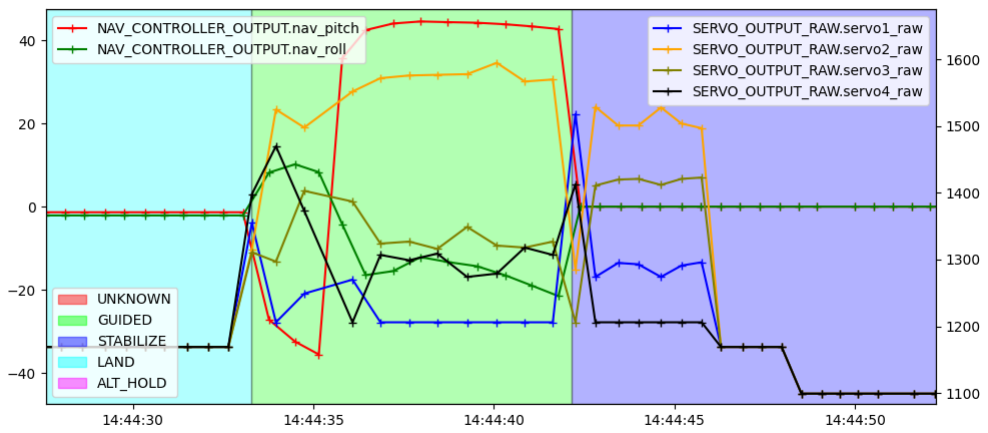
[picture p79: figure]

Figura 5: Volcadura del dron

Prueba 4 el despegue falla, figura 6, comienza a las 14:51:48, a las 14:51:49.55 NAV CONTRO-LLER comienza a realizar correcciones, pero apenas hay movimiento, figura 7.

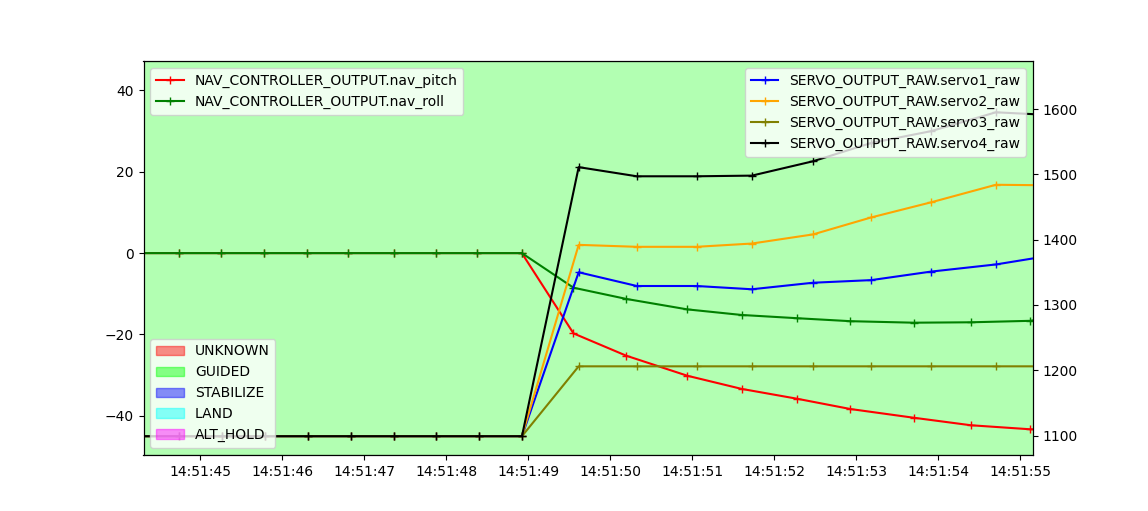
[picture p80: figure]

Figura 6: Segundo fallo. Nav - Motores

El dron esta estable pero aun as´ı realiza correcciones de roll y pitch, figura 8.

Figura 7: Segundo fallo. IMU

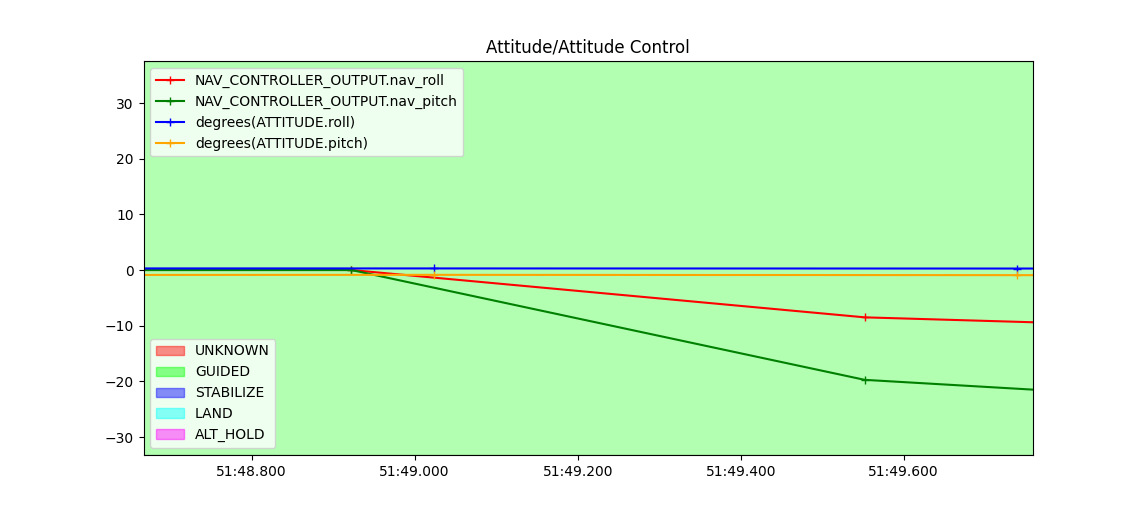
[picture p81: figure]

Figura 8: Segundo fallo. Actitud - Nav

Prueba 4 termina en volcadura a las 14:51:57, figura 9.

Figura 9: Volcadura

Sexta prueba el despgue falla, comportamiento similar a la cuarta prueba, figuras 10, 11 y 12.

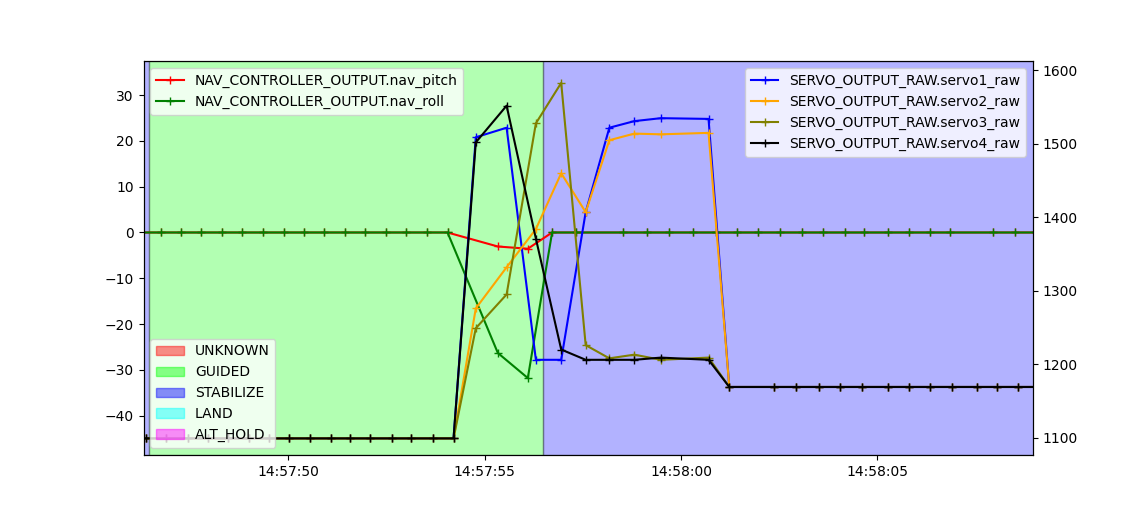
[picture p82: figure]

Figura 10: Tercer fallo. Nav - Motores

Figura 11: Tercer fallo. IMU

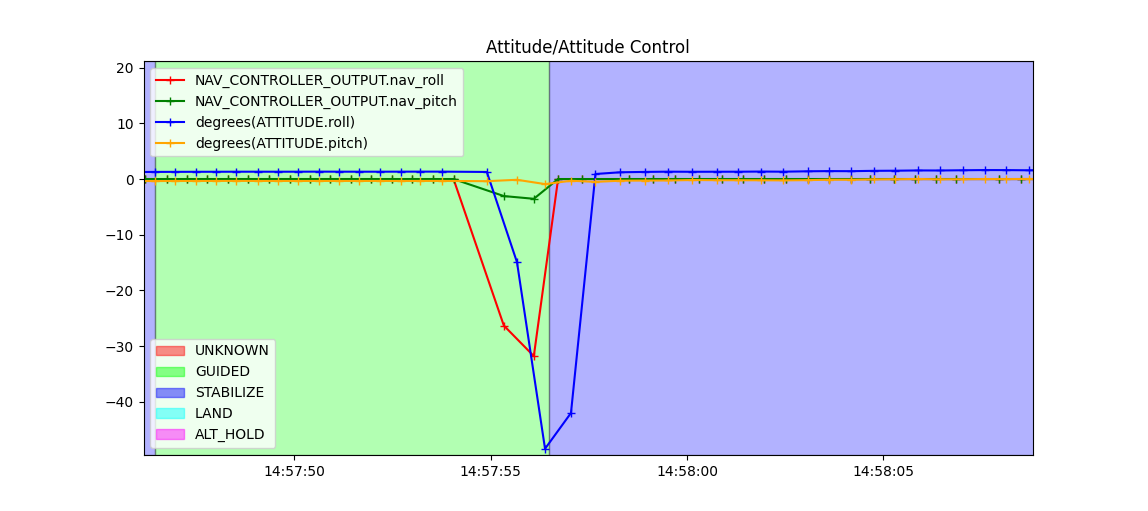
[picture p83: figure]

Figura 12: Tercer fallo. Actitud - Nav

### 1.2. Despegue correcto

En el primer despegue, prueba 1, comienza a las 14:43:45, el dron despega correctamente, figuras 13 y 14. La se˜nal de NAV CONTROLLER coincide con el inicio del despegue.

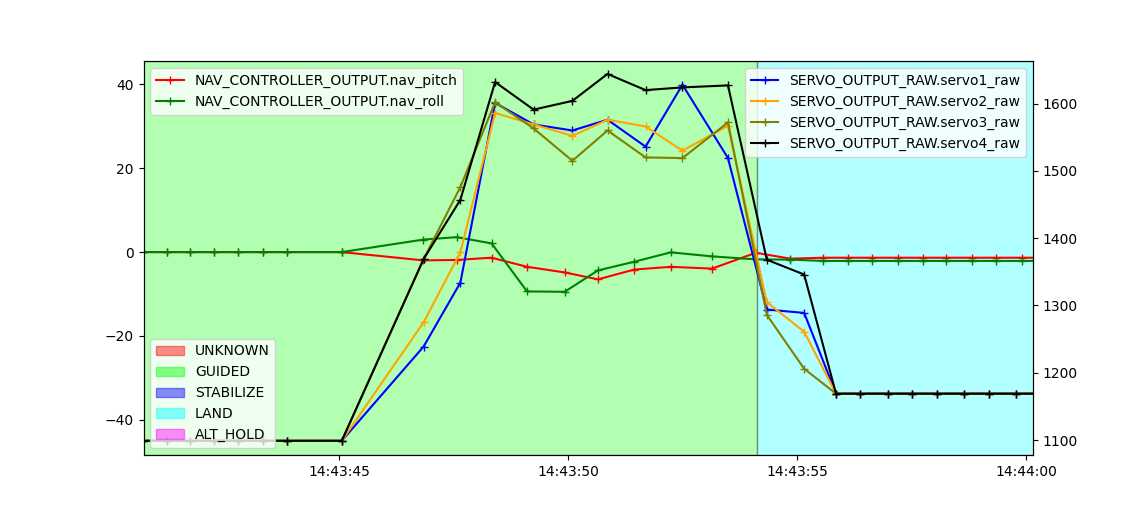
[picture p84: figure]

Figura 13: Primer despegue. NAV - Motores

En la tercera prueba, el dron despega correctamente, el despegue comienza a las 14:47:48. Aunque acumula un error en NAV CONTROLLER comienza a corregirse cuando inicia el despegue, figura 15, diferente al primer fallo que NAV CONTROLLER reacciona hasta que el dron se volc´o, figura 5.

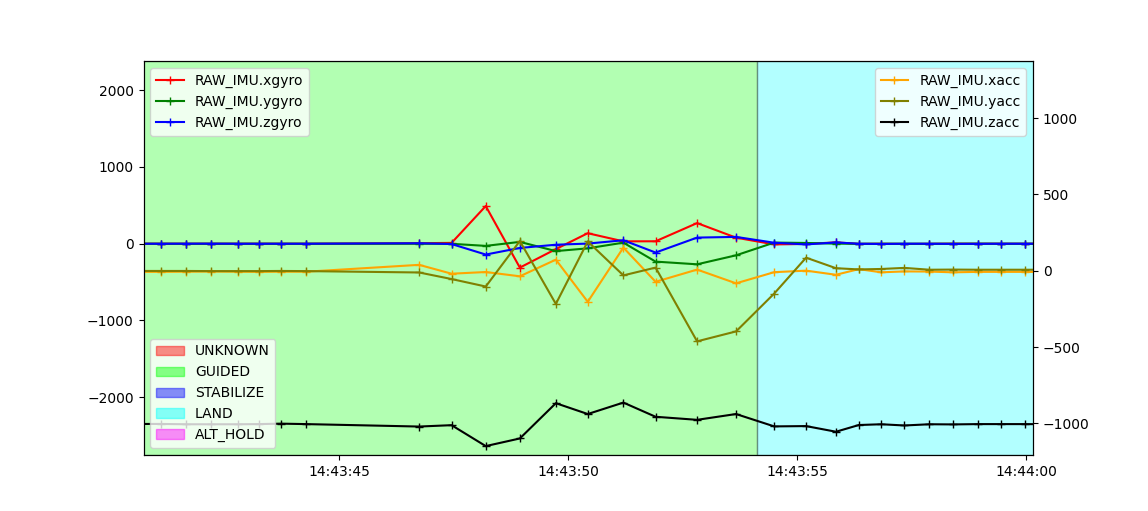
[picture p85: figure]

Figura 14: Primer despegue. IMU

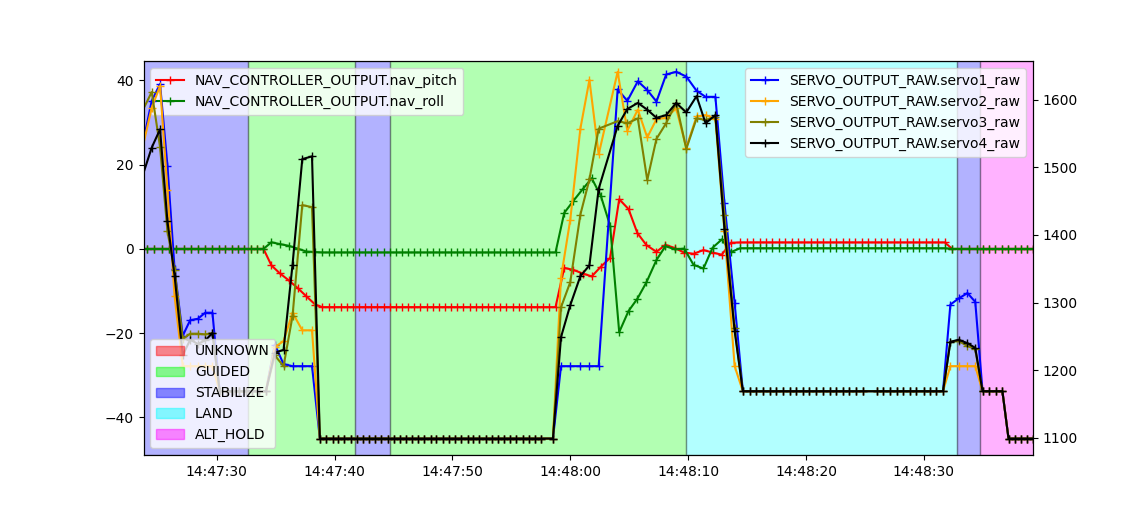
[picture p86: figure]

Figura 15: Segundo despegue. NAV - Motores

Quinta prueba despegue correcto, figura 16, el NAV CONTROLLER da como m´aximo 7.42 grados a las 14:56:11.

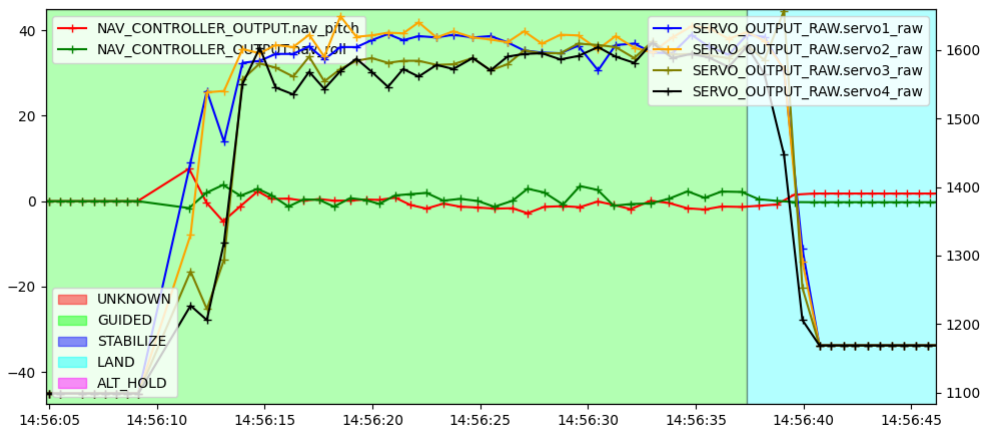
[picture p87: figure]

Figura 16: Tercer despegue. NAV - Motores
