0-0REL/Dron/Complementos/CAD/soporte.pdf

## A-A ( 1 : 1 ) / .E3

A / .E5

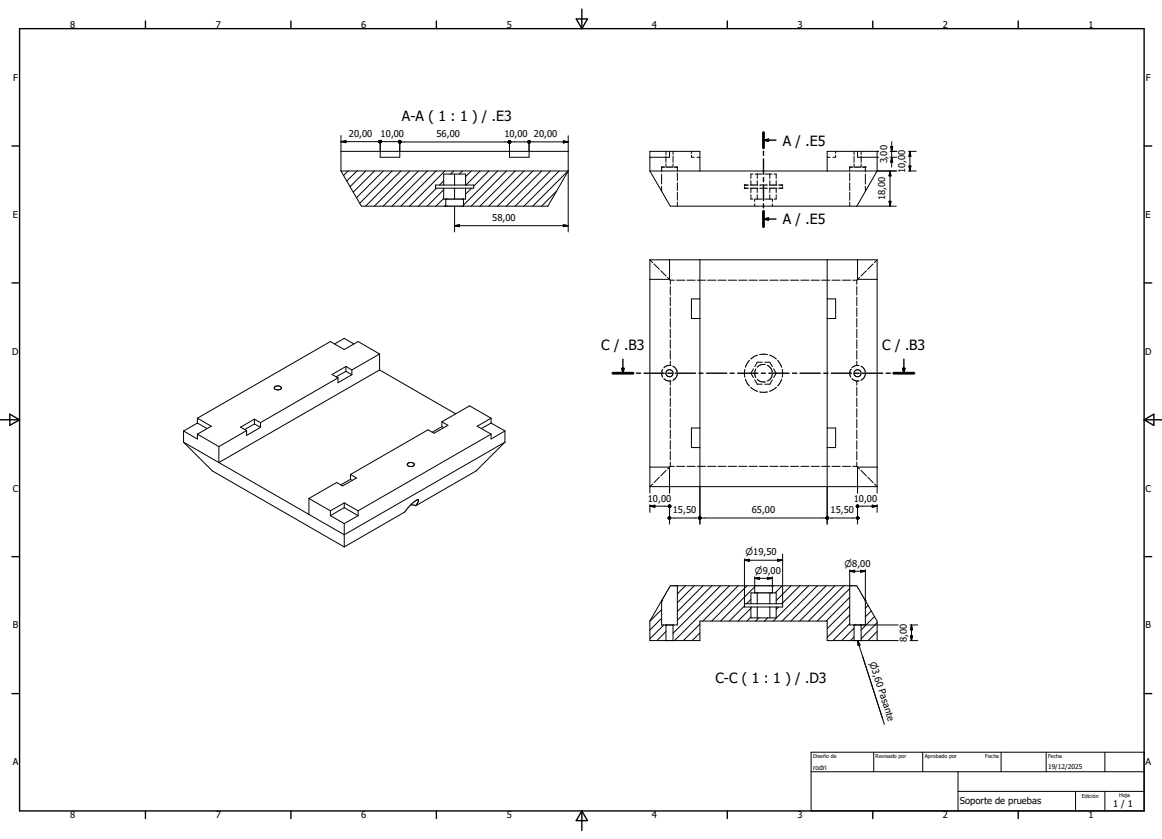
[picture p88: page 1]
rodri; 19/12/2025 Diseño de; Revisado por; Aprobado por; Fecha; 1 / 1 Edición; Hoja; n3,60 Pasante n8,00 8,00

Soporte de pruebas
