0-0REL/Dron/ArduPilot/Dron/logs/2025-05-28/flight1/mav.parm

ATC_ANGLE_BOOST  1.000000
ATC_ANG_LIM_TC   1.000000
ATC_ANG_PIT_P    4.500000
ATC_ANG_RLL_P    4.500000
ATC_ANG_YAW_P    4.500000
ATC_RATE_FF_ENAB 1.000000
ATC_RATE_P_MAX   0.000000
ATC_RATE_R_MAX   0.000000
ATC_RATE_Y_MAX   0.000000
ATC_RAT_PIT_D    0.003600
ATC_RAT_PIT_FF   0.000000
ATC_RAT_PIT_FLTD 20.000000
ATC_RAT_PIT_FLTE 0.000000
ATC_RAT_PIT_FLTT 20.000000
ATC_RAT_PIT_I    0.135000
ATC_RAT_PIT_IMAX 0.500000
ATC_RAT_PIT_P    0.135000
ATC_RAT_RLL_D    0.003600
ATC_RAT_RLL_FF   0.000000
ATC_RAT_RLL_FLTD 20.000000
ATC_RAT_RLL_FLTE 0.000000
ATC_RAT_RLL_FLTT 20.000000
ATC_RAT_RLL_I    0.135000
ATC_RAT_RLL_IMAX 0.500000
ATC_RAT_RLL_P    0.135000
ATC_RAT_YAW_D    0.000000
ATC_RAT_YAW_FF   0.000000
ATC_RAT_YAW_FLTD 0.000000
ATC_RAT_YAW_FLTE 2.500000
ATC_RAT_YAW_FLTT 20.000000
ATC_RAT_YAW_I    0.018000
ATC_RAT_YAW_IMAX 0.500000
ATC_RAT_YAW_P    0.180000
BATT2_MONITOR    0.000000
BATT3_MONITOR    0.000000
BATT4_MONITOR    0.000000
BATT5_MONITOR    0.000000
BATT6_MONITOR    0.000000
BATT7_MONITOR    0.000000
BATT8_MONITOR    0.000000
BATT9_MONITOR    0.000000
BATT_MONITOR     0.000000
FLTMODE1         0.000000
FLTMODE2         0.000000
FLTMODE3         0.000000
FLTMODE4         0.000000
FLTMODE5         0.000000
FLTMODE6         0.000000
FLTMODE_CH       5.000000
FRAME_CLASS      0.000000
FRAME_TYPE       1.000000
INS_GYRO_FILTER  20.000000
INS_HNTCH_ENABLE 0.000000
MOT_BAT_CURR_MAX 0.000000
MOT_BAT_CURR_TC  5.000000
MOT_BAT_IDX      0.000000
MOT_BAT_VOLT_MAX 0.000000
MOT_BAT_VOLT_MIN 0.000000
MOT_BOOST_SCALE  0.000000
MOT_HOVER_LEARN  2.000000
MOT_PWM_MAX      0.000000
MOT_PWM_MIN      0.000000
MOT_PWM_TYPE     0.000000
MOT_SAFE_DISARM  0.000000
MOT_SAFE_TIME    1.000000
MOT_SLEW_DN_TIME 0.000000
MOT_SLEW_UP_TIME 0.000000
MOT_SPIN_ARM     0.100000
MOT_SPIN_MAX     0.950000
MOT_SPIN_MIN     0.150000
MOT_SPOOL_TIME   0.500000
MOT_THST_EXPO    0.650000
MOT_THST_HOVER   0.350000
MOT_YAW_HEADROOM 200.000000
SERIAL0_BAUD     115.000000
SERIAL0_PROTOCOL 2.000000
SERIAL1_BAUD     57.000000
SERIAL1_OPTIONS  0.000000
SERIAL1_PROTOCOL 1.000000
SERIAL2_BAUD     57.000000
SERIAL2_OPTIONS  0.000000
SERIAL2_PROTOCOL 1.000000
SERIAL3_BAUD     38.000000
SERIAL3_OPTIONS  0.000000
SERIAL3_PROTOCOL 5.000000
SERIAL4_BAUD     38.000000
SERIAL4_OPTIONS  0.000000
SERIAL4_PROTOCOL 5.000000
SERIAL5_BAUD     57.000000
SERIAL5_OPTIONS  0.000000
SERIAL5_PROTOCOL -1.000000
SERIAL6_BAUD     57.000000
SERIAL6_OPTIONS  0.000000
SERIAL6_PROTOCOL -1.000000
SERIAL7_BAUD     57.000000
SERIAL7_OPTIONS  0.000000
SERIAL7_PROTOCOL -1.000000
SERVO1_FUNCTION  0.000000
SERVO1_MAX       1900.000000
SERVO1_MIN       1100.000000
SERVO1_REVERSED  0.000000
SERVO1_TRIM      1500.000000
SERVO2_FUNCTION  0.000000
SERVO2_MAX       1900.000000
SERVO2_MIN       1100.000000
SERVO2_REVERSED  0.000000
SERVO2_TRIM      1500.000000
SERVO3_FUNCTION  0.000000
SERVO3_MAX       1900.000000
SERVO3_MIN       1100.000000
SERVO3_REVERSED  0.000000
SERVO3_TRIM      1500.000000
SERVO4_FUNCTION  0.000000
SERVO4_MAX       1900.000000
SERVO4_MIN       1100.000000
SERVO4_REVERSED  0.000000
SERVO4_TRIM      1500.000000
SERVO5_FUNCTION  0.000000
SERVO5_MAX       1900.000000
SERVO5_MIN       1100.000000
SERVO5_REVERSED  0.000000
SERVO5_TRIM      1500.000000
SERVO6_FUNCTION  0.000000
SERVO6_MAX       1900.000000
SERVO6_MIN       1100.000000
SERVO6_REVERSED  0.000000
SERVO6_TRIM      1500.000000
SERVO7_FUNCTION  0.000000
SERVO7_MAX       1900.000000
SERVO7_MIN       1100.000000
SERVO7_REVERSED  0.000000
SERVO7_TRIM      1500.000000
SERVO8_FUNCTION  0.000000
SERVO8_MAX       1900.000000
SERVO8_MIN       1100.000000
SERVO8_REVERSED  0.000000
SERVO8_TRIM      1500.000000
SERVO9_FUNCTION  0.000000
SERVO9_MAX       1900.000000
SERVO9_MIN       1100.000000
SERVO9_REVERSED  0.000000
SERVO9_TRIM      1500.000000
