0-0REL/Dron/(commit log)

2025-04-10 Detección como la documentacion de mediapipe
2025-06-18 Archivos de configuración
2026-02-26 Simulaciones para Drone y trayectoria
2026-02-26 archivos de ponci
